WHU-SAS/aic-robot/README.md

# AIC Robot｜视觉追踪与自主抓取机器人

基于 **K230 与 MSPM0** 的移动抓取机器人，面向 **20 mm 蓝色方块**，完成视觉追踪、底盘接近、停车定位和机械臂抓取，并在夹取失败或目标丢失后恢复任务。

当前主线由 K230 运行视觉、语音与任务逻辑，MSPM0 执行底盘控制；整车任务在板端运行，电脑用于开发、部署与调试。

## 功能演示

三段实物演示，分别展示正常流程与两种异常恢复。**以下视频均为 2 倍速播放，标注时长为视频播放时长，非实际任务耗时。**

### ① 自主追踪抓取 · 约 9 秒 · 2 倍速

**正常任务：** 追踪方块 → 接近停车 → 定位抓取 → 抬升。

https://github.com/user-attachments/assets/8727d0c5-af14-46ac-8d45-5f98477f9e53

### ② 夹取失败重试 · 约 14 秒 · 2 倍速

**看点：** 首次夹取未成功后，机器人恢复观察、重新定位并再次尝试抓取。

https://github.com/user-attachments/assets/ede22e75-522a-4e8c-8239-ee370f32e1b9

### ③ 目标重搜与追踪 · 约 13 秒 · 2 倍速

**看点：** 方块被人为移开后，机器人重新搜索，找到目标并恢复追踪。

https://github.com/user-attachments/assets/4cd675e8-9e65-4bd4-8ff4-0e870b1a4405

视频展示单次实物运行场景，重复运行的稳定性、成功率与定位精度仍需单独验证和统计。

## 系统组成

| 组成 | 职责 |
| --- | --- |
| **K230** | 语音触发、视觉定位与目标追踪、整车任务调度及机械臂指令 |
| **MSPM0** | 车轮速度、直行与转向控制，以及编码器反馈 |
| **六轴机械臂** | 停车后执行定位抓取与抬升 |

K230 通过 UART 与 MSPM0 通信，并通过 URT-2 连接机械臂舵机。硬件型号、供电和接线见 [硬件说明](docs/hardware/connections.md)。

## 当前进展

| 范围 | 状态 |
| --- | --- |
| **已演示** | 自主追踪抓取、夹取失败重试、目标丢失后的重搜与追踪，见上方视频 |
| **仍在验证** | 重复运行稳定性、任务成功率、定位与抓取精度，以及不同场景下的表现 |
| **尚未实现** | 指定位置放置、独立视觉持物验证 |

当前夹住判断依据夹爪舵机反馈，不等同于独立视觉确认；相机标定的拟合误差也不直接代表实物抓取精度。当前版本、测试条件和验证边界见 [全流程追踪说明](docs/guides/full-process-tracking.md)。

## 文档导航

| 想了解什么 | 从这里开始 |
| --- | --- |
| **项目展示素材** | [精选图片、简要介绍与可复制片段](docs/showcase/README.md) |
| **人机协作复盘** | [我与 AI 如何协作：方案审查、实机反馈与项目纠偏](docs/ai-collaboration/README.md) |
| **整车运行与部署** | [完整任务指南](docs/guides/robot-task.md) · [当前追踪流程](docs/guides/full-process-tracking.md) |
| **视觉与抓取实现** | [视觉模块](docs/guides/vision.md) · [机械臂基线与参数](docs/guides/arm/BASELINE.md) |
| **硬件与接线** | [硬件型号、供电和连接](docs/hardware/connections.md) |
| **开发、编译与联调** | [板端测试与固件工具](docs/guides/k230-and-mspm0.md) · [Linux PC 辅助环境](docs/guides/linux-arm.md) |
| **早期演示与对照** | [第 0 版 PC 辅助抓取](demos/v0_blue_pick/README.md) |

行驶时机械臂保持准备位与扭矩，停车后执行抓取；操作要求见 [准备位说明](docs/guides/arm/准备位脚本.md)。

代码按运行位置组织：`device/` 为板端程序，`host/` 与 `tools/` 为 PC 端程序及开发工具，`configs/` 为运行配置，`models/` 为机械臂模型。早期 PC 辅助方案保留作对照，与当前板端主线分开说明。

## 源码可见与使用许可

本项目整体未采用开源许可证。团队原创且未另行授权的内容保留权利，额外使用须获得相关权利人许可，法律或已有授权另有规定的除外，详见 [版权与权限说明](LICENSE)。

第三方内容继续适用各自许可证，见 [第三方依赖](third_party/README.md)。公开查看和站内 Fork 按 GitHub 服务条款执行，不额外授予团队原创内容的自由运行、复用、修改或分发许可。
