WHU-SAS/aic-robot/car-arm/README.md

# 旧命令兼容入口

开发和运行使用 [仓库根目录](../README.md)。本目录只转发旧命令，不保存另一套代码或参数。

例如原 `./scripts/host hardware/move_ready.py --execute` 对应根目录 `./scripts/arm-ready --execute`；原 `hardware/k230_blue_pick_onboard.py` 对应 `./scripts/pick-blue`。新采集与日志在根目录 `data/`。
