WHU-SAS/aic-robot/device/mspm0/motor_uart/README.md

# K230 控制底盘：启停与状态回传

2026-11-03 已安装有限程FOLLOW固件，映像SHA为`c6eda69405f6b624d29537578bd91c0faed64667802b8ac6d634f1b6e09b8e31`。原始22888字节TI BSL CRC为`634b10e4`，按1024字节页填充至23552字节的TI CRC为`9940b381`；标准zlib CRC与TI口径不同，不混用。独立双映像CRC、写入范围外重复CRC及K230实际UART零轮速核验通过；未做非零有限程实车试跑。主控已启动且零输出，配套K230 `84482ada8908c040`已回归、安装并确认重启后持续监听，当前状态见[全流程指南](../../../docs/guides/full-process-tracking.md)。底盘与机械臂运行参数保持原基线。

## ARC与毫米级短MOVE（基本起转已验，精度待验）

新增请求体`M,SSSSSSSS,ARC,left_mm,right_mm`，两轮分别为−32767～32767整数毫米，正前进、负后退、0不驱动该轮。`ARC,0,0`仅在空闲时接受并以`reason=8`完成，双轮不输出；忙碌时仍拒绝新动作。普通ARC由每轮相对编码器行程执行，双轮分别截止，全部完成以`reason=8`结束。v2字段不变，`remaining_ms`仍是5秒运行预算，不是剩余轮程；不能只凭版本号2确认ARC能力。

短MOVE（绝对距离≤30mm）及ARC共用执行器：最大轮程≤30mm时主轮最高15mm/s，更长ARC使用`min(80,max(15,2×主轮剩余毫米数))`和原150mm/s²参考加减速，仍须在原5秒预算内完成。各轮按目标距离比例给速，归一化进度同步；先用原32计数/10ms缓升起转，行程到0.1mm后交给原PI，交接预置积分只允许0～500，不把低输出预置成负积分；正常PI本身仍可在原−500～500内调节，原32/10ms输出缓变保持。各轮按自身速度×0.08s、最小0.1mm预测滑行，独立撤去输出并锁定，不会因另一轮尚未结束而重新启动。MOVE仍以`reason=6`结束。长MOVE、TURN、FOLLOW的控制分支及共享PI公式保持；原20%输出上限、B21、1秒通信租期及5秒动作时限沿用，重复/过期命令不重启、不延长动作。0轮仍可因车身牵动被动滚动，不宣称机械锁止。

K230每次纠偏向固定停车目的点规划一段弧线，最多30°且各轮不超过100mm，再拍新图验窗。原单次对照包仍只允许一次纠偏；新`--tracking`入口取消纠偏次数上限，当前安装状态见小车指南。模型覆盖正反短MOVE、同比例/异比例/混合方向/单轮ARC、计数回绕及停后不重启；合成负载中的小误差不是实车毫米精度保证。升级须先下载并核验本固件，再激活配套K230包；零轮程ARC只验证通信和无输出，基础起转已短试，整车停车窗口仍需现场测试。

短动作合成模型最大短/长驱动轮误差由原约0.731/0.693mm增至约1.420/1.292mm，离线数值界明确改为1.5mm；保留全部完成、方向、停后不重启和既有限制检查。长MOVE原5%模型界及TURN/FOLLOW参数不变。这是修复起步的明确取舍，不能把模型界当作实物误差保证。

2026-10-30曾运行`v2+MOVE+TURN+FOLLOW`连续轮速版，USB/BSL下载、独立映像CRC及范围外Flash重复核验完成，17项底盘测试通过。K230零轮速FOLLOW→SPEED→STOP及停车后SPEED拒绝重启已通过原生检查。固定方块连续接近已接入一次移动细测、编码器补偿及停后窗口检查；用户认可K230版本`16060786e9fe3e29`的现场效果并暂定为基线，超过95%首次入窗尚未统计验收。当前固件支持有符号MOVE；原正向MOVE/TURN参数及保护保留，实际负向闭环微调仍待现场检验。当前入口与实验状态见[小车指南](../../../docs/guides/car-approach.md)。

前阶段适配器下左右5°、15°各5次共20次基础验证通过，用户确认方向正确、平顺、停后未再挪动，全部原因7及停后零输出；其后电池下单步及三轮自动分段视觉接近也已完成基本运行。旧TURN整链路比例0.75保留，新连续模式不用它。完整原始记录及失败证据保存在本机`data/car/turn/`及`data/car/visual_align/`。

## FOLLOW / SPEED：连续更新轮速

请求体`M,SSSSSSSS,FOLLOW,left_mm_s,right_mm_s`显式启动，`SPEED,left_mm_s,right_mm_s`仅更新正在运行的连续任务；两轮整数目标均为−80～80mm/s，正值向前。沿用v2应答格式；不能仅凭版本号2推断具备此能力。

启动仅一次清空轮速PI和参考速度。之后SPEED保留PI、PWM、速度参考及累计时限，每10ms根据编码器分别控制两轮；参考加减速150mm/s²，PWM每10ms最多变化32、上限1600/8000。有意转弯时两轮目标不同，不叠加旧MOVE的累计轮程同步。零轮速关闭固定前馈并将该轮输出降到零，STOP立即撤去双轮输出。

用户批准仅FOLLOW总时限为20秒，旧START/DRIVE/MOVE/TURN仍5秒；SPEED续原1秒通信租期但不重置20秒计时。B21、重复/过期命令语义及停车后不得自动重启不变；停止后SPEED返回result=3，必须另发新的FOLLOW才可启动。`remaining_ms`在新模式可达20000，reason=3现表示该模式的总时限到。旧`target_left/right`仍是PWM字段，不能当作mm/s；请求轮速保存在K230会话计划中。

本版有限前进增加可选第四项：`FOLLOW,L,R,D`从空闲启动，`SPEED,L,R,D`在原FOLLOW内更新；L、R为0～80mm/s，D为接收该命令时、尚未扣除滑行的正向名义剩余轮程，0～65535整数mm。主控锁存当时两轮编码器，按每10ms的平均轮程更新剩距，并沿用70/50mm/s、增益2及0.12秒滑行模型调速、以`reason=6`截止。更新不清PI、PWM、速度参考或20秒累计时限；重复/过期序号不重设端点。普通三项SPEED显式清除原有限程，反向搜索和慢退继续使用原有符号接口。

只有本次有限FOLLOW自行按距离结束后，新的带D轮速更新才允许返回成功应答的`run=0,reason=6`，不重新启动；其它停车原因和普通SPEED的拒绝语义不变。`FOLLOW,0,0,0`／`SPEED,0,0,0`可在空闲作零输出能力核验，不制造一次已执行的有限程任务。K230收到距离完成仍须拍新静图验窗，不能用旧行进图交臂。这是核心距离控制，不增加时限、重试上限或任务失败条件；需配套新固件，旧v2号不能证明支持D。名义轮程、曲线与滑行模型不保证真实物理停车误差，当前70/50/2及0.12参数变更须同步两端实现。

独立核验记录：`data/logs/mspm0_continuous_verify_20261030_180036/`及`mspm0_continuous_outside_start_20261030_180036/`。首次下载核验响应不一致仍保留，未重刷，后续独立映像两次CRC及范围外两段各两次CRC匹配后才启动。旧固件备份在`data/car/straight/sync_fix_20261030/sources/motor_uart.hex`。

底盘基础v2联调记录：2026-10-29通过USB/BSL下载，独立会话两次映像CRC匹配，写入范围外Main Flash两段各重复两次CRC均与下载前一致；随后通过K230确认协议v2、状态20/20和零输出。早先架空单轮试转中，左轮10%可转，右轮10%仅轻抖、改20%/1秒后形成持续转动。早先左轮负PWM计数同号的记录不作反转结论，后续落地双轮后退已由用户确认。用户可能手动挪动车，需结合驱动时段及现场反馈解释计数。

用户规定短测试直接落地，不再要求架空；每次前进不超过100mm，长距离测试先等用户整理桌面。准备位已由用户确认停稳；400/600ms前进及600ms后退方向、停车均确认，600ms前进明显不到100mm、无明显偏转。含滑行标称换算约28mm；RAM短测试带标称20mm编码器提前STOP，比例未经实测，不把标称值当物理距离保证。

早期独立轮排查记录：左轮−1600、右轮+1600、600ms时主要后退，原始计数A−/B+也与后退一致，未继续执行对向双轮反向转动。实际`motor_output`函数的模拟检查不能证明实物引脚电平或负载下起转。右轮单独正转由用户确认明显左转，左轮单独正转确认明显右转，因此后续TURN采用单轮弧线转向，5°/15°实测范围见下文。每步后输出归零、编码器稳定、语音恢复。早期记录见本机`data/car/ground_steps/LATEST.txt`；旧PWM分段参数不作为当前连续模式入口。

2026-10-20的v1版本已完成架空轮启停测试，用户确认两轮正常转动并停止、无异常。下文原有运动验收记录均为v1，不能当作v2新增独立短动作的实测结果；新增功能见本页末尾。

本次下载后的首次校验有一次CRC不一致，未因此重写或直接启动；独立核验通过后才发送启动命令。启动UART0提示未捕获，运行版本由UART2状态确认。原失败记录与后续核验记录均保留于本机，统一入口为`data/car/firmware/LATEST.txt`；CRC核验不代表逐字节回读。

## 已确认的首轮运行方式

- 上电停车，新的 START 才启动；方向沿用 `motor_encoder`，A=左轮、B=右轮（10月20日用户手转左轮、只读采样确认）；用户确认当前运行方向为车头方向，前进计数A正、B负。
- 10 kHz PWM，约0.5秒升到1600/8000（20%占空比），每次最多5秒。
- K230 每轮心跳后等待200毫秒；连续1秒无新有效心跳，天猛星停止输出。STATUS 不续期；恢复心跳不会自动启动。
- B21 只停车，不启动；30毫秒消抖，按住时拒绝 START。2026-10-20实机短按停车通过，停车后继续心跳观察2秒未重启，编码器最终稳定。
- 停车令 STBY=0、PWM=0，车轮可惯性滑行；不代表机械制动或车速立即为零。

机械臂不参与本测试；PID、准备位和机械臂运行参数不变。

## 运行

下列架空长序列及约1秒前进命令保留作历史实验参考，不作为当前桌面测试默认入口。按用户最新规则，短测试直接落地并限制前进每次不超过100mm；长序列须先通知并等用户整理场地。当前400/600ms带编码器保护的脚本随本机落地记录归档，不能将历史5秒运行测试直接用于桌面。

接线与原例程一致：[底盘引脚](../motor_encoder/README.md#接线)。K230 IO5 TX→PA09 RX，IO6 RX←PA08 TX，GND共地，115200/8N1。IDE停止并断开。

仓库根目录执行，可重复运行，无须重启两板：

```bash
./scripts/host tools/diagnostics/test_k230_motor_uart.py                # 20轮状态查询，不启动
./scripts/host tools/diagnostics/test_k230_motor_uart.py --stop         # 停止输出并复查
./scripts/host tools/diagnostics/test_k230_motor_uart.py --execute --wheels-lifted
./scripts/host tools/diagnostics/test_k230_motor_uart.py --execute --wheels-lifted --button
```

最后一条必须先可靠架空两轮、手离开车轮。自动序列：坏校验帧不得启动 → START及重复命令 → 缓升并读取两路编码器 → STOP → 重新启动验证5秒时限 → 重新启动后不发心跳，验证1秒断链停车 → 最终STOP。遇错尝试STOP；脚本或USB连接消失后，由天猛星定时中断执行心跳超时。

`--button`单独测试B21：先等待5秒，再启动一次；车轮转动时短按B21，要求收到`reason=2`及零输出，继续发送心跳观察2秒不得重启。没有按到、只触发5秒时限或其他异常均判失败，不自动重试。

记录在本机 `data/logs/k230_motor_uart_*/`，不提交。首次实测：5秒停车首次被轮询观察到为5.18秒，断链为1.00秒；这是采样观察时刻，非直接测量PWM边沿。两路原始计数均变化。尚未实测每圈计数或距离比例，也没有恒转速闭环；后续先按下述资料标称参数换算。

## 标称每圈计数与短前进

参数集中于 [drive_nominal.json](../../../configs/car/drive_nominal.json)。本机照片标签是MG513XP28_12V；28:1按P28标称型号采用，并由[同型号系列的原作者硬件项目](https://oshwhub.com/ylc00/simple-pid)交叉核对。该项目是霍尔版，不能用其13线数替代本机编码器版本。

[轮趣电机开发手册表3-1（转载副本）](https://www.scribd.com/document/1000178757/Wheeltec-直流电机开发手册-2025-10-20)列出GMR500ppr带塑料后盖，霍尔13ppr为裸露。结合本机后盖照片及已有计数规模，本项目暂按GMR500ppr计算；这是版本推定，尚无订单型号或整圈测量确认，不能表述为实测500线。若版本判断改变，必须重新计算比例。

| 参数 | 初始值与依据 |
| --- | --- |
| 轮胎直径 | 65 mm，采购清单标称值 |
| 减速比 | 28:1，MG513XP28型号标称 |
| 编码器 | 暂按GMR500ppr，电机转子每圈单相周期数 |
| 解码倍频 | 2，程序对AB两相各采上升沿 |
| 轮子每圈计数 | 500 × 28 × 2 = **28000** |
| 轮子周长 | π × 65 = **204.2035 mm** |
| 每计数距离 | **0.00729298 mm**，对应每100 mm约13711.81计数 |

霍尔13线版在相同减速比/2倍频下是728计数/圈，不能与28000混用；4倍频时GMR才是56000。本轮手转没有数圈，不用于推算减速比或PPR。当前软件中断计数存在丢边沿可能，标称比例也不等于实测里程精度。

首次地面测试只做**约1秒前进后STOP**，输出仍为原20% PWM、0.5秒缓升；5秒运行时限和1秒断链停车仍在。不按估算距离闭环停车，不自动重试，不自动调PID；结束后再读取2秒计数以包含滑行。PC根据标称参数输出两轮位移，明确标注未实测标定。2026-10-20已在机械臂保持准备位时完成首次落地实测，用户反馈无异常：驱动约1040 ms，含滑行左轮19159计数、右轮17678计数，标称换算平均134.3 mm；约11 mm轮程差不等于已测得的车身航向偏差。停车后PWM为0，编码器稳定。持续带载及精确定距/转向尚未验证。

在地面路径清空、线缆留有余量、机械臂已回准备位并保持扭矩、现场有人观察后执行：

```bash
./scripts/host tools/diagnostics/test_k230_motor_uart.py --execute --forward-once --on-ground
```

架空测试同一动作则将 `--on-ground` 换成 `--wheels-lifted`。两个标志不可同时使用。约1秒由K230脚本计时并发STOP，串口往返有延迟；不是固件新增长度1秒的硬时限，也不是定距命令。固件无须重烧，机械臂准备位另用既有 `./scripts/arm-ready --execute`，本脚本不控制机械臂。

## 协议

请求 `@M,SSSSSSSS,COMMAND,CCCC\n`，命令为 `STATUS/START/STOP/HB`。
应答 `@R,SSSSSSSS,COMMAND,result,ms,run,pwm,encoder_a,encoder_b,reason,last_seq,CCCC\n`。

序号为8位大写十六进制，CRC为4位大写十六进制。CRC-16/CCITT-FALSE（初值FFFF，多项式1021，无反射及最终异或）覆盖 `@` 之后、校验字段前最后一个逗号之前的字节。`123456789` 对应29B1。

- `result`：0成功，1重复未重做，2旧序号，3正在运行或按键按住而拒绝START。
- `reason`：0上电/运行，1STOP，2B21，3五秒时限，4心跳丢失。
- `ms` 为上电毫秒，`encoder_a/b` 为有符号原始累计计数（32位回绕）；复位归零。
- 除STATUS外，接受的新命令推进 `last_seq`，按32位序号前后关系判断。新客户端先STATUS读取该值再发送新序号；单个控制端使用，不能并行启动多个客户端。
- 重发START不重新启动、不延长时限；运行中新的START返回忙。重复HB不续期，旧STOP仍停车。
- 帧过长、命令错误、校验错误不执行；任何位置的 `@` 重新同步，兼容此前冷启动前导噪声。

定时中断每10毫秒处理PWM与两项超时；串口解析、CRC和应答在前台，STOP在应答前实际撤去输出。无主动推送，以命令/心跳应答返回状态。

## 构建与下载

```bash
./scripts/mspm0-build motor_uart
./scripts/mspm0-tools python -m unittest discover -s device/mspm0/tests -v
./scripts/mspm0-tools python tools/diagnostics/mspm0_bsl.py \
  --hex device/mspm0/motor_uart/build/gcc/motor_uart.hex --execute
```

下载按键和CRC复核见[板端联调](../../../docs/guides/k230-and-mspm0.md#当前下载方式主控-usb--bsl)。本工程目前提供Linux GCC/BSL入口，无单独Keil工程；复用 `motor_encoder/ti_msp_dl_config.c/.h`，原独立按键例程保持可用。UART1使用电机配置下的40MHz BUSCLK，波特率分频21/45，不能套用32MHz独立UART例程的17/23。

## v2：左右轮独立短动作（前后与单轮转向已确认）

新增请求体 `M,SSSSSSSS,DRIVE,left_pwm,right_pwm,duration_ms`，仍按前述规则加 `@`、CRC及换行。

另有已烧录并完成CRC核验、已完成10次150mm落地语音运行的`v2+MOVE`版本：请求体`M,SSSSSSSS,MOVE,distance_mm`（正整数毫米），应答仍为v2字段，命令名为`MOVE`，距离截止停车原因是6。此能力不能仅凭应答版本号2推断存在。`straight_control.h`在10ms定时器中使用编码器反馈，按两轮平均轮程估计前进距离，以轮程差修正方向、轮速PI调整输出；参考速度随剩余距离降低，到预计滑行距离时一次撤去输出，不补走。编码器中断高于定时器优先级，浮点计算期间仍可累计边沿。已有20%上限、32/10ms输出缓变、B21、1秒心跳超时、5秒上限继续沿用，没有新增故障保护或自动重试。

2026-10-30已下载的新版本将同一`MOVE,distance_mm`扩展为有符号整数毫米：`1～65535`保持前进，`−1～−65535`表示闭环后退；0仍不接受。后退将编码器位移与速度投影到请求方向，复用相同轮速PI、同步系数10、加减速和提前截止，再输出负PWM；不是开环定时反转。内部距离仍存uint16绝对值，方向另存，v2应答字段和正常距离截止`reason=6`不变，原MOVE的5秒、1秒续租与B21不变。新版本已完成下载、独立双映像CRC及写入范围外Flash CRC核验后启动，CRC为`a09cb35a`，映像SHA256为`2fa60df877e4d0d9a6dea5763d045941924fb2fa29c169358a2dd2020652e4b9`。实际零轮速FOLLOW/SPEED组合检查通过；负向闭环MOVE的落地效果仍待现场检验，不能仅凭旧v2应答推断能力。记录见本机`data/car/one_shot_parking/mspm0_signed_move_*_20261030/`。

首版参数：巡航80mm/s、收尾25mm/s、参考加减速150mm/s²、速度PI为P=5/I=4、轮程差修正系数3、前馈`1000+3×参考速度`；停止预测为当前滤波平均速度×0.12s（最小0.5mm）。0.12s参考旧400/600ms地面短步中输出归零后的滑行量，是起始估计，尚非低速实测拟合。现已有100mm×5、150mm×10、300mm×5共20次落地运行，用户确认正常、平稳；各次标称编码器平均轮程在目标±5%内，基本运行和重复性通过。物理距离误差未经外部测量确认，参数保持不变。

- 两轮PWM分别为有符号整数，范围−1600～1600；正值沿用已确认的车头方向，负值反转，0撤去该轮输出。PWM周期仍为8000，每10ms向目标变化最多32计数。PWM不等于实际轮速，短脉冲也不保证电机已经起转。
- 时长必须明确指定，为10～5000ms、10ms整数倍，从固件接受命令开始计时，包含缓升时间。运行中新的非零DRIVE返回忙；重复命令不重新执行、不延长时限。同序号而参数不同视为旧命令。
- 到指定时长停车的 `reason=5`；到5秒硬上限仍为 `reason=3`。1秒心跳丢失停车、B21停车、旧STOP仍停车及恢复心跳不重启的行为保留。
- 新的 `DRIVE,0,0,时长` 立即撤去两轮输出，`reason=1`。每轮停止仍为撤驱动/滑行；不新增主动制动或运动中反向切换策略。

v2应答在原11个字段后追加：`2,left_pwm,right_pwm,target_left,target_right,remaining_ms`。原`pwm`字段取两轮实际输出绝对值的最大值；`left/right_pwm`是当前输出，`target_left/right`是请求目标。STATUS/START/STOP/HB请求仍可用，客户端须使用仓库新版解析器以接收追加字段；新版客户端也能解析v1应答。`MotorLink.drive`先检查已同步状态的版本，v1固件会在发送DRIVE之前被拒绝。

验证时先烧录v2，再由现场确定输出和时长。以下仅为命令格式示例，参数不是已验收的速度或转角：

```bash
# 左右轮各800/8000输出400ms，到时由MSPM0撤去输出
./scripts/host tools/diagnostics/test_k230_motor_uart.py \
  --drive 800 800 400 --execute --wheels-lifted

# 左轮反向、右轮正向的转动脉冲
./scripts/host tools/diagnostics/test_k230_motor_uart.py \
  --drive -800 800 300 --execute --wheels-lifted
```

单次脉冲动作必须显式提供三项参数与`--execute`，并声明`--wheels-lifted`或`--on-ground`；不能与其他动作模式混用。默认仍只查状态。上述`DRIVE`仅按PWM/时长运行；轮速PI及定距由`MOVE`提供，新增定角由下述`TURN`提供。

离线C状态测试覆盖正反独立缓升、单轮停转、定时停车、重复/旧参数、断链、5秒上限和按键；K230真实客户端与C模拟器互通覆盖前后、左右原地转动及单轮输出。构建和映像检查见前述命令。受沙箱ptrace限制，本轮原生C测试用`ASAN_OPTIONS=detect_leaks=0`运行，地址及未定义行为检查仍开启。

当前直行同步修正版已下载：电池下前进出现右轮累计行程领先、车身左偏，只将`STRAIGHT_SYNC_GAIN`由3提高到10。编译及16项测试通过，转向模型输出相同；独立映像CRC及范围外Flash重复核验通过，主控零输出和原K230监听恢复已确认。首轮复验6次100mm的停稳轮程差绝对值约0.08～1.86mm，用户反馈略有改善但仍左偏，直线效果尚未通过。暂保留系数10，区分真实偏航/侧移与画面偏移后再调整；不能只凭最终轮程接近就宣称车身走直。用户已决定将盲走直线略微不足留待后续改善，暂不继续调参，转入视觉闭环接近。版本与数据见本机`data/car/straight/sync_fix_20261030/preparation.json`。

## TURN：指定角度弧线转向（新版左右5°及15°基础验证完成）

视觉入口的`turn_gain=0.75`是用户认可的整条链路经验补偿，与本版底盘控制绑定。以后修改转向控制、转向方式或轮距/编码器换算，需同步复验并按结果重估该比例；不能把它当独立的视觉标定常数。约定见[小车指南](../../../docs/guides/car-approach.md#视觉转向比例与底盘控制的联动约定)。

新增请求体`M,SSSSSSSS,TURN,angle_deg`，正整数1～30左转、负整数−1～−30右转，不接受0。应答仍是相同v2字段，命令名为`TURN`，按角度截止的停止原因是7；不能仅凭版本号2推断板上支持此命令。当前运行固件已通过独立CRC核验并升级，映像启动标记为`v2+MOVE+TURN`（UART0标记未捕获，不据此宣称已读到启动横幅）。

`turn_control.h`以标称轮距119.2mm计算`角度=(右轮行程−左轮行程)/轮距`，A正/B负为前进。左转仅驱动右轮，右转仅驱动左轮；被动轮即使滚动也参与计算，因此是带平移的弧线转向。15°对应31.2065mm两轮行程差。单轮方向已实测确认；旧版左右15°各5次基础运行通过。起步修正版已烧录并核验，原0.12秒滑行预测版左右5°各5次运行正常但转角偏小；0.03秒版左右5°及15°各5次通过，实车验证范围限于这两个角度大小。

本机起步修正版新增`TurnControl`起步状态：仅驱动目标轮按原缓升至1600（20%）上限，标称前向轮程差达到1mm后锁定交回轮速PI，同一动作不再次进入起步阶段。该修改属于核心起转控制。电池下复测仍失败，适配器下重复运行通过，不能将恢复单独归因于代码修改；此前15°数据属于旧版控制。

每10ms滤波两轮速度，按剩余轮程差生成40mm/s巡航、20mm/s收尾参考，参考加减速150mm/s²；以被动轮速度修正驱动轮参考，驱动轮参考仍限制为0～40mm/s。复用直行轮速PI、前馈及输出缓变；剩余量不大于滤波轮速差×0.03s（最小0.5mm，转向专用；左右5°及15°各5次已测）时一次撤去两轮输出，不补转。已有B21、心跳及5秒时限保持，未增加新故障保护或主动制动。直行算法及参数原样保留。

K230独立语音部署与测试安排见[小车指南](../../../docs/guides/car-approach.md)。转向记录包含目标角度、编码器估计角度、两轮轮程及原始状态；不会将直行±5%自动用于转角验收。离线测试覆盖左右1/3/5/15/30°、被动轮滚动、计数回绕、停止后不再输出，以及与真实K230协议客户端互通。模型通过只说明候选控制逻辑符合预期，实际转角尚未外部测量。
