WHU-SAS/aic-robot/docs/showcase/profile-snippet.md

### 思达｜视觉追踪与自主抓取机器人

基于K230、MSPM0与六轴机械臂，围绕20 mm蓝色方块，实现语音触发、视觉追踪、底盘接近、停车定位及抓取，并已演示目标重搜和夹取失败重试。

**技术方向：** 嵌入式视觉、几何定位、编码器闭环控制、机械臂运动学与车臂协同。

<p>
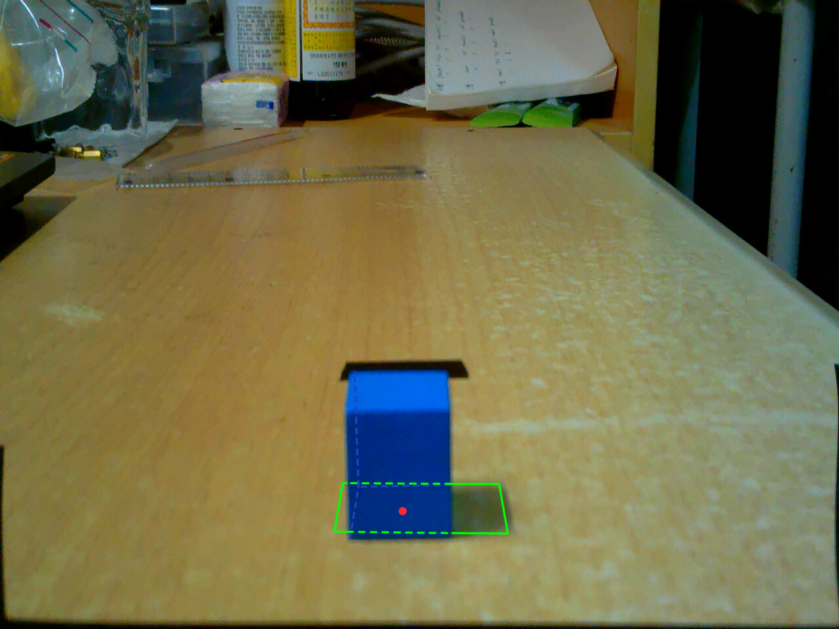
[picture p1: docs/showcase/images/03-parking-window.png]
停车区域与方块底面中心示意，使用历史配置
  
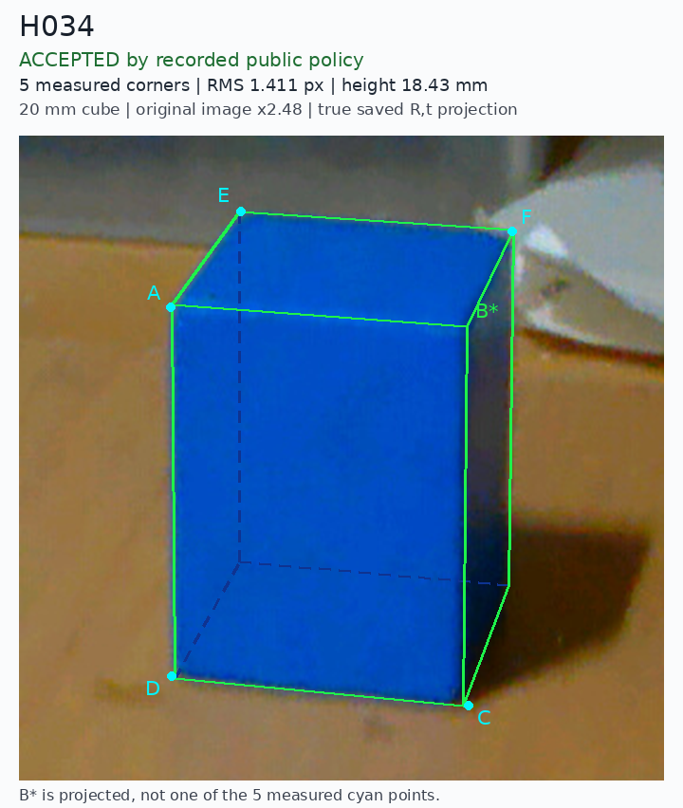
[picture p2: docs/showcase/images/09-cube-model-projection.png]
五个测量角点与20mm立方体模型重投影
  
</p>

[自主追踪抓取（2倍速）](https://github.com/user-attachments/assets/8727d0c5-af14-46ac-8d45-5f98477f9e53) · [夹取失败重试（2倍速）](https://github.com/user-attachments/assets/ede22e75-522a-4e8c-8239-ee370f32e1b9) · [目标重搜与追踪（2倍速）](https://github.com/user-attachments/assets/4cd675e8-9e65-4bd4-8ff4-0e870b1a4405)

[粗定位演示（9.2秒，原速）](https://github.com/WHU-SAS/aic-robot/blob/main/docs/showcase/videos/blue-cube-coarse-localization.mp4) · [项目仓库](https://github.com/WHU-SAS/aic-robot) · [更多图片与说明](https://github.com/WHU-SAS/aic-robot/tree/main/docs/showcase)

三段实机任务视频均为2倍速，播放时长不代表实际任务耗时。粗定位视频为原速，基于K230原片经电脑后期叠加检测框与估距；图片包含算法标注及历史示意。重复运行稳定性与精度仍在验证。
