WHU-SAS/aic-robot/docs/ai-collaboration/arm-cases.md

# 机械臂协作案例

机械臂开发中，我承担现场观察、实验条件、参数取舍和动作规则的决策，AI负责代码、运动学分析与回归实现。下面按问题链整理四个案例；用户干预采用协作过程的转述，链接的仓库文档和提交用于核对实际落地，不代替原始对话或实物验收。

## 追问45 mm补偿，回到模型与实物是否对应

**问题。** 夹爪总差一段距离时，我们早期采用过经验偏移，最后需要约45 mm才能对准。AI继续围绕参考点和补偿调整，却没有先充分核对固定爪、活动爪、安装朝向及关节转向。数值拟合看似合理，也可能掩盖错误装配假设。

**我的干预。** 我没有把暂时夹得准当作原因已经解释，继续追问为什么恰好需要这段补偿，并质疑机械臂几何模型（URDF）与实物的对应关系。我提供正面照片、明确两根指爪的身份，保持姿态，配合逐个轻动2、3、4号关节，供AI只读编码核对方向；随后同意用修正模型、配套外参和0 mm经验补偿重新测试。

**AI随后的修改。** AI据实物方位证据修正根安装朝向及2、3、4号关节轴，重新配套外参，并用哈希核对模型、编码映射与标定。正式抓取取消旧45 mm补偿，不把偏移混入相机输出的原始坐标。

**结果与限度。** 我在现场反馈一次抓取已夹起且对位较准，随后认可将修正模型作为默认。代码测试还覆盖PC与板端正运动学一致、多个位置和腕角的逆运动学对照及配套配置拒错。但历史触顶标签仍是人工接触与CAD端点代理，不能说模型修复已经精确解释全部45 mm，或全工作区精度已经验收。后续另试过的小幅补偿也不能与这次旧45 mm的取消混为一谈。

依据：[PC抓取验证](../guides/arm/PC_PICK_VALIDATION.md)、[修正模型](../../models/genkiarm/genkiarm_corrected.urdf)、[配套外参及物理证据来源](../../configs/vision/trials/model_alignment_20261030_extrinsics.json)、[模型一致性测试](../../host/tests/test_arm_model_alignment.py)。落实提交：[修复候选 a4d4857](https://github.com/WHU-SAS/aic-robot/commit/a4d48572e2803540ff7c239e2ef53768f1e8f0d3)、[成为默认 2fdbebe](https://github.com/WHU-SAS/aic-robot/commit/2fdbebecd4c4941ad90a067827ff6300b008386f)。

## 把PID调试收敛为固定动作、单项改参和现场判断

**问题。** 前期AI安排了多轮自动筛参和检查，反复中断，也未充分区分单轴轻晃、近中立多轴联动抖动、承重偏差和静止时来回修正。有限编码采样与统一门槛不能替代我看到的实际动作效果。

**我的干预。** 我先指出单舵机轻微晃动可以接受，主要问题是2、3号同步和中立附近运动；又把承重精度放在更高优先级。随后要求由我指定参数，AI重复相同的一次同步动作，记录各轴来回修正和有符号最终偏差，我在现场判断改善与否。调试中也安排不同相似姿态复测，而不是只看一组动作；确定阶段基线后，要求后续遇到新问题再有针对性微调。

**AI随后的修改。** 项目形成近、中、远三组固定目标对照脚本，每段一次同步发送最终目标，保存六轴反馈、实际参数与采样时刻。偏差、修正时间、尾段波动等指标用于记录，不作为每轮新增的中止门槛；最终采用我选定的参数配置。早期口头反馈式试错与后来的固定脚本是逐步收敛的过程，不是从一开始就有完整实验设计。

**结果与限度。** 参数选择和动作复现有了明确基线，测试覆盖固定发包、不改写PID、缺失反馈及未收敛时不虚报停稳。它不能证明已找到全局最优PID：总线采样可能漏掉高频振动，固定三姿态也不能代表所有负载和运动。这里不以对话轮数或主观耗时对比宣称调参效率提升多少。

依据：[固定三动作对照及指标定义](../guides/arm/PID_THREE_ACTIONS.md)、[当前舵机基线](../guides/arm/BASELINE.md)、[用户选定参数及采用记录](../../configs/arm/user_selected_pid_demo_baseline.json)、[脚本测试](../../host/tests/test_pid_three.py)。落实提交：[固定动作工具 0ef23b4](https://github.com/WHU-SAS/aic-robot/commit/0ef23b42b716851f402662a2d028ee8d3fa10038)、[采用2、3号参数 993653c](https://github.com/WHU-SAS/aic-robot/commit/993653c5ce3bc07fe3b59b4d140f4c1327dc0a76)。

## 区分动作完成、夹住证据与抬升成功

**问题。** 闭爪后舵机停下、四段动作完成，都不能直接证明方块被夹起。整车联调还暴露出阶段规则冲突：夹取造成的遮挡和物块正常移动，不应继续按桌面目标外移处理，否则恢复动作反而可能张开已经夹住的爪子。

**我的干预。** 我提出利用6号被物体阻挡的特征，直接确定Δ＝实际停位−闭合目标：Δ＜30判空夹，Δ≥30视为夹住。进一步明确夹取前悬停的±30与抬升后的±10不是同一标准；6号离开±1稳定带但Δ仍≥30时，应保持夹持、重新观察0.2秒，而不是立即松爪重来。后续还明确选择闭合、抬升阶段暂停视觉，用原舵机反馈完成确认。

**AI随后的修改。** 闭合采用连续5次同一±1带的稳定样本和上述Δ；追踪版抬升以1～5号±10判断到位，6号另验阻挡与200 ms稳定，读失败记为未知。把受阻6号排除出普通到位检查，是AI为使用户条件相容作出的实现处理。闭合开始后暂停采图、粗定位与视觉外移判断，空夹或失夹恢复后再重启观察；动作完成、编码器夹住与整车任务成功分别记录。

**结果与限度。** 回归覆盖Δ29/30、固定稳定带累计漂移、读取失败、出带后保持夹持，以及旧视觉调度使确认窗口反复失效的场景。模拟测试验证了规则与发包顺序，不等于现场成功率；其他障碍也可能阻挡夹爪，编码器判据不能代替独立实物验收。项目展示中的失败重试视频是一次运行记录，也不是统计证明。

依据：[机械臂追踪与恢复接口](../guides/arm-tracking.md)、[夹住判定测试](../../host/tests/test_grip_confirmation.py)、[分步执行边界测试](../../host/tests/test_arm_pick_execution.py)、[闭合／抬升暂停视觉测试](../../host/tests/test_grip_vision_pause.py)。落实提交：[初次Δ判据 accec90](https://github.com/WHU-SAS/aic-robot/commit/accec9000eea7eb7cb44a7ab5e338e61fe42d037)、[分步执行器 159152a](https://github.com/WHU-SAS/aic-robot/commit/159152ad02884a9f0ebfdd0e9c60d0dc5f3e18af)、[暂停抓取期视觉 a02a9fe](https://github.com/WHU-SAS/aic-robot/commit/a02a9fecb2963dd68fe4a8006b27c217c3f4b26c)。

## 重新定义准备位，让口令先得到明确回应

**问题。** 回准备位混入持续监控，唤醒后还要经过音频清理、相机初始化等工作才动作，现场感觉迟钝。另有直接发目标却默认扭矩已开的缺口，导致扭矩关闭时命令发了也不动。

**我的干预。** 我要求准备位目标一次同步发送，发出后结束，不再持续盯到位；随后补充未开扭矩要先开启。我亲自定义两套2、3、4号角度：准备位1为−85°／85°／85°，准备位2为−80°／80°／80°。“回准备位”用位1，“思达思达”立即发送位2作为回应；我明确选择目标发出后直接继续小车流程，不等待实际到位。

**AI随后的修改。** 两姿态分开配置；位2发包放到识别回调，先于唤醒日志、音频清理和后续任务。仅对未开扭矩的轴先写当前位置目标、开启并核验，再同步最终目标；最终目标不再读回监控。最终方案仍有必要的扭矩初始化，不能概括成“取消所有检查”。

**结果与限度。** 测试覆盖两口令路由、先发位2再清理音频、只开启未开轴及发送后退出。日志明确区分“已发送”和“已到位”，代码顺序也不能证明真实唤醒到机械动作已达到某个毫秒数。这是我对本项目响应语义与运行取舍的决定，不是所有机器人都应照搬的默认策略。

依据：[双准备位说明](../guides/arm/准备位脚本.md)、[准备位实现](../../device/k230/arm/ready_pose.py)、[准备位测试](../../host/tests/test_ready_pose.py)、[独立语音入口测试](../../host/tests/test_standalone_pick.py)。落实提交：[发送后退出 06b3a51](https://github.com/WHU-SAS/aic-robot/commit/06b3a5198fcdf89aa8b71b870945474b1cf22b9b)、[按需开扭矩 eaeb581](https://github.com/WHU-SAS/aic-robot/commit/eaeb5818263bf836c5e24a74fed913f196be2ece)、[双准备位与立即回应 af45272](https://github.com/WHU-SAS/aic-robot/commit/af45272875ec6ca788375c252ef842e11d77bbf2)。

## 这些案例能说明什么

我提供物理事实、设计有区分度的对照、审查验收条件之间的矛盾，并决定取舍；AI承担实现、计算和回归。早期采用临时补偿和参数试错也由我参与决策，随着证据增加，我继续调整方案。

软件回归、参数回读、单次实机成功和长期稳定性分别评价。视觉测点审查、困难集与过拟合约束另见[视觉协作案例](vision-cases.md)。
