WHU-SAS/aic-robot/docs/ai-collaboration/car-cases.md

# 小车与整车协作案例

这些案例记录了我如何从实机现象出发，修正 AI 的控制方案与问题归因。正文按问题链归并，同一问题复现多次仍算一组案例；各次修改的效果以对应版本和验证条件为限。

## 用行程补偿重新设计连续停车

**问题。** 最初的分段方式会走一段、停下来看一眼。后来接入近距离精测，计算等待又导致过早减速、停车偏远，影响整体观感。

**我的干预。** 我要求转向与直行融合，并直接提出：拍照时记录两轮编码器行程，定位结果返回时再记录一次，计算期间继续行驶；用精测剩余距离减去已经走过的距离。目的地放在停车窗口内部，停车后再拍一张新图验窗。我还要求 AI 解释每一档速度、减速起点和切断动力的条件，再逐步调整。

**AI 随后的修改。** 车轮控制改为连续差速更新；行进中按需精测，用两次编码器反馈补偿计算延迟，执行完后再用静态精图验证。后续目的地点按我的要求向机械臂方向偏移窗口纵深的四分之一。

**结果。** 这一思路进入停车基线，我在现场认可过其中的流畅版本。超过 95%首次停车入窗仍需独立统计，不能用几轮观感良好替代。

依据：[停车方案及历史基线](../guides/car-approach.md)、[实现提交 f954ace](https://github.com/WHU-SAS/aic-robot/commit/f954ace818df64a1c4697436834f3879396feb2e)。

## 不把整条控制链的误差直接归给视觉

**问题。** 早期视觉转向容易越过中线，AI 提议把视觉转向比例从 1 降到 0.75。这个系数能改善结果，却不能单凭它证明视觉偏角算错了。

**我的干预。** 我追问：是否也可能是底盘转向控制误差？在同意先补偿整条链路后，我要求明确记录：以后改变底盘控制，这个系数也要重新评估。

**AI 随后的修改。** 文档把 0.75 定义为“视觉偏角到车身运动”整条链路的经验响应系数，保留原始视觉偏角，不把补偿混进相机参数或轮距标定。左右轮程接近也不再被当成实际车身必然走直的证明。

**结果。** 项目保留了可用的阶段性补偿，也保留了它的适用边界。盲走仍有轻微左偏时，我决定记录不足、转入视觉闭环，避免在局部调参上无限停留。

依据：[转向比例联动约定及盲走不足](../guides/car-approach.md)。

## 追踪升级不能破坏已经稳定的停车终点

**问题。** 加入动态追踪后，小车出现旧稳定版没有的过头、乱转和再次前进。粗框波动、关联歧义与上层调度迟到，都可能影响已经建立的行驶依据。

**我的干预。** 我要求先恢复静态停车：精测算完，立即按算出的距离执行，再恢复粗测；粗测波动不能随便撤销精测终点，只有确认目标真正移动才能重新规划。对于重复出现的过头，我要求查清升级为何引入退化，不能只调整速度参数。

**AI 随后的修改。** 精测结果先做编码器补偿并下发行驶命令，普通粗框变化不再改写终点。同时把有限剩余路程交给天猛星独立执行，使 K230 忙于图像计算时，底盘也能自行按距离截止。

**结果。** 修复分别覆盖了“终点被错误撤销”和“停车控制迟到”两条路径，并加入相应回归。协议和控制器检查能够证明这些路径受到约束，实际刹停误差仍须实测。

依据：[全流程追踪的精测交接与有限路程规则](../guides/full-process-tracking.md)、[终点保留 8a9e7b4](https://github.com/WHU-SAS/aic-robot/commit/8a9e7b4d8a26ac080cba4d2c03e0fc3b9d8c2b6d)、[主控自主截止 dae3b7c](https://github.com/WHU-SAS/aic-robot/commit/dae3b7c7014307eca481bb6b762b119f8cb66fea)。

## 固定方块也反复纠偏时先审查程序自身

**问题。** 方块一直没动，小车仍反复调整。执行中的转向会改变图像，程序可能把这种变化当作目标移动，打断原纠偏，再次计算。

**我的干预。** 我明确提供“全程没碰、方块不动”的实验条件，并指出自身转动误判移块的可能性。随后我进一步简化规则：先把按精定位算出的纠偏完整执行，再拍新图验窗；没到位就用新坐标再纠正，目标明确变远才回粗接近。不必先强行判断到底是控制不准还是有人移块。

**AI 随后的修改。** 近场纠偏改成“新精测 → 完整执行 → 新精测验窗”的闭环，不再凭粗框位移中断已发出的纠偏。我另外取消了“识别不清就左右换角度”的策略，要求优先改视觉算法。

**结果。** 不必要的分类和相互打断被移除。取消纠偏次数上限并不意味着接受反复折腾；固定目标下的纠偏次数仍是要降低的质量指标。

依据：[纠偏与识别失败处理](../guides/robot-task.md)、[修复提交 c21d84f](https://github.com/WHU-SAS/aic-robot/commit/c21d84f1721c1a347cb275ac6265f56713370e0c)。

## 用方向和退出条件审查搜索状态

**问题。** 我先后发现方块向右移、小车却向左搜，搜索断断续续，以及画面已有目标却迟迟不退出搜索。单纯说“进入搜索状态”没有定义出有用的行为。

**我的干预。** 我给出明确规则：慢而连续地转；有当前可信目标线索时朝它寻找，没有时才参考最后消失的方向；重新锁定后就退出搜索、恢复追踪。我还要求 AI 解释完整状态转换，逐条检查反例。

**AI 随后的修改。** 搜索采用连续低速转动，区分当前方位、历史记忆和无方向线索的情况；重获目标后按证据恢复导航或局部观察，弱蓝色噪声不能直接恢复旧行程。

**结果。** 搜索方向、连续性和退出条件都有了明确规则。某次转约 180°后停止的现场记录不足以完整定因，因此不能把它归入已经彻底解释的故障。

依据：[搜索与目标重获规则](../guides/full-process-tracking.md)、[连续搜索修复 c835c78](https://github.com/WHU-SAS/aic-robot/commit/c835c7815ab129f2f0ed0db8e09895881edad071)。

## 对着白墙前进要同时检查旧行程权限

**问题。** 目标移走后，小车仍向墙前进。这个表现既可能来自误识别，也可能来自程序继续执行旧的剩余路程，不能只按“把墙识别成方块”来解释。

**我的干预。** 我说明异常发生在已经追过方块、后来移走目标的过程中，并选择了明确的丢失规则：短暂一两帧丢失可以继续；连续三帧完全不可见就撤销旧行程，停车后搜索。

**AI 随后的修改。** 丢失计数与导航权限联动，第三帧完全不可见时先停车再搜索；提高蓝色候选的有效证据要求，陌生弱蓝片不能清零原目标的丢失计数或继承旧距离。

**结果。** 修复同时处理了视觉噪声与旧运动依据，而非只改一个颜色阈值。已安装规则的离线检查不等于所有背景下都不会误识别。

依据：[目标丢失处理与启用记录](../guides/full-process-tracking.md)、[修复提交 61ccf66](https://github.com/WHU-SAS/aic-robot/commit/61ccf66)。

## 超时不能把整项任务留在永久等待中

**问题。** 小车停下后机械臂不启动，拉远方块也不追。短弧线动作可能起步不足，而上层把段超时留成了无法继续推进的等待。

**我的干预。** 我要求解释原有 5 秒段超时为什么会造成永久等待，要求区分“这段动作没完成”和“整个任务从此不再处理新目标”。

**AI 随后的修改。** 修正短动作从起步输出切换到闭环控制时的负积分问题；段超时后停止、清除旧运动依据，再用新图重新定位和规划，保留原来的底层限时。

**结果。** 两方向基础短动作现场确认能转并停稳，永久等待路径得到修复。仍有名义欠行程，不能据此宣称精确纠偏已验收。

依据：[短动作与超时恢复](../guides/car-approach.md)、[修复提交 ffc407a](https://github.com/WHU-SAS/aic-robot/commit/ffc407a)。
