WHU-SAS/aic-robot/hardware/car/Hiwonder八路巡线模块_接口与型号.jpg

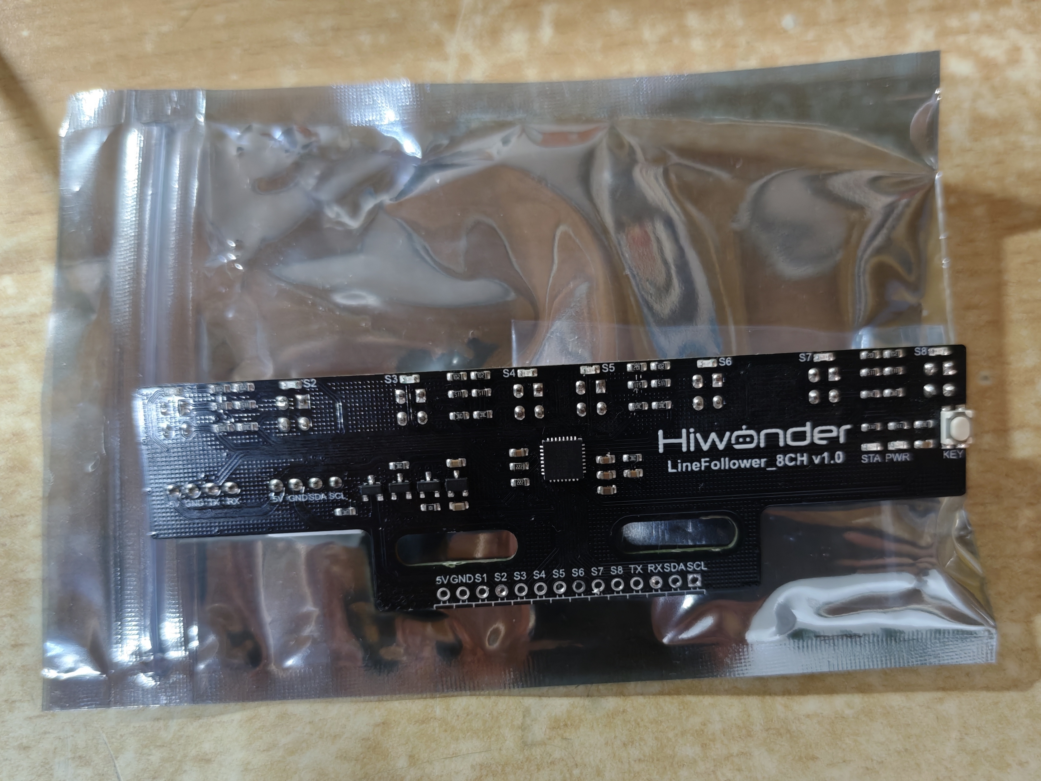
hardware/car/Hiwonder八路巡线模块_接口与型号.jpg
