WHU-SAS/aic-robot/hardware/car/ICM-42688惯性传感器_元件面.jpg

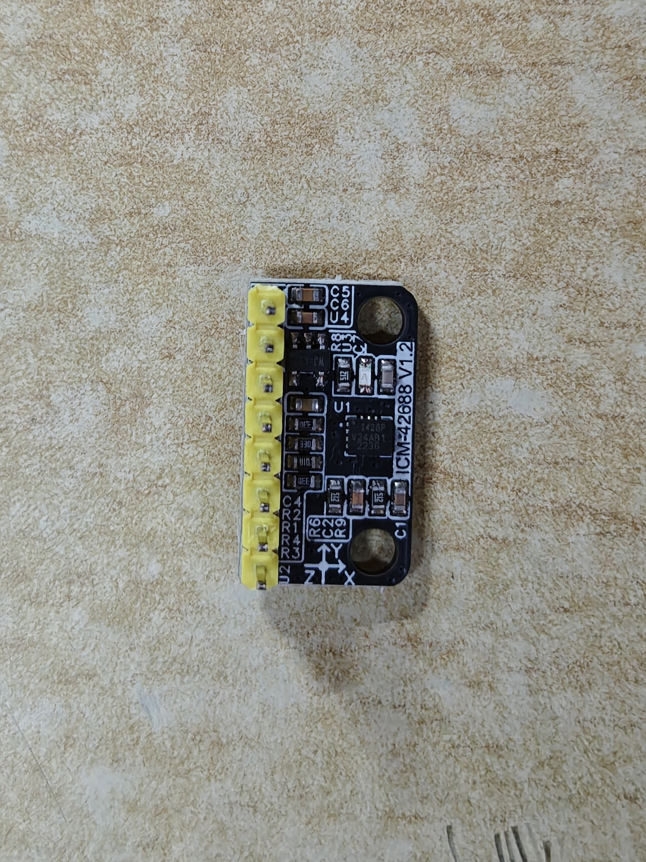
hardware/car/ICM-42688惯性传感器_元件面.jpg
