WHU-SAS/aic-robot/hardware/car/ICM-42688惯性传感器_背面引脚标识.jpg

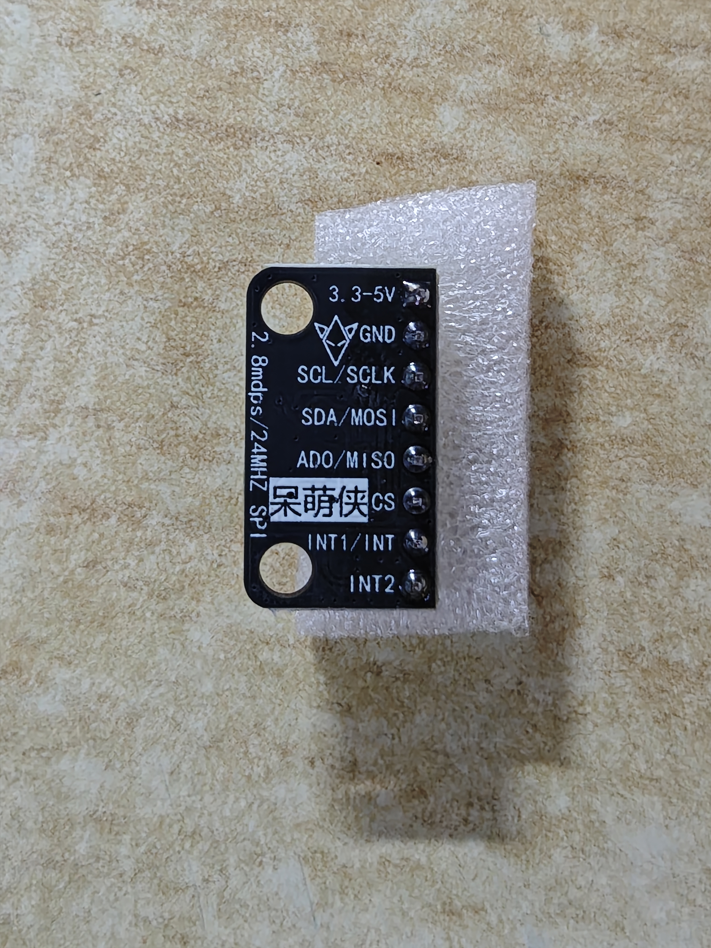
hardware/car/ICM-42688惯性传感器_背面引脚标识.jpg
