WHU-SAS/aic-robot/hardware/car/R3X三轮差速底盘_俯视图.jpg

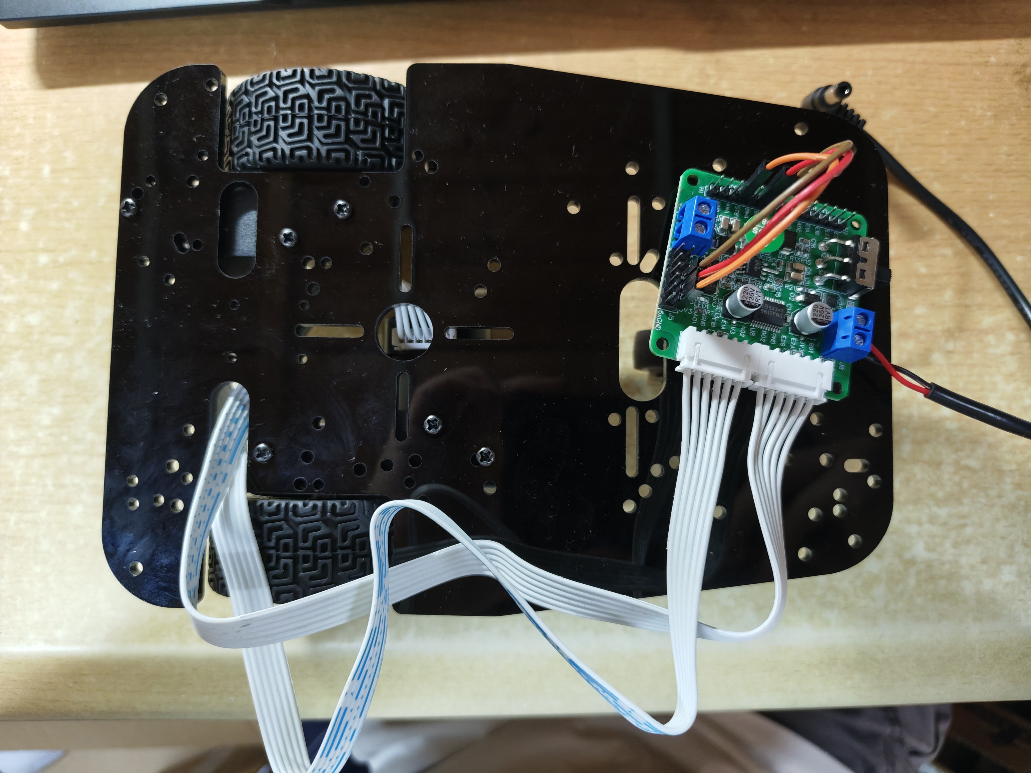
hardware/car/R3X三轮差速底盘_俯视图.jpg
