WHU-SAS/aic-robot/hardware/car/TB6612FNG电机驱动稳压板_接口近照.jpg

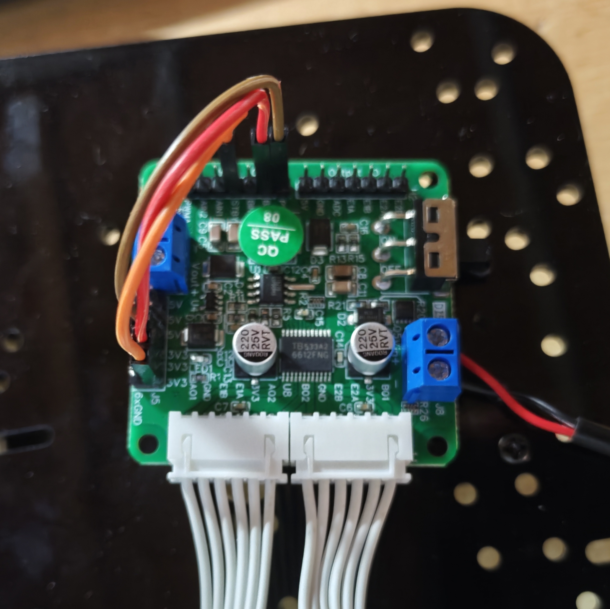
hardware/car/TB6612FNG电机驱动稳压板_接口近照.jpg
