WHU-SAS/aic-robot/hardware/car/TB6612电机驱动稳压板_使用手册.jpg

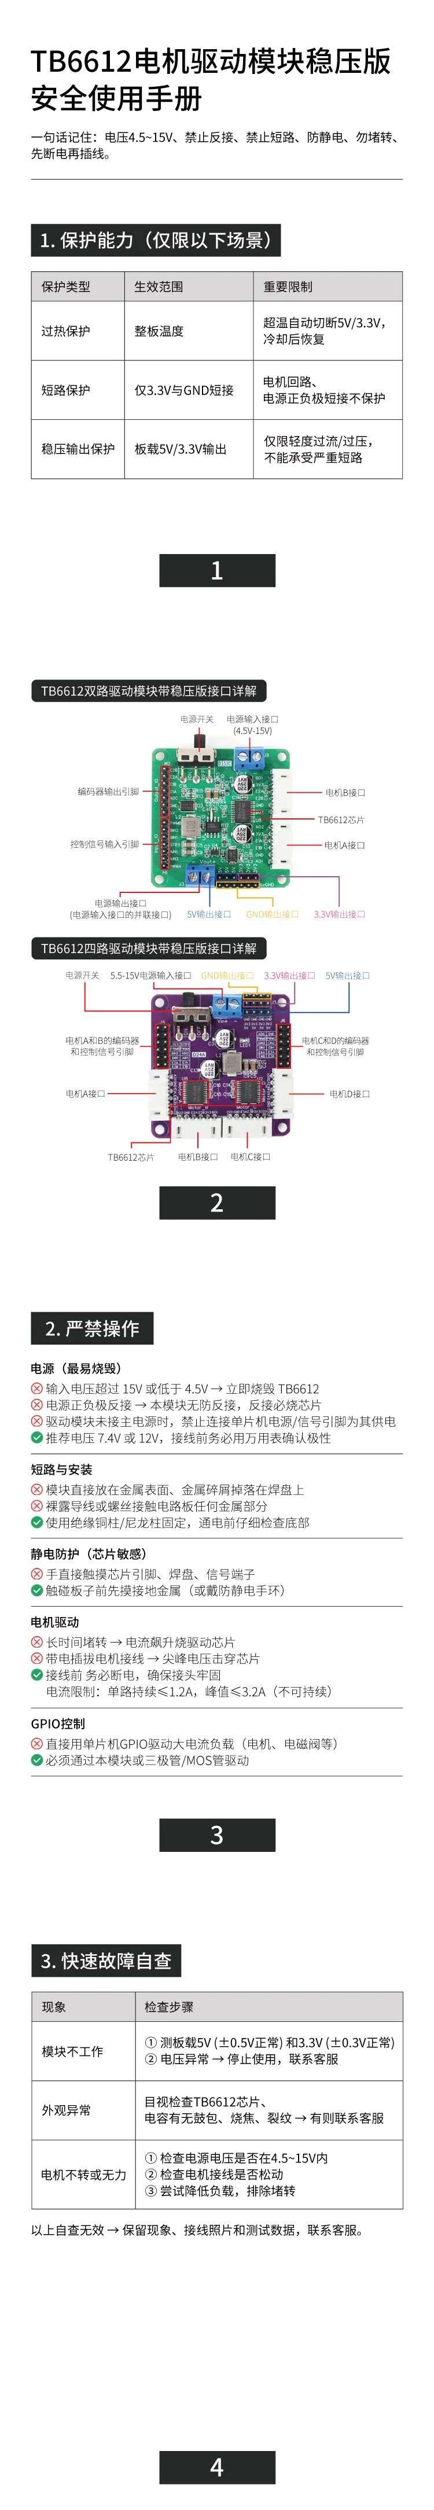
hardware/car/TB6612电机驱动稳压板_使用手册.jpg
