WHU-SAS/aic-robot/hardware/car/WHEELTEC_E326S锂电池_参数标签.jpg

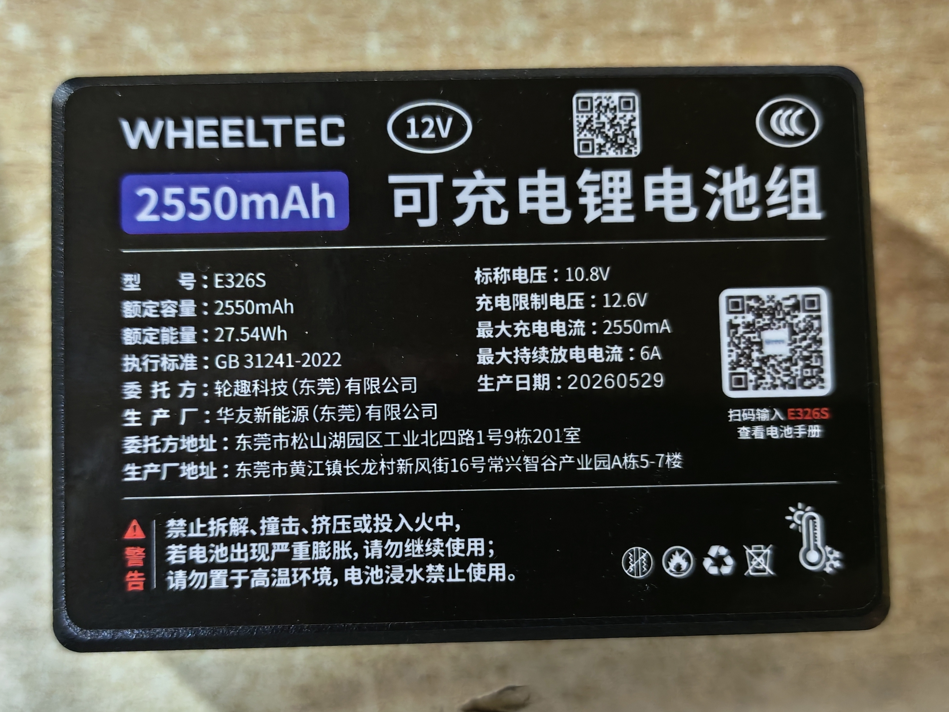
hardware/car/WHEELTEC_E326S锂电池_参数标签.jpg
