WHU-SAS/aic-robot/hardware/car/WHEELTEC_MG513XP28_12V电机_型号标签.jpg

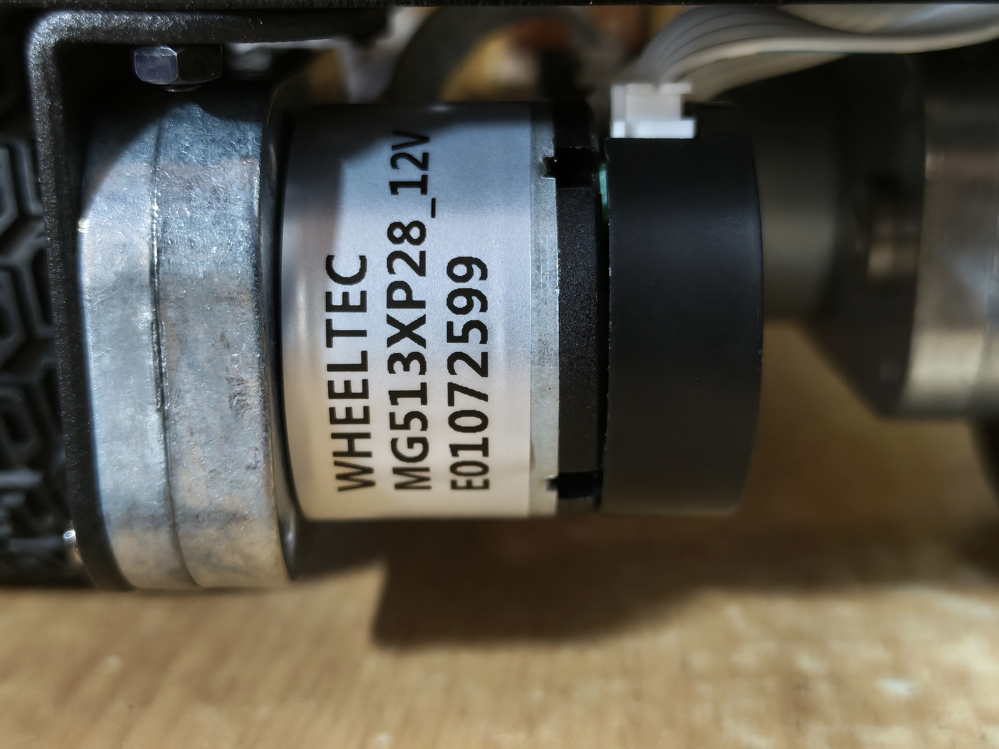
hardware/car/WHEELTEC_MG513XP28_12V电机_型号标签.jpg
