WHU-SAS/aic-robot/hardware/car/电赛硬件采购计划_第1页.png

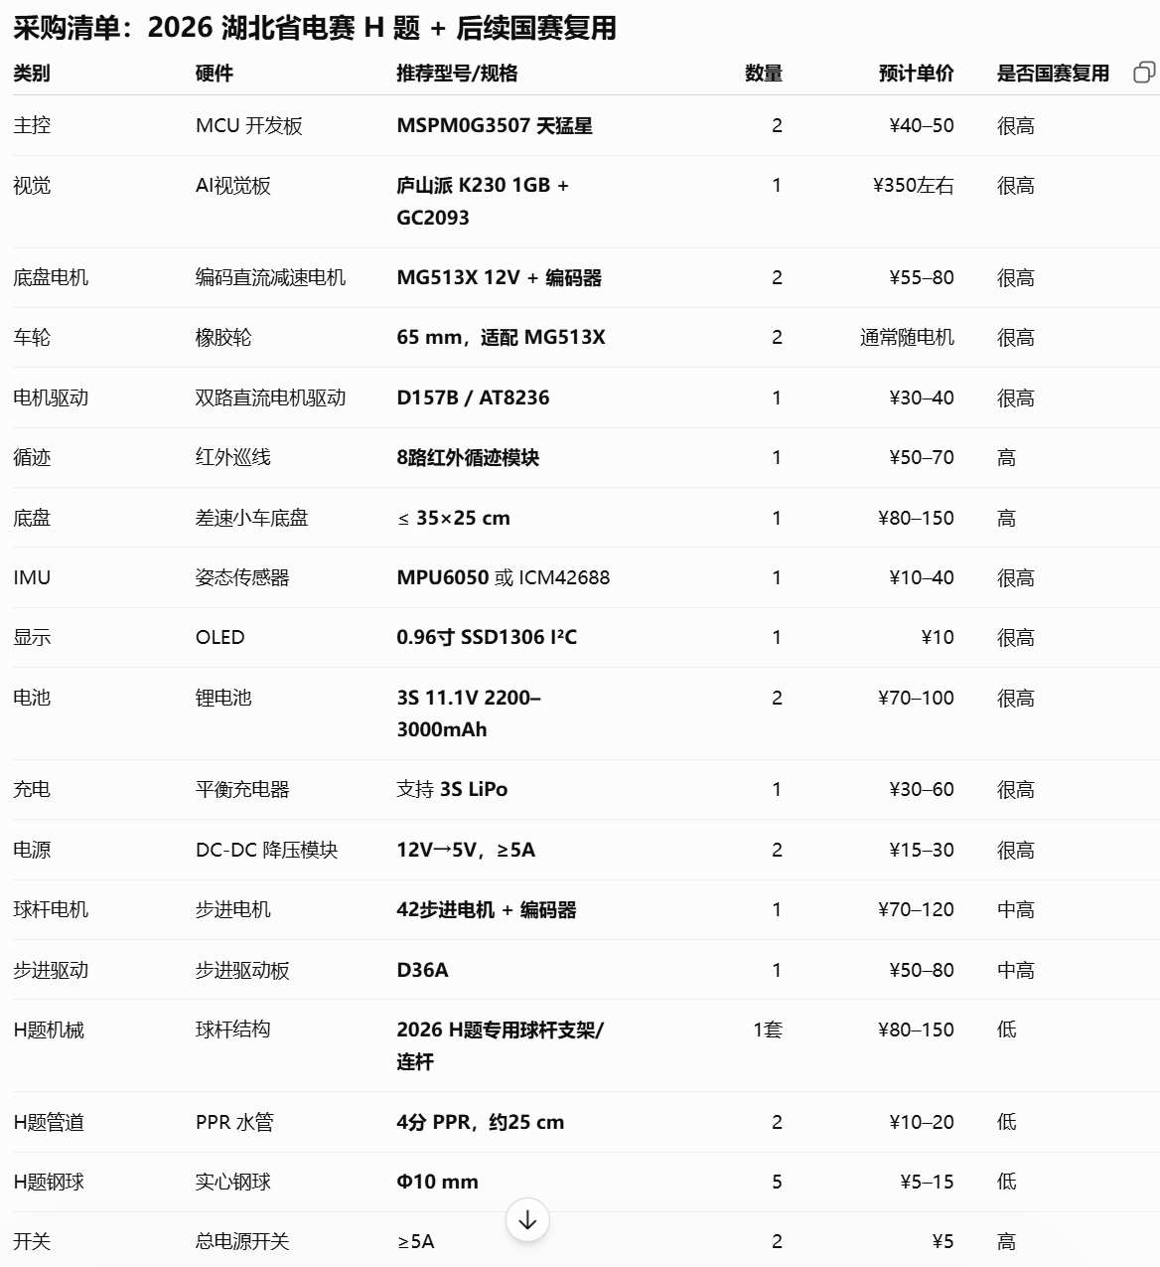
hardware/car/电赛硬件采购计划_第1页.png
