WHU-SAS/aic-robot/hardware/car/电赛硬件采购计划_第2页.png

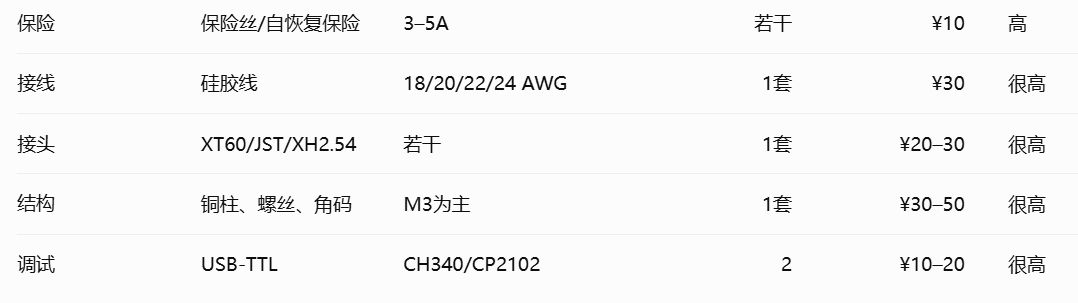
hardware/car/电赛硬件采购计划_第2页.png
