WHU-SAS/aic-robot/hardware/car/立创天猛星_MSPM0G3507开发板.jpg

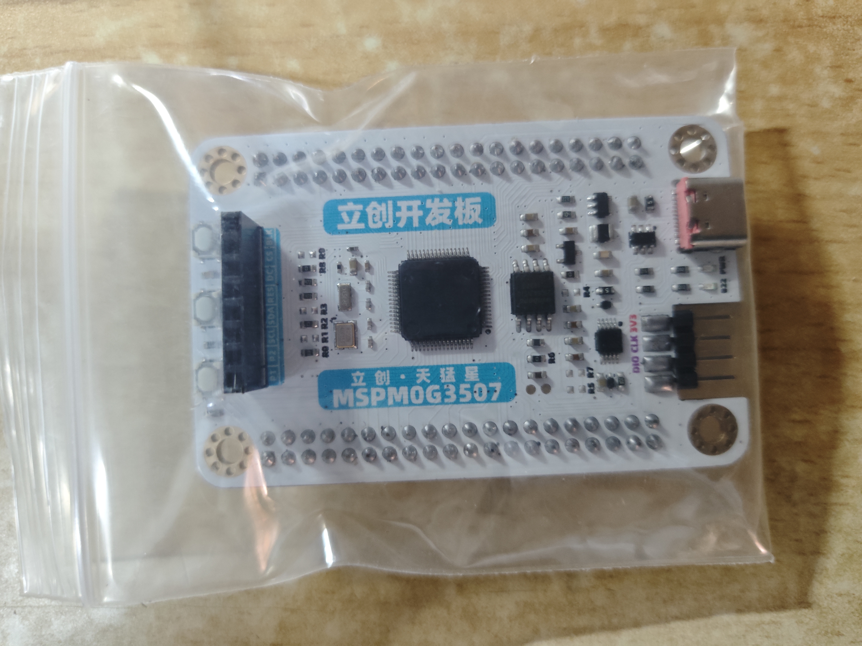
hardware/car/立创天猛星_MSPM0G3507开发板.jpg
