WHU-SAS/aic-robot/hardware/car/连接线与接线端子_配件.jpg

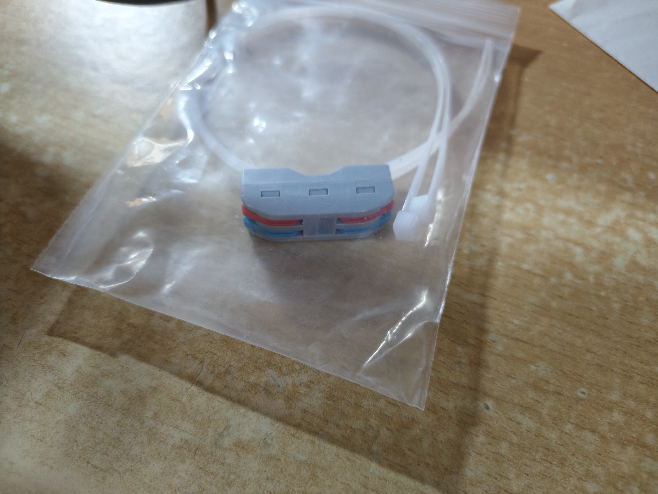
hardware/car/连接线与接线端子_配件.jpg
