WHU-SAS/aic-robot/models/genkiarm/meshes/AAA.stl

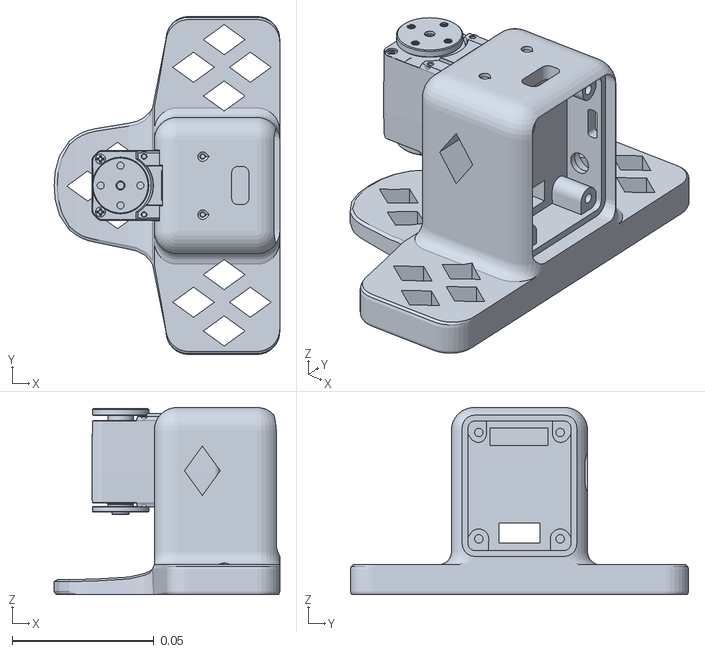
[picture p21: CAD file, 2026-10-13]
models/genkiarm/meshes/AAA.stl
0.0796 x 0.119 x 0.066
