WHU-SAS/aic-robot/models/genkiarm/meshes/CCC.stl

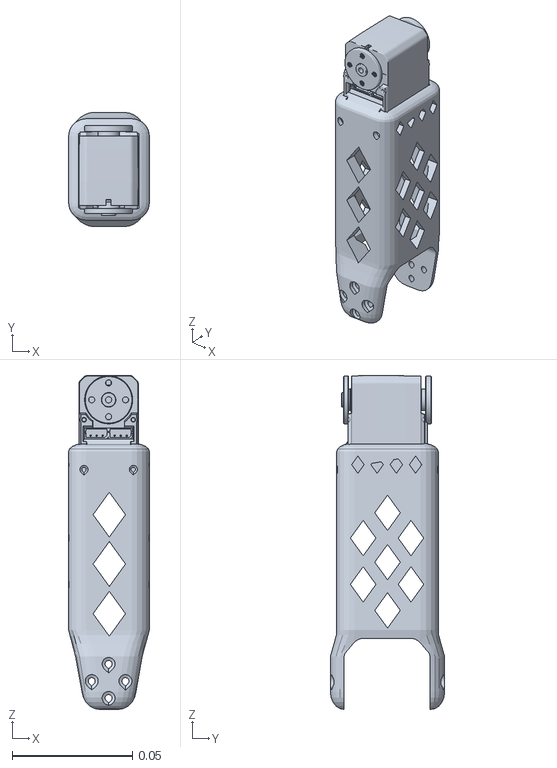
[picture p22: CAD file, 2026-10-13]
models/genkiarm/meshes/CCC.stl
0.0337 x 0.0475 x 0.139
