WHU-SAS/aic-robot/models/genkiarm/meshes/EEE.stl

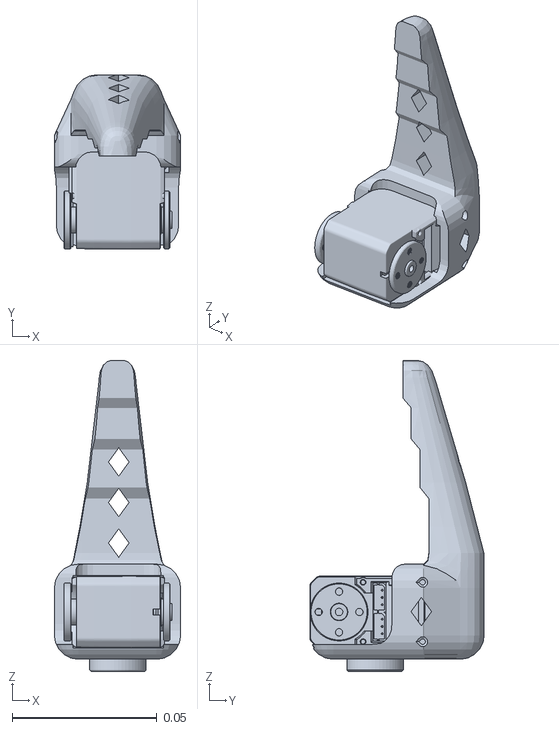
[picture p23: CAD file, 2026-10-13]
models/genkiarm/meshes/EEE.stl
0.0437 x 0.0602 x 0.107
