WHU-SAS/aic-robot/models/genkiarm/meshes/DDD.stl

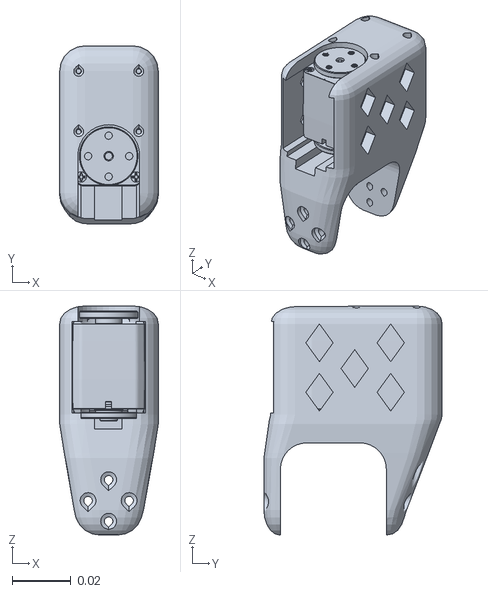
[picture p24: CAD file, 2026-10-13]
models/genkiarm/meshes/DDD.stl
0.0337 x 0.0608 x 0.0781
