WHU-SAS/aic-robot/models/genkiarm/meshes/FFF.stl

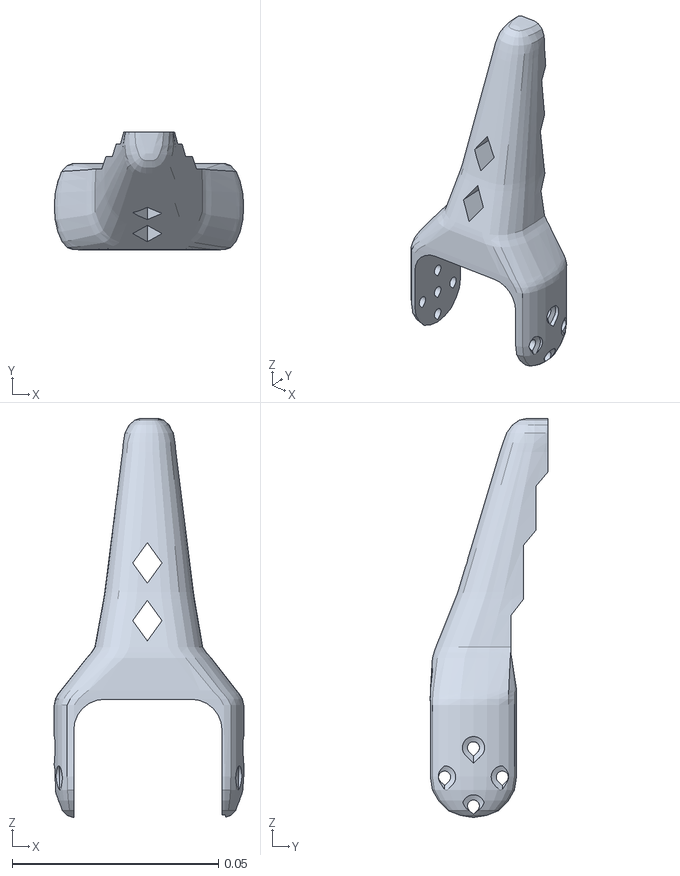
[picture p25: CAD file, 2026-10-13]
models/genkiarm/meshes/FFF.stl
0.046 x 0.0285 x 0.0968
