WHU-SAS/aic-robot/models/genkiarm/meshes/BBB.stl

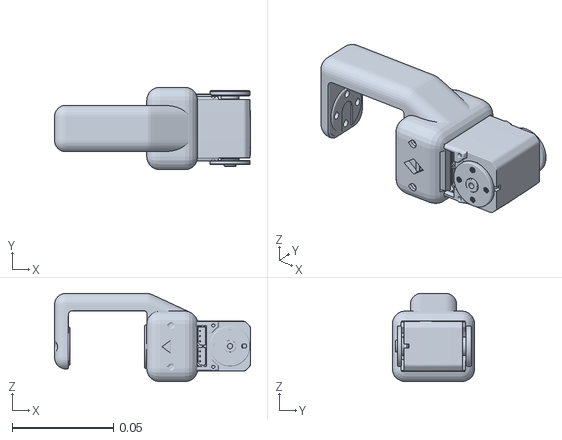
[picture p26: CAD file, 2026-10-13]
models/genkiarm/meshes/BBB.stl
0.097 x 0.0408 x 0.0437
