WHU-SAS/aic-robot/docs/guides/car-approach.md

# 小车识别、接近与停车

当前有符号双轮弧线`ARC,L,R`同时修正纵向和横向，目标仍为下文规定的近端1/4深度及摄像头中线，不以擦边入窗为目标。2026-11-03修正短轮起步的负积分交接，以及K230把ARC段超时锁成永久等待的问题；超时后按原停稳条件获取新静态图再规划，原图不能继续交臂。天猛星新页填充CRC为`91cedcbf`，两方向5mm短动作约820/510ms正常距离结束，用户确认能转并停稳；名义终程仍有约1～2mm欠行程，不能当作精确纠偏验收。K230当前启用版本及验证边界见[全流程追踪](full-process-tracking.md)，取消纠偏次数上限，闭合接触解释及相机跨轮复用保留。整轮流畅性、实际停车入窗仍待复验。当前安装版本以本机`data/robot/active_release.json`为准；下文`16060786e9fe3e29`是原小车归档基线。

2026-10-31新增[小车＋机械臂完整任务](robot-task.md)，通过组合包选择。以下独立小车基线与`--near-parking`入口继续保留：仅停车，不自动抓取；组合入口才在最终静态精定位验窗通过后，将同帧结果交给机械臂。

2026-10-30：固定目标连续接近已完成基础实测；近距离停车采用“一次行进中细测＋编码器补偿＋窗口中心停车＋静态验收，最多微调一次”。当前K230入口为`16060786e9fe3e29`，底盘保持已核验的负向MOVE固件。已修复分界线逃出原搜索带，以及窗口边界的单调响应抢占真实分界投票两处视觉错误；原图回放和板端核验通过；用户随后反馈最新版“非常好，暂定下了”，已将`16060786e9fe3e29`归档为小车暂定基线；2026-10-31用户批准新的2.0～2.5秒停车时间候选参数，见下文当前阶段。超过95%首次入窗仍是未验收目标；不自动交接机械臂。

目标是同一平台上从约0.5～1米发现20mm蓝色方块，连续接近，停在用户选定区域后交给机械臂。先做可演示的完整流程，暂不引入里程建图或复杂路径规划；底盘独立定距/定角控制采用编码器轮速PI。

用户现场测试规则（2026-10-29）：短距离测试默认直接落地，不再要求架空；前进每次不超过100mm，其他短动作也保守限制。长距离测试先通知用户，等待其整理桌面。用户可能手动挪动车，需区分驱动期间与停车/挪动期间的计数；计数异常仍先停车核对，不自动认定电机故障或忽略保护。行驶时机械臂保持准备位2（2/3/4号−80°/+80°/+80°）及扭矩。完整语音入口在“思达思达”识别后先立即发送位2，再直接继续小车流程，不等到位；“回准备位”发送位1，定义见[双准备位](arm/准备位脚本.md)。场地状态改变后再确认。

用户确认车体较重，并有两根线牵拉，短动作的实际位移和转角不要求高度重复，左右响应也不能假设对称。PWM与时长只作动作强度和上限候选，不对应固定毫米数或角度；以移动后重新采集的视觉位置修正，靠近允许区时使用更小的调整量。编码器用于辅助观察运动及停车，不能代替目标的视觉位置。先以进入允许区域并停稳为验收目标；后期再优化连续接近的流畅性。车重及牵线可能影响起转，但尚不能据此确定双轮反向转向失败的原因。

视觉接近前新增独立直行任务：用户指定初验前进150mm，允许距离误差±5%（±7.5mm，停稳后142.5～157.5mm），一次连续起步、行驶、减速、停车，停稳后不补走或倒退；行驶中允许编码器反馈修正左右输出。运行时拔掉全部电脑连接线，须先确认两块主控独立供电。独立小车直行测试模式使用“思达思达”触发一次指定距离行驶，该模式不得同时触发机械臂抓取；既有机械臂模式不全局改绑。用户随后指定先采用现有标称参数，不安排人工距离标定；若实际运行多次出现疑似距离比例引起的严重偏差，再结合运行情况标定。沿用`drive_nominal.json`中的65mm轮径、28减速比、暂按GMR500ppr及2倍频换算（28000计数/轮圈）；编码器版本仍是现有推定，不因采用该方案改写为实测确认。首项工作改为实现编码器反馈的150mm直行控制，包含左右轮同步修正、提前减速、一次停车和日志记录。此任务已安装为独立语音测试模式，5%是验收要求而非已实现精度；横向偏移及朝向容差未单独量化。

## 已知不足与当前取舍

盲走直线仍有轻微左偏。加强编码器同步后轮程差已明显缩小，但不能据此认定实际轨迹完全笔直，根因尚未确定。2026-10-30用户明确要求记录、后续有时间再改善，本阶段不再追加盲走测试、俯拍要求或同步参数调整。旧定距模式保留同步系数10，后续连续接近依靠行驶中的新视觉观测修正偏差；此决定不代表盲走直线精度已经验收。原始日志和分析保存在本机`data/car/straight/sync_fix_20261030/`。

## 当前阶段：近距离细定位与停车窗口

当前暂定基线使用`aic.car.near_parking.v2`，`--near-parking`模式仍由一声“思达思达”启动一次任务。远处及等待行进中细测期间保持连续粗视觉引导，巡航70mm/s、单轮上限80mm/s、航向增益1.5/s；细测交接后近区上限70mm/s，末段50mm/s。粗代理Base X进入触发距离`d`时，只拍这一张行进中的细测图；拍照时刻为`t1`，紧接着查询STATUS记录两轮编码器`l1`。计算期间继续粗跟踪、发送轮速，不因启动细测而降速，也不在正常接管时停车。细测成功时刻`t2`立即查询STATUS记录`l2`，用两轮统一前进正方向后的平均行程差补偿拍照后已走的距离。原拍摄时间保持不变，两块板的绝对时钟不直接相减。

`d`按2026-10-31用户批准的提速方案设为粗代理Base X的470mm。目标是把行进细测拍照至车身完全停止压到2.0～2.5秒；名义计算采用拍照时剩余约145～150mm、计算期间70mm/s及细测到首条距离控制命令约1.0～1.6秒。470mm是近期同图粗细结果估出的触发候选，不能直接减目的地X当作剩余轮程，也不保证不同朝向/可见蓝面下都对应145～150mm；实际耗时与一次停车入窗仍待试跑验收。

若启动时已经进入该细测区，先保持静止拍照并做完整精定位，不先发巡航轮速。方块已在窗内时直接使用这张验收图交接；仍需前进时按精定位剩距计算第一条轮速，行驶后再拍新图验窗；过近或侧偏则复用原一次微调机会。初始静态定位失败不启动。原图记录为`initial_verify`，不刷新旧粗测时间。

取得唯一的行进中细测结果后，沿用原标称编码器和轮距推算剩余行程；可用的新粗测只更新转向，不重新测定精确距离。行驶阶段优先使用完整定位；若完整桌面一致性未通过，但同一张图已经测得真实侧面四边并通过原2px、方向和侧面配对检查，可显式使用`range_candidate`提供行驶距离。它仍假定目标为同一个20mm方块，不证明方块贴桌，也不代表停车或抓取定位成功。`X_interval_mm`仅是可用姿态解的距离包络，不包含标定、尺寸和边界误差。没有完整定位或可用测距候选则结束，不换图重试。粗测方向暂不可用或过期时，改用这张细测锚点与编码器偏航推算方向。该近似仍没有标定Base到轮轴的杠杆臂，也不能消除打滑、轮程比例或视觉误差，不支持本阶段人为移动方块后的动态重获。

停车目的地从10mm内缩允许窗口的中心向机械臂偏移纵向边长的1/4，即`X=near+(far-near)/4`。用户2026-11-03将前后接收区改为`[0,0.6]`、左右改为`[-0.6,0.6]`，保留10mm内缩；新构建配套`model_alignment_20261030`的X窗为242.71159～273.16272mm，目标X250.32437mm，横向相机中线两侧各约22.47mm。已安装`c26879c5391f9f87`仍使用原0.5窗与248.22224mm目标，新规则尚未安装。细测交接后的前进目标速度为`min(70, max(50, 2.0×剩余毫米数))`，再结合方向生成左右轮差速，单轮上限80mm/s。剩余35mm以下开始减速，剩余25mm时连续降至50mm/s，之后保持50mm/s；取得细测结果本身不要求降低巡航速度。按实际轮速和原0.12秒滑行估计提前发送STOP。近距离停车及唯一微调后的编码器稳定确认窗口改为50ms，编码变化仍重置计时；50ms轮询及串口往返使实际确认稍晚于50ms。随后拍一张新图细测，直接按完整允许窗口验收，不依赖旧粗框。独立直行及纯粗接近的原200ms确认不变。

用户要求超过95%的情况首次停车入窗，这仍是未验收的现场目标，统计以微调前的第一次静态验收为准。在独立／旧单次对照流程中，第一次验收在窗外时只允许一次`ARC,左轮毫米数,右轮毫米数`微调，不能串成多次调整；随后拍一张新图再次验收，仍不在窗内则结束并判失败。静态细测失败同样不能当作到位。独立小车入口成功后结束；完整任务入口才将最终静态图交给机械臂。当前全流程追踪版采用ARC并取消纠偏次数上限，以上单次限制仅用于旧对照。

新候选直接向约定目的点规划，而非纵向MOVE与侧向TURN二选一。将当前精定位和目的点投影到桌面前进/横向轴，逆算一次恒定曲率动作的有符号左右轮程；在相邻整数毫米组合中，优先选择预测点最接近目的点的一组。完整窗口余量只作同等误差时的选择及记录，不替代目的点。规划沿用单次最多30°、每轮不超过100mm，双轮可以同向、反向或其中一轮为0；相对轮程由天猛星10ms闭环执行。轮轴杠杆臂仍未实物标定，预测精度不能当作实物精度，最终必须由新静态图验窗。

毫米级微调不再套用长MOVE的25mm/s末速和平均轮程截止。短MOVE及最大轮程≤30mm的ARC采用主轮最高15mm/s；更长ARC按主轮剩距采用`min(80,max(15,2×剩余毫米数))`，避免整段低速超过原5秒时限。各轮按目标轮程比例给速，再按归一化进度修正同步；起步沿用原PWM缓升，检测到各轮起转后平顺转入原轮速PI。每轮分别按该轮剩距和速度×0.08s（最少0.1mm）估计滑行并截止，已截止的轮不重新供电；不增加停后补走。上述是起始控制参数与合成模型验证，尚非实物滑行拟合。长MOVE、TURN及连续FOLLOW的控制参数不因此改动。

小车和机械臂正式近距离入口现共用`device/k230/vision/physical_side.py`，保留1280×960 RGB565→JPEG95→BGR、真实侧面四边、每边64站采样、2px重投影、桌面双解筛选及既有大侧面/双侧面选择规则。边缘测量会区分可分辨的蓝/蓝内部棱线与更强的外轮廓，避免把很窄的相邻侧面并进正面；弱顶面/侧面色差复用已测边缘证据，不增加拍照或重复PnP。默认输出及停车后的完整定位仍保留原桌面高度检查；只有行驶中的`car_moving_range`用途请求附加测距能力，失败状态不会被改成`localized`。机械臂的原顶面恢复及无桌面约束的第0版路径保留，PID、动作时序、标定和抓取补偿不变。只有停车后的新静态完整定位才可供后续交接复用，行驶测距候选不能直接交给机械臂。

当前200ms为细测调度软预算，不是10Hz更新保证。K230原生三次完整取图至结果计时为1054、1030、1474ms，其中一次从全图自行提取候选；均是静止、零轮速检查，不代表实车完整耗时；后续实车一轮的细测前后编码器快照间隔约1.54秒，不能保证所有场景≤1.5秒。组合负载中模拟SPEED请求的最长间隔为565ms，低于原1秒失联时限；天猛星仍每10ms独立运行轮速PI。原20秒FOLLOW总时限、1秒失联停车、B21及接管前500ms粗测新鲜度不变。原图与计时位于本机`data/car/near_parking/shared_fast_native_20261030_210559/`；这些结果不证明所有场景细测都小于1.5秒，更不代表95%一次停车入窗已实现。

每轮最多三张细测原JPEG95暂留RAM：远起点为行进中定位、首次静态验收和有微调时的第二次静态验收；近起点用初始静态图替代行进图。彻底停车并关闭相机与UART后，`EvidenceRun`才将原图、frame元数据、原始定位结果及确切配置/版本写到`/sdcard/aic/vision/evidence/`；运动期间不写SD卡。历史程序没有自动保存每张细测原图，不能声称旧运行照片齐全。既有本地素材保留，新的静态验收也保留原采集时间及坐标定义。

主控保留已核验的负向MOVE固件，映像CRC为`a09cb35a`。归档暂定基线入口`16060786e9fe3e29`曾逐文件哈希核验并恢复语音，其远段70mm/s、近区上限60mm/s、末段40mm/s；此处以下为原基线验证记录，当前候选参数见上文。蓝色背景下，先前一轮因把顶面并入正面而低估距离，后一轮因分界投票被扫描边界的单调响应占用而完全没有测距候选；后者以`precise_unavailable`结束，并未进入编码器距离控制或静态停车验收。共享模块现只接受现有分界网格中三点均有效的完整局部峰，拟合分界仍须属于原搜索带；沿用原阈值、24列、每列2票、64站、3候选和所有完整定位检查，不增加拍照。

本轮失败原图在K230上已恢复真实正面，range X约409.37mm，几何计算约482～484ms；旧版在该图约271～301ms便失败，增加时间来自现在确实执行了物理面求解，不能称为零时间成本。这些是保存像素的原生几何计时，不含JPEG编码、解码和粗测/UART交织，不证明完整细测必定≤1.5秒。此前错误距离图在最新版约428.46mm，当前原位照片约324.45mm；与本轮编码器行程传播后的X差约4mm，仅是相对一致性，均非外部测距真值。52例回放的原33个完整定位和6个range全部保留，新增1个完整定位，旧成功最大中心变化1.639mm；56帧native/portable无状态或range有无差异。项目405项检查通过（30项跳过），额外视觉31项中28项通过、3项跳过，控制/运行/包61项通过。默认36困难图仍有原先已知的1个侧面期望不符案例，无新增期望失败。原图、原时刻、配置及报告留在本机`data/car/one_shot_parking/failed70_retry/`，前轮资料保留在`failed70/`，当前安装记录为`data/car/one_shot_parking/active_release.json`，用户认可的暂定基线及完整文件哈希见`data/car/one_shot_parking/current_baseline.json`。

用户已反馈局部峰修复版一轮现场效果良好；该轮细测交接只余约48.53mm，原近区全程目标30mm/s，从首个距离控制应答到STOP约0.94秒。当时为改善后半程，仅将near的finish30→40、slowdown0.5→1.0，粗测70、近区上限60及视觉源码保持。配置与全部文件已回读哈希核验、板端速度曲线检查及61项相关测试通过，部署未运行小车。末速提高使单个控制周期位移和停车误差余量有所变化，用户已反馈提速版“非常好”并暂定为基线；不套用理想模型的节时作为实测承诺，一次入窗比例仍未形成统计。该轮程序的静态完整定位仍失败，不能因用户观感良好就统计为正式验窗成功。原图、配置和对照记录在本机`data/car/one_shot_parking/near_speedup/`。

已有静态视觉坐标在窗内但静止/时效条件未通过的轮次，仍不得记为正式停车成功，原判据未改。另发现搜边窗口端点可能被当作响应峰的缺口，本次未一并调整；64站支持、低边线RMS及小姿态解区间都不能单独证明毫米精度。该问题与原图逐站证据保留在本轮`conclusion.json`，后续若出现相关选边偏差再独立处理。

```bash
./scripts/host tools/deploy/k230_car_align.py --near-parking # 仅生成近处停车包
./scripts/host data/car/near_parking/export_latest.py       # 试跑后导出新模式日志
```

安装完成后的首次整车审查先从约0.5m、偏角较小的固定方块开始。该任务可能连续行驶数十厘米，须先按长距离测试约定通知用户、等待其整理桌面；贴桌摆块，机械臂保持准备位，使用电池并拔掉全部电脑及适配器外接线。旧每步100mm单步试验的范围不作本模式总行程上限。

## 已完成的前一阶段：连续粗接近

一声“思达思达”开启相机，确认蓝块后只发一次`FOLLOW,L,R`启动，之后边走边拍，以约100ms周期发`SPEED,L,R`更新左右轮速，不再交替执行TURN和MOVE。天猛星独立每10ms运行轮速PI，更新目标不重置PI、PWM或总运行时间；没有新图像时继续执行上一目标，K230计算不会暂停天猛星控制。

巡航目标60mm/s、近处收尾20mm/s、单轮上限80mm/s。画面中线偏角经航向增益1.5/s生成左右速度差，偏角较大时降低前进速度，两轮均只向前。该航向增益与旧单次TURN比例0.75是不同参数；以后修改底盘轮速响应，需复验连续模式的跟随效果。同步系数10只用于旧盲走MOVE，不强行令曲线行驶的两轮累计行程相等。

延迟预测用两次天猛星应答的编码器/时间差估计轮速，再用K230自身的图像年龄估计取图到规划期间的平移和转动。两板绝对时钟不相减。软件取图时间不是曝光时间，摄像头到轮轴的杠杆臂、打滑尚未标定；预测仅作短时近似，靠后续新帧不断纠正。原正式视觉标定和摄像头画面中线不变。

40帧静止计时中，取图、粗检测、规划和一次UART查询平均60.4ms、最大66ms；两次查询平均83.45ms、最大85ms，因此先采用10Hz目标周期。超过100ms的计算周期不再额外等待，实际频率以实车日志为准。运动期间不录像、不写SD卡，只在RAM存小型状态；停车、关闭相机和UART后写一条完整会话至`/sdcard/aic/car_follow/runs.jsonl`，旧分段日志和素材保留。

继续使用原粗接近结束距离：`proxy_Base_X−315.6896 < 10mm`时结束。此时画面偏差≤48px记为`near`，否则记为`near_unaligned`；不为了居中继续前进，二者均不代表最终允许窗口验收或自动夹取。目标丢失结束本轮；停车后沿用200ms编码器稳定观察。用户已明确批准仅新连续模式总时限20秒，旧模式5秒、1秒失联停车和B21不变。仍未加入细定位或机械臂动作。

本版268项PC检查、17项底盘测试通过，两板已安装并完成独立CRC、文件哈希及零轮速原生检查。固定方块连续粗接近已完成基本实测，用户反馈效果很好；最新日志显示每轮仅一次FOLLOW后连续SPEED更新，实际更新间隔平均约101ms，正常到近处结束并保持零输出，无丢目标、失联或总时限中断。基础流畅性阶段可收尾，参数保留；末端居中尚有单次偏差，不能据此认定最终精准停车通过。下一阶段接近距离细定位与停车窗口判断，动态重获仍按用户要求留后续。部署、原始日志及分析保存在本机`data/car/continuous_approach/`，最新汇总为`fixed_target_trials_20261030.json`。运行时继续清出通道、机械臂保持准备位，使用电池并拔掉全部电脑及适配器外接线，方块保持贴桌。

```bash
./scripts/host tools/deploy/k230_car_align.py --continuous-approach # 仅生成连续包
./scripts/host tools/deploy/k230_car_align.py --auto-approach       # 原分段版回退包
./scripts/host data/car/continuous_approach/export_latest.py       # 实车后导出连续日志
```

## 已完成的前一阶段：一次唤醒自动分段接近

新版本已完成248项检查、文件哈希回读和原生只读检查，并完成三轮自动接近：均正常结束于`near`，全部动作停后零输出，用户反馈良好。三轮均只使用粗视觉，尚无细定位、最终停车窗口验收或机械臂动作；保留当前参数进入下一阶段。原始日志及汇总保存在本机`data/car/automatic_approach/first_trials_20261030.json`。运行前仍须留出较长通道。说一次“思达思达”后，重复“新观察→偏中线则TURN、居中则MOVE→停稳后重新观察”，每段前进最多100mm，自动结束于原近距离切换线`near`。`near`仅表示该交给精定位，不表示进入最终停车窗口。相机和串口保持同一会话，整轮结束后恢复语音；此阶段仍有分段停车观察，后续再优化连续性。

继续使用视觉比例0.75、同步系数10及原正式标定。目标丢失/观测过期结束本轮；MOVE只在原因6、TURN只在原因7正常完成后进入下一段，保留现有按键和超时的停止作用。未增加次数上限、低层保护、机械臂动作或夹取。每段结果仍追加到原SD日志，动作停稳后写入，旧素材保留。

```bash
./scripts/host tools/deploy/k230_car_align.py --auto-approach # 仅生成自动分段接近包
./scripts/host tools/deploy/k230_car_align.py --approach      # 仅生成原单步包，供回退
```

自动模式一次唤醒累计可能前进数十厘米，实测前按用户要求先留出约0.5～1m接近通道、机械臂保持准备位；拔掉电脑和适配器外接线，方块在每轮运行中不动。本阶段结束后再接静止精定位、停车窗口判断及近处小动作，不混入尚未采用的机械臂候选外参。

## 用户指定的后续流畅性目标（2026-10-24）

- 最终演示希望精准停车一步到位，避免通过反复停下、定位和小步挪动表现整个过程。
- 希望“远处接近”与“近处精准停车”连续衔接，观众看不出两个阶段之间明显的停车等待或顿挫。
- 该目标须同时满足已有的停车允许区域、尽可能靠近及摄像头画面中线要求；不是以取消定位检查换取表面流畅。
- 用户起初要求先记录、不急着改；2026-10-30已明确将全程流畅化提前到精定位之前，正在实现上面的连续粗接近。近处细定位与最终一步停车仍为后续工作。

后续动态追踪要求（2026-10-30）：覆盖整机任务全过程，包括远处接近、近处定位、精准停车，以及机械臂已经开始夹取的阶段。方块若被人为移动或移开，小车和机械臂都应及时识别变化、协调应对，并根据新目标状态重新追踪或调整，不能把停车或开始夹取当作目标永久静止的前提。具体响应时延、机械臂动作阶段如何中断/更新、是否需要小车重新接近及二者如何协调，留待后续共同设计，当前不预设执行策略。用户本轮仅提前体验动态效果，明确要求先记录、后续再做；当前不修改跟踪恢复、任务结束条件、运行时限或机械臂动作。该历史阶段尚未实现；当前已启用的追踪规则见[全流程追踪](full-process-tracking.md)，实际效果待整车验收。

## 早期分段接近的离线候选流程（历史）

以下是保留的分段规划器行为；当前连续停车v2以上面的“当前阶段”为准。

1. 远处使用1280×960全画面蓝色色块跟踪，不受原近距离ROI限制。结合面积、形状、桌面投影和20mm高度比例排除明显错误候选；连续3帧确认后才能请求移动。目标消失、跳变或超过500ms即停止使用旧结果。
2. 先向摄像头画面中线对齐，再分段前进。约到已有最远参考位置时，停车并请求现有精确定位。远处色块底边的桌面交点仅作接近代理，不能送入机械臂抓取。
3. 近处用精确视觉返回的原始Base坐标判断，先纠正横向位置，再前进或后退。进入允许区域返回`arrived`，由后续整车入口决定交接，不自动触发机械臂。
4. 一张新观测最多对应一次短动作。执行器检查固件版本和状态，失联或异常停车后不自动重启。动作结束后，编码器连续200ms不变才允许下一轮定位。UART查询期间观测过期时拒绝运动；板端接入应提供`time.ticks_ms`作为执行器时钟。

`synchronize()`用于启动时已知静止的小车；它确认零输出，不能单独证明车体静止。现场首次进入流程前应确认编码器稳定。每次动作结束的稳定检查只是初始工程规则，仍需观察实车滑行。

## 允许区域

配置在[workspace_definition.json](../../configs/car/workspace_definition.json)，数学判定在[parking_window.py](../../device/k230/car/parking_window.py)。

- 纵向最近为0、最远为1，原允许区间0～0.5；横向原允许区间−0.5～0.5。换算毫米后四边分别内缩10mm。
- 中线使用摄像头画面`u=640`，保留已测左右宽度，随距离移动横向区间。使用方块中心高度10mm的相机投影；展示照片上的框投影到桌面。
- 最终Base X范围约241.813～263.751mm，横向宽约34.281mm。横向中心为`Y=0.1103983514*X−0.4365386555`；只在上述近处范围作为局部拟合使用。
- 输入是视觉的原始方块中心，不能叠加机械臂夹取补偿。数值可复现不代表物理精度已验证。摄像头位置、分辨率、翻转或外参改变后须重新确认窗口。

当前目的地从完整内缩窗口的中心X约252.782mm向机械臂偏移纵向边长的1/4，落在近侧1/4深度X约247.297mm；主停车和最多一次微调使用同一目的地，原允许范围不变。

## 文件与接口

| 文件 | 用途 |
| --- | --- |
| `device/k230/car/blue_tracker.py` | 原生`find_blobs`输入，输出`tracking`或未确认状态、画面中线误差、桌面接触代理及时间戳 |
| `device/k230/car/ground_projection.py` | 共用标定的像素射线与桌面交点，保持远处定位与精确视觉坐标一致 |
| `device/k230/car/visual_align.py` | 将共享粗观测换算为画面中线偏角，每次只调用一次已验证的定角控制 |
| `device/k230/car/align_voice.py` | 语音、共享相机、定角控制及转后再观察的任务入口 |
| `device/k230/car/near_runtime.py` | 一次移动细测、编码器距离传播、持续粗测转向、静态验窗及最多一次修正 |
| `device/k230/vision/physical_side.py` | 小车与机械臂共享的原始物理侧面定位，不访问相机或电机 |
| `device/k230/vision/physical_side_session.py` | 同帧JPEG95持有、分片解码定位、原图字节归档交接 |
| `configs/car/near_parking.json` | 当前连续停车v2候选参数，与早期分段配置分开 |
| `tools/deploy/k230_car_align.py` | 视觉对准独立部署包；保留原入口备份、逐文件哈希核验 |
| `device/k230/car/approach.py` | `coarse()`和`fine()`输出动作意图，不访问硬件 |
| `device/k230/car/pulse_executor.py` | 注入`MotorLink`，每约100ms调用`poll()`，管理单段动作、异常停止与编码器稳定等待 |
| `configs/car/approach.json` | 跟踪、近处切换及7种运动参数；运动参数全部为`null`，缺少参数会明确拒绝运行 |
| `host/car/runtime.py` | PC回放加载配置，检查视觉内外参配对和分辨率 |

近处输入格式为`status=localized`、原采集时间、`cube_center_Base_mm=[X,Y,Z]`，失败不能填入旧坐标。早期分段模式停稳后精测；连续停车v2在运动中分片执行唯一细测，由轮速更新维持通信，再用新静止帧验收。

共享视觉接口适配位于`device/k230/car/observations.py`，`ApproachPlanner`可直接消费`aic.vision_observation.v1`结果。调用侧用`CameraSession.capture()`取得借用的RGB565图像及frame元数据，远处可交给共享`track_coarse(image, frame, tracker.detect_frame)`；近处沿用共享精定位返回结果，不能把原生RGB565直接冒充已有JPEG95解码后的精定位输入。`observations.py`适配器不初始化相机或决定远近切换；相机生命周期由`align_voice.py`任务入口持有。

适配核对模式、1280×960、帧标识、采集时间别名与`k230_ticks_ms`时钟域；精定位须声明Base/mm/几何中心且未施加XY补偿。未知采集时间保持None，因此不能驱动动作；失败payload中的旧坐标不作回退。控制端now_ms必须来自同一次K230启动的ticks时钟；跨重启应清空跟踪及控制状态。旧格式离线回放继续兼容，现有频率、有效期、阈值与停车策略未因适配改变。

新增MSPM0协议v2支持左右轮独立有符号PWM及10～5000ms定时动作，保留原START、B21停车、5秒上限及1秒心跳超时。固件已运行v2，前后短步已确认。双轮反向配合的转向原因未明，第一版候选改用单轮正转形成弧线；两侧单独正转的左右转效果均已确认，后续已完成左右5°/15°基础试跑，仍没有外部物理转角标定。命令应答及定时停车通过不代表实际转向精度通过。详见[电机协议与实验](../../device/mspm0/motor_uart/README.md)。

## 单步联调依据（2026-10-30，现已接续自动分段入口）

视觉对准第一版已安装并确认监听：说“思达思达”后先释放音频资源，打开共用`CameraSession`，用现有全画面蓝色跟踪连续3帧确认目标。比较目标中心与同一图像行的`u=640`参考射线，经原内参去畸变、原外参及桌面法向换算转向偏角；不把内参主点`cx=652.619`或机械臂Base Y=0当作中线。画面误差不超过48px时不转；否则将偏角取整并限制单次最多15°，正左负右，使用现有单轮弧线`TURN`。

第一轮已导出13条触发记录：12次实际转向全部原因7、停车后无再次输出，1次无目标未移动；12次中线绝对偏差均减小，均值264.25px降至87.75px，但仅4次进入±48px，全部越过中线。用户确认每次转动时方块静止。现已安装视觉转向比例0.75候选并确认监听就绪，在原始偏角取整前相乘；保持标称轮距、编码器比例、底盘固件和相机标定不变。该系数来自这批数据的任务级响应，226项检查及原生只读跟踪检查通过，后续复测结果如下；该系数不能当物理角度标定。记录与探索分析位于本机`data/car/visual_align/first_trials_20261030.json`及`gain_exploration_20261030.json`。

0.75复测新增13条触发记录，其中12次转向全部原因7、停车后无再次输出，1次无目标未移动。12次中线绝对偏差均减小，平均转前332.17px、转后36.17px，8次进入±48px；另4次偏差49、54、58、99px。上一轮比例1的转后均值87.75px、4/12居中；两轮起始位置不同，作为现场描述性比较，不当严格同条件A/B。用户反馈“跑了好几轮，感觉可以”，当前保留0.75，基础方向与单次停车联调可收尾，不宣称每次都精准居中。两轮共26条视觉记录（24次转向），原13条逐字节保留；记录及汇总见本机`data/car/visual_align/gain075_trials_20261030.json`及`gain_comparison_20261030.json`。下一步接入视觉引导的短距离前进；短步接近的进展见下文。

### 视觉转向比例与底盘控制的联动约定

2026-10-30用户确认：现阶段直接补偿“视觉偏角 → 转向命令 → 车身运动 → 画面变化”整条链路，继续使用`turn_gain=0.75`方案。它是整条链路的经验控制系数，不能据此认定误差来自视觉，也不能排除编码器换算、底盘转向控制及单轮弧线平移的影响。原始视觉偏角仍单独记录，不把这个系数写进相机标定或标称轮距。

当前0.75对应已下载的`turn_coast_003_20261030`底盘固件、现有单轮正转弧线和相机安装/标定。底盘控制基线及源码哈希见本机`data/car/turn/coast_tuning_20261030/preparation.json`；0.75的依据及部署记录见`data/car/visual_align/gain075_preparation_20261030.json`。方案已获用户认可，当前条件下已复测12次；后续控制变更及新条件仍按下述约定复验。

**后续微调底盘转向控制时，必须一起重新验证视觉转向比例，必要时重新估计，不能默认旧0.75继续适用。** 这包括轮速PI、起步输出、速度/加减速、提前断电/滑行预测、PWM限制、单轮/双轮转向方式，以及轮距或编码器换算的变化。相机安装/标定、底盘结构或供电条件明显改变时也应复验。

每次调整保留旧控制版本和对应系数，用少量左右静止方块试验比较转前/转后的画面中线偏差，再决定新系数；记录“底盘控制版本 + 视觉转向比例 + 试验条件及结果”。不要同时盲改底盘与比例、重复补偿同一个误差。先以实际居中效果满足学生项目需求为准，不要求先做独立物理转角标定。

### 视觉对准与短步接近的执行与试验

短步接近第一版新增可选`--approach`部署模式，代码及233项检查已通过，已安装、核验回读配置并确认语音就绪；原生只读采集时双轮零输出，首轮6次触发含4次转向及2次100mm前进，均按相应角度/距离条件结束且停后输出零；用户报告适配器线干扰，不能据此验收物理前进效果或调参。原26条视觉记录逐字节保留，现共32条，干扰分析位于本机`data/car/visual_approach/adapter_cable_interference_20261030.json`。电池已充好，用户正在更换，待确认后保持参数做无外接线复验。每次唤醒只执行一个动作：粗观测未确认或过期则不动；画面偏差超过±48px时按0.75整链路比例转向；已经居中时，使用同一帧的`ground_contact_proxy_Base_mm[0]`选择一次前进。步长为`min(100, floor(proxy_X - 315.68956))`毫米；剩余不到10mm时返回`near`并停止粗接近，等待以后接入精定位。315.68956mm沿用原有近距离定位切换参考，不是最终停车窗口；10mm最小步长用于结束本阶段，不新增故障保护。

换回充满电的电池后新增7条记录，旧32条逐字节保留，现共39条。用户报告直行主要左偏、转向常未到位，方块不动。两次前进的左右轮编码器估算分别91.228/98.360mm（目标100mm）、58.526/62.851mm（目标66mm），均右轮领先，符合左偏方向；对应画面误差从2px增至266px、从−13px增至155px。4次转向中3次进入±48px，另1次为58px，不能把整段接近中的偏差都归于转向比例。先修直行，不同时调0.75比例。

本机已准备直行专用`STRAIGHT_SYNC_GAIN`从3改为10的候选，增强累计轮程差反馈；速度PI、PWM及缓升、直行速度/断电预测、转向函数及标称几何不变，无新故障保护。已编译并通过16项底盘测试，转向模型输出逐字节相同；较大起转不对称的合成模型中末轮程差减小，但模型不是实车标定。**同步系数10已于2026-10-30下载并经独立映像CRC与范围外Flash重复核验，主控零输出及原K230监听恢复已确认。首轮复验6次100mm的停稳轮程差绝对值约0.08～1.86mm，用户反馈略有改善但仍左偏，直线效果尚未通过，暂不继续提高同步系数。** 原始记录与分析见本机`data/car/visual_approach/battery_trials_20261030.json`；候选、旧版备份、测试与映像哈希见`data/car/straight/sync_fix_20261030/preparation.json`。试跑前须先将人工方向核对后的机械臂恢复准备位并保持扭矩，再进行无外接线的电池短程对照。

继续复用原100ms心跳、200ms编码器稳定观察和MOVE定距控制，底盘固件、直行参数及视觉转向比例不变。转向后即使已居中，也不会同一次唤醒继续前进；前进后即使又偏了，也不会同次补转。相机整轮保持开启，移动时不采图，停稳后重置跟踪器再观察，随后关闭相机并恢复语音。新动作仍追加到`/sdcard/aic/car_align/runs.jsonl`，根据`motion.action=move/turn`和`plan.distance_mm/angle_deg`区分；旧26条视觉记录及原72条定距/定角记录保留。前进指令上限100mm是标称编码器目标，不作物理距离精度新声明。

初次只读检查相机采集正常、计算时观测年龄84ms、双轮零输出。带目标初测及比例0.75复测均已完成，保留当前版本继续后续接近联调。同一适配器、机械臂保持准备位，方块约0.5～1m、稍偏左或右，转向期间保持方块不动；拔掉电脑USB后逐次唤醒，复测后接回K230导出前后观测和运动日志。部署及只读记录见本机`data/car/visual_align/first_version_20261030.json`。

```bash
./scripts/host tools/deploy/k230_car_align.py                     # 只生成本机包
./scripts/host tools/deploy/k230_car_align.py --install --activate # 写入并设置下次启动入口
./scripts/host tools/deploy/k230_car_align.py --approach --install --activate # 启用居中后的单次前进
```

直行第一版已完成100mm×5、150mm×10、300mm×5，共20次落地语音运行，用户确认各轮正常、平稳。同一套控制参数下，三组标称编码器平均行程分别97.0、146.8、296.5mm，各次均在目标±5%内；全部按距离结束，停车后无再次输出。300mm到零输出首次采样为3.82～4.08秒，未触发5秒时限。基础运行及重复性验证可收尾，实际物理距离精度仍未外部测量；直行测试阶段以300mm结束；当前语音以最新部署记录中的视觉模式为准，没有自动追加运动。汇总见本机`data/car/straight/distance_test_summary_20261030.json`。

当前在12V、额定最大10A适配器供电下，已完成新版左右5°、15°各5次，共20次独立语音运行。用户确认全部方向正确、平顺、停后未再挪动；日志全部按角度原因7结束、停车后输出保持零。转向滑行预测0.03秒、最小0.5mm，直行控制保持原样；固件及源码哈希与已下载并核验版本一致。按学生项目的基础效果要求，本阶段大小可控转向验证可收尾，先保留参数。

| 目标大小 | 左转编码器估算均值（范围） | 右转编码器估算大小均值（范围） |
| --- | --- | --- |
| 5° | 5.171°（4.575°～5.819°） | 4.966°（4.729°～5.406°） |
| 15° | 15.121°（14.562°～15.596°） | 15.046°（14.643°～15.512°） |

5°与15°在两个方向的估算范围均明确分开，均值接近目标，仍有单次波动；物理转角未外部测量，不宣称实际角度达到某百分比精度，也不将直行±5%要求套到转向。1°～30°是软件支持范围，当前实车仅验证5°及15°。保留当前参数，后续换回充满电的电池做少量同条件复验，再接视觉偏角到转向控制。固定角度独立测试已收尾，当前已启用上面的单步视觉接近模式；连续自动接近仍未接入。

全部72条SD记录及失败证据保留，最新导出逐字节包含原67条。当前版本20次的汇总、原始日志引用、固件备份和部署记录位于本机`data/car/turn/coast_tuning_20261030/size_validation_summary.json`及其所在目录。

原起步修正版在久未充电的电池下5°重复运行失败，换适配器后电脑连接和拔掉USB两种条件均恢复正常，支持供电因素；充满电的电池仍待同条件复验，不能断言仅电量低。两板独立供电、内部UART保留，运行时拔掉电脑线。机械臂保持准备位，此模式不发送机械臂命令、不加载摄像头。运动期间不监听或排队语音，停车稳定后追加记录并重新监听，旧记录不覆盖。

定角左右转第一版已完成代码、离线测试及编译，并于2026-10-30通过USB/BSL烧录及独立CRC核验，范围外Flash重复CRC与下载前一致；独立定角测试已收尾，当前K230改为上述视觉对准入口，部署未发送运动。旧版左右15°及左右5°各5次基本运行已通过现场确认；新版左右5°及15°各5次基础验证均完成。使用已确认方向的单轮正转弧线：右轮驱动左转、左轮驱动右转；按`(右轮行程−左轮行程)/119.2×180/π`估算角度，包含未驱动轮实际滚动。正角度左转、负角度右转，初版支持1°～30°。参考轮程差速度巡航40mm/s、收尾20mm/s，沿用150mm/s²参考加减速及现有轮速PI；到预计滑行余量时一次撤输出，不补转。原直行控制参数不变。名义角度不等于实测车身转角，直行±5%要求不自动成为转角精度要求。

旧版左右15°各5次均经用户确认方向正确、平顺、停后未再挪动；全部原因7及停车后零输出。编码器估算左转均值13.561°、右转大小均值13.010°，均比15°偏小，物理转角未测。旧版左转5°及起步修正版在原电池下均出现实物不动，不能凭编码器变化认定运动成功；失败原始记录和分析保留于本机`data/car/turn/left5_issue_20261030.json`及`data/car/turn/startup_fix_20261030/failed_runs_20261030.json`。起步修正只将目标轮按原32/10ms缓升至既有1600上限，标称前向轮程差达1mm后单次交回原PI，保留其余控制参数及已有保护；编译和16项底盘测试通过。供电对照恢复运行不意味着代码修改单独解决了问题。每次唤醒只执行一次，不自动连续跑5次；各次间可重新摆车。记录目标角度、两轮编码器和轮程、PWM、首次零输出与停稳后的估算角度、停止原因，并结合现场观察判断。

部署须先完成支持`TURN`的底盘固件烧录及核验，再安装K230对应模式；更换左右方向或角度只需切换K230部署包。以下命令默认只在本机生成包，加`--install --activate`才写入并设置下次启动入口，部署本身不发送运动：

```bash
./scripts/host tools/deploy/k230_car_straight.py --turn-deg 15   # 左转15°
./scripts/host tools/deploy/k230_car_straight.py --turn-deg=-15  # 右转15°
./scripts/host tools/deploy/k230_car_straight.py                # 按straight.json直行，当前300mm
```

K230重启后应看到`CAR_STRAIGHT configured`中对应的`action`和目标，以及`voice_ready`，确认后才拔线试跑。原机械臂入口与资源保留；本机部署包和启动备份在`data/deployments/k230_car_straight_*`。

实时跟踪已由用户现场确认。演示视频已完成电脑后期，推荐本机`data/car/report_assets/live_blue_cube_20261024_164520/blue_cube_demo_tabletop.mp4`；原片、连续版、完整修正版、截图和处理说明均保留。叠加框与数据是电脑离线分析；毫米距离仅在人工确认的桌面接触区间显示，不能作为机械臂精定位坐标。

新调试器USB自报`J-Link V9.3 Plus`，USB权限和自身约3.32V参考电压已确认。用户确认接线与主控上电，但9.86a、TI文档使用的7.94k、通用内核、原生命令行及按住RST期间的调试端口读取均未连通。主控原程序经K230查询20/20成功、v1及零输出，测试后语音恢复；不能认定主控或新调试器已损坏。实物标签称VTref与3.3V输出默认内部短接，不能直接照搬旧fireDAP的VREF接法。候选三线接法与供电限制见[硬件接线](../hardware/connections.md#mspm0-swd)。

历史已有旧调试器SWD无应答记录，现已通过[主控USB/BSL下载](k230-and-mspm0.md#当前下载方式主控-usb--bsl)完成v2升级，SWD原因单独排查。首次CRC校验不一致的记录保留；未重新擦写，独立会话连续两次映像CRC匹配、写入范围外CRC与下载前一致后才启动应用，UART2确认v2和零输出。CRC核验不能表述为逐字节回读。落地准备位与第一步向前停稳已由用户确认；每步前进上限100mm，试验使用更短的400/600ms时限和标称20mm编码器提前STOP，记录中包含滑行。用户可能手动挪动，停车期间的计数变化不直接判为故障。早期`approach.json`的7种PWM运动参数仍为`null`，不能用于启动旧分段规划器；当前基线使用独立的continuous/near配置，不依赖这些字段。固件、落地记录和详细交接分别见本机`data/car/firmware/LATEST.txt`、`data/car/ground_steps/LATEST.txt`、`data/car/handoff/LATEST.txt`。

## 离线复现

```bash
./scripts/check
ASAN_OPTIONS=detect_leaks=0 ./scripts/mspm0-tools python -m unittest discover -s device/mspm0/tests -v
./scripts/vision tools/analysis/replay_car_approach.py --synthetic --output data/car/replay
./scripts/host tools/analysis/simulate_car_approach.py --output data/car/simulation.json
./scripts/host tools/diagnostics/replay_k230_car_tracker.py --help
```

初版177项PC测试、13项MSPM0测试通过，包含停车稳定与观测过期检查；底盘固件GCC编译通过。后续30张远处实拍验证及标注修复完成后，PC测试更新为196项通过。图像回放14组符合预期：3张已有实拍、9个合成远处方块、空场景和纯蓝干扰。15组理想运动仿真均进入窗口，覆盖230～1000mm和左右偏移，最终X为242.000～246.934mm。原图和结果保存在本机`data/car/approach_replay_20261024/`及`data/car/approach_simulation_20261024.json`；远处实拍阶段结论见[采集与色块识别](car-far-capture.md)。

PC色彩适配器是LAB近似，不保证与K230 RGB565完全一致；重复同一照片3次只测试确认逻辑，不构成真实视频验证。合成图片不能证明真实1米识别能力。运动仿真假设每段位移和转角、无打滑与测量误差，不能证明停车精度，也不用于填写真实PWM参数。

## 留待现场的最少工作

1. 当前基线已安装并获用户现场认可；后续正式验收与新阶段联调均从该基线继续，不重复下载安装。
2. 按长距离测试约定先与用户沟通、整理桌面，再从约0.5m、小偏角、固定贴桌方块验证一次细测到停车的完整过程；检查计算期间不因细测降速、`t1/l1`与`t2/l2`补偿及实际细测耗时，核对当前`d=470mm`触发候选和2.0～2.5秒目标。
3. 按首次静态验窗统计是否达到超过95%一次入窗；窗外只给一次微调机会（新候选为ARC，旧安装版为MOVE/TURN），再验仍失败即结束，不能把补救成功计入首次成功。保存原图和配置/版本证据，不以粗代理点、`near`或编码器估算代替停车窗口验收。
4. 停车效果通过后，再由用户安排机械臂交接。共享静态几何结果保持原Base和标定定义，抓取补偿由机械臂处理；盲走直线不足和全过程动态重获仍留后续，不顺带调整。

展示图已生成于本机`data/car/workspace/overlay_20261024_001214_026101/demo_annotations/parking_window_demo.png`：纯绿色允许区域，被方块挡住部分虚线，深蓝色隐藏边，红点标记底面中心。
