WHU-SAS/aic-robot/docs/guides/arm/K230_ONBOARD_PICK.md

# 第0版方块抓取演示

```bash
./scripts/demo-v0-pick --execute --hands-free
```

该流程依赖PC，代码与专属参数见`demos/v0_blue_pick/`；正式版进度见[视觉模块](../vision.md)。

每轮重新定位，从当前编码规划，无需先回中立。环境、权限和诊断命令见 [Linux 指南](../linux-arm.md)。

## 定位与目标

1. K230 使用 1280×960 RGB565，不镜像、不翻转；预热 30 帧，最多采 9 帧，提取蓝色方块的轮廓、物理面角点和棱线。
2. PC 匹配三个不同帧的稳定特征，按 20 mm 立方体解算位姿，检查重投影与几何一致性。正常只传特征；定位失败时尝试取回同帧局部图。
3. 用 `configs/vision/runtime/` 内外参换算到 Base 坐标，打印 `CUBE_CENTER_Base_mm`；XY 沿底座指向方块的方向额外外移 **10 mm**，每轮只补偿一次，打印 `GRASP_TARGET_Base_XY_mm`。
4. 对齐参考为**预计夹住 20 mm 方块时两指末端的中点**。高度基于估计桌面，非直接使用视觉 Z。腕部优先 25°，在既定 20～45° 内寻找四阶段完整逆解。

定位和规划完成后才发动作指令；先只读核对参数，需要开扭矩时先初始化当前位置保持。`--hands-free` 跳过终端放手确认。

## 动作

| 阶段 | 一次同步发送的六轴目标 | 下一阶段何时开始 |
| --- | --- | --- |
| 上方悬停 | 夹爪张开 30°（2389），模型最低指尖距桌面 80 mm | 采样观察 6 秒后 |
| 下探 | 开口不变，模型最低指尖高 **15 mm** | 采样观察 6 秒后 |
| 闭合 | 其他轴不变，6 号到预计接触位置再闭合 20 计数 | 夹爪位置范围 ≤2 计数持续 0.5 秒，独立复读仍满足后 |
| 抬升 | 保持夹持，回规划的 80 mm 高度姿态 | 采样观察 8 秒后结束 |

各阶段只发送一次最终目标，随后只采样；6/8 秒是观察窗口。闭合等待没有固定 3 秒超时，静止条件也不等于已经夹起。末端路径由各舵机运动共同形成。

程序核对已保存参数，不自动写 PID；速度/加速度见 [舵机基线](BASELINE.md)。

## 结束与排查

- 完成后**保持抬升与扭矩**；是否夹起由现场确认。当前没有放置或自动回中立。
- 动作中报错停止发送后续目标，不自动归位或断扭矩；保留参数、通信和关节范围检查。
- 每轮记录在 `data/logs/k230_pick_时间戳/`：`execution.json`、定位结果、原始/补偿坐标、逐轴反馈和最终 FK；失败图为 `frame_roi.jpg`（取回成功时）。FK 和高度是模型值。

当前标定适用于现有相机焦点、成像模式、相机与底座相对位置及桌面。改变这些条件后需复核标定。
