WHU-SAS/aic-robot/docs/guides/full-process-tracking.md

# 全流程追踪升级

当前启用的K230完整版本为`ac4f23a4072e440d`，52个程序／配置文件及清单回读、导入和真正复位后的语音监听已核验；近期6张存图的板端原生回放均定位成功且同帧关联通过，含此前失败的正视第1、4张，见[共享视觉](vision.md)。静态停车继续由精测点确定本段距离，粗距离波动、歧义和一两帧丢失不改既定终点；前进中连续三帧完全看不到目标，或确认真实整块移动时撤销旧行程。原速度、减速、滑行、触发距离、50ms停稳和闭合／抬升暂停视觉规则保持。用户现已要求彻底取消“因精定位识别不出而左右换角度”；该控制修改已完成离线回归并安装启用。优先改进精定位准确率，不能靠反复挪动车辆掩盖识别失败。近处精定位纠偏采用“新精测→完整执行→新精测验窗”的闭环，不先分类是人为移块还是控制误差；未入窗就按新测坐标重新计算，目标明确回到远处则回粗定位接近。粗图仍可观察可见性，但不靠近场粗框位移撤销正在执行的纠偏。实际夹取98%及当前完整1.5秒仍未完成验收。

纠偏后的新静态图必须对应当前画面，才能验窗或交臂；若计算期间画面已明确不对应，则丢弃该图、保持停车重拍，不改目标版本，也不因此转向或退让。当前版本完成1490项主机回归（跳过150项）；共享精定位沿用已通过162项视觉回归（跳过1项）的实现。本次未修改主控短ARC的速度、滑行和编码器标定；当前证据只能确认原纠偏被粗图自运动误判中断，不能据此宣称实际单次纠偏精度已经达标。

本版将粗检测的`min_pixels`和`min_area_px2`从25提高到500，颜色阈值、ROI、精定位及停车参数保持。历史30张远距原生真块最少3042蓝像素；33张远／近JPEG的PC回放均保留原目标。本次空场3帧的5个原生有效假候选均少于500像素，但仍有较大的无效蓝候选，不能只靠阈值清噪。新参数已完成板端导入、纯逻辑三帧计数及存图回放验证；纯白墙原图回放无可导航目标。新一轮真实行驶仍待用户试跑。

本版的“目标仍可见”复用既有尺寸和区域连续性，并按编码器传播参考像素；任意蓝色背景不能清零丢失计数，也不能覆盖原目标参考。用户最新选择替换“丢失后走完已知余程”：正常前进接近时，一两帧丢失仍保持原端点，连续三帧完全看不到目标则撤销旧余程，先STOP，再按原流程连续搜索；粗测几何或关联暂不确定但仍有合格方块线索时不套用该规则。已发近处ARC仍完整执行后取新精图；6号闭合期间暂停视觉的规则保持。已完成但等待身份的旧精测不能永久阻塞这一步。搜索开始即释放旧精测的距离权限，保留历史证据；重新确认的完整导航候选可在新的位置和尺度恢复追踪，不要求永远符合原近处框。看得见真块但暂不能测距时仍停下重看，不因精定位失败左右换位。底部恢复同样要求相符的目标区域或当前完整可测的大候选；外来弱斑块不结束原连续后退。新候选仅可先停车拍新静图，不能借此继承旧距离、导航或抓取权限。本版已安装并在真正复位后确认语音监听恢复；静态回放不代表实车丢失停车时延或抓取精度验收。

本轮失败原图证实首次静态精测已在近边外约16mm、右边外约30mm；后续18×19像素候选曾授予823mm路程，余程也曾由78mm变为776mm。本次恢复精测距离的接管和收尾权限，保留首／末`moving_handoff`指标中的原图帧、拍照／完成时刻、t1／t2真实编码、距离计划和发令时刻，避免64条环形尾记录再次覆盖最初交接。尚未建立精测距离时的粗候选尺度误认仍是已知问题；不能将本次保锚回归称为全部粗检测误识已解决。

真实记录确认两处错误：近处粗图已到目的地附近，程序仍先做259ms的JPEG再停车；停后关联歧义转入搜索，后续把胶带内圈蓝色印刷当作测距导航目标重新前进。候选在形成近处行进精测请求前按已有距离、轮程及原滑行模型控制速度，压图前再检查一次，余程耗尽先STOP、不创建该行进精测；停车后仍必须拍新静图验窗。粗测新增20mm立方体投影宽高比例相容性，合格的已关联方块优先于无测距蓝噪声，被拒绝的旧印刷不能盖住唯一新真块或改写可靠身份；多个合理方块仍保持歧义，候选继续一帧确认。未修改共享精测、停车窗口、速度曲线、机械臂或最终失败条件。

K230同一张失败JPEG对照中，旧版产生一个导航测距候选，新版不产生；各10次粗检测分别为31ms和31～32ms。30张远距原生检测框、历史近处左中右3框及本轮真块框均保持相容，本轮3个假框被拒绝。这是原图回放和框几何验证，不是新拍图、整车精度或95%首次停车成功率。原图、原始事件、分析与回放在本机`data/car/full_process_tracking_20261103/overshoot_repair_repeat_01/`。新版诊断保留首／末行进图与末静态图，最多3张，不在运动中写SD；历史图片不授予控制权限。

压图和原生视觉调用仍不能中途抢占，因此有限路程截止已交给MCU原10ms循环：有可靠粗／细距离的正向FOLLOW/SPEED附带未扣滑行的剩余轮程D，按当前编码器原点、70/50/2曲线和0.12秒滑行自主减速、撤去输出，不依赖K230及时返回。更新保留PI、PWM与原20秒累计时限；搜索／慢退沿原有符号接口。新的行进精测在压图前必须收到本次端点的真实ACK；主控已正常到点后，迟到的更新不重启，旧行进图不重新授予行驶／停车／交臂权限，转入新静图验证。无距离方向更新恰逢到点而收到BUSY时，保留拒绝原包并另读真实STATUS，不伪造成功或吞掉NoACK。参数仅从K230配套到主控执行，未新增时限、最终失败规则或放宽视觉检查。

当前MCU已实际下载并通过独立映像双CRC、范围外Flash重复CRC及10条零轮速原生核验：映像SHA`c6eda69405f6b624d29537578bd91c0faed64667802b8ac6d634f1b6e09b8e31`，23552字节页范围TI CRC`9940b381`。真实协议与生产C控制器联动的离线场景验证了780ms K230计算空窗中MCU先按距离停止、迟到更新正常返回、旧图不重启、随后拍新静图；编码器与相机仍是明确的模拟输入，不代表真实刹停误差。名义轮径、粗距误差、弧线自运动与实际滑行仍须实车验证，不能宣称95%首次入窗已实现。主控与K230新可选D协议必须配套，v2帧格式本身不证明具备此能力。

新版底部视野恢复改为15mm/s连续倒车、边退边粗观察，不再先退10mm试探，也不每10mm停车重做精测。有可靠的底边离场记录时，当前完全看不到方块或只看到裁边局部，仍可继续这次慢退；弱蓝片、歧义或旧帧不能当作完整恢复。重新识别到合格完整方块后先STOP，按原条件确认停稳，再拍新静图精定位，不先前进或转向搜索。沿用用户原100mm短动作边界，以原起点编码器累计并考虑原滑行模型，暂停、20秒分段和目标版本刷新不能重置该预算；到边界保持停车观察，不继续盲退，也不转圈绕过这次恢复，后续完整方块出现仍可重新精定位。真实位置纠偏仍按一次计算的整段ARC执行。

完整视野须持续到新静态结果交接：精测计算期间若方块再次移走，恢复粗观察后撤销该图，保留原预算继续慢退，不对裁边图反复精测或转入局部旋转。新静态结果的目标绑定被拒绝时，同样保留原预算，不能当作恢复已经完成。旧的底部消失方向仅供搜索回忆；重新看见目标后的普通遮挡，不能仅凭这条旧方向再次授权盲退。

用户随后报告下探前后突然归位。该轮记录在本机`preclose_return_01/`：悬停已到位，下探发包后由`chassis_moved_during_grasp`撤权，未执行首次闭合，随后重新定位并完成第二次尝试。用户确认未碰车或方块，批准执行抓取阶段累计轮程容差改为1.0mm；静态验图、规划及未发首次悬停仍为0.1mm，原停车参考不滚动重置，电机重新运行仍撤权。新诊断保留触发参考、当前编码、名义毫米差及阶段；后续0.292mm样本不能冒充本轮缺失的触发读数。

用户2026-11-03确认新接收窗为前后`[0,0.6]`、左右`[-0.6,0.6]`并保留10mm内缩。新构建有效X为242.7116～273.1627mm，横向相机中线两侧各约22.4716mm；近边不变，四分之一处目标改为X250.3244mm。历史标定及原0.5窗口的坐标换算记录保留，这是接收规则扩展，不是重新测得物理边界。

上版`0d5e760691b3ba45`整车试验未通过：接近固定方块后，停车精测失败并转入持续搜索，用户已叫停。异常记录在本机`data/car/full_process_tracking_20261103/abnormal_motion_01/supervised_pick_020235/`；部分中间原图已释放，不能补称完整画面回放。

静态任务继续以快速、流畅优先，动态异常允许稍慢确认。当前修复版修正近处恢复、搜索方位与候选权限，停车窗按上述用户方案扩展，保留视觉几何、机械臂和夹住标准，不增加任务最终失败条件。下文历史部件对照和旧版安装记录仅说明各自测试范围。机械臂契约见[分步抓取接口](arm-tracking.md)，整车约定见[完整任务](robot-task.md)。

旧版`c26879c5391f9f87`安装前完整检查1052项通过（79项跳过），另在视觉环境完成63项检查（2项跳过）；5张留存原JPEG经真实静态会话入口均定位成功，困难集无运行错误或明确预期退化。这些结果覆盖代码及历史图片回放，不是缺失停车图的复现，也不代表板端耗时或实车成功率。

脱离调试核验：程序已写入SD不等于当前仍监听。原恢复工具在USBDBG内执行启动文件、看到`voice_ready`后关端口；本板固件会因调试断开而软复位，停止该脚本。恢复流程改为真正`machine.reset()`、关闭旧调试连接、纯CDC零发送等待SD自动启动的`voice_ready`，并核对持续音频及关闭/重开纯监视后仍运行。A4/文件读取也属于调试请求，不再把它们当无干扰运行监视。机制见[官方固件](https://github.com/kendryte/canmv_k230/blob/canmv_k230/port/omv/ide_dbg.c)，历史原始启动及复连日志在`data/car/full_process_tracking_20261103/voice_no_response_01/`，本次恢复记录见上述安装目录。

补光灯采用IO26常驻输出：待机灭，唤醒任务亮，抬升后现有编码器夹取成功确认时灭；空夹／恢复／重试不提前灭，退出返回待机则灭。GPIO在启动时初始化，语音回调仅写电平，不增加等待、读取或改变车臂阶段条件。接线见[补光灯](../hardware/connections.md#k230补光灯)。

## 目标与取舍

从语音启动到用户指定的夹住成功判据满足，任务负责观察、接近、定位、抓取和恢复；6号实际开始闭合至抬升成功暂停视觉，空夹／失夹恢复后再观察。第一版车停臂抓；取消纠偏次数上限，不新增最终失败条件。固定目标仍追求一次停车、一次夹取，首次停车入窗超过95%仍是未验收的现场目标；人为移块引起的重新追踪与固定目标纠偏分开统计。

粗定位每帧估计方向与桌面粗距离，也记录可见性和移动趋势；精定位按需同时校正位置、方向和夹持面。停车目的地继续按当前10mm内缩窗口的近端四分之一计算，原前进速度曲线保持。新的调度负载可能改变实际精测耗时，触发距离须后续结合板端计时复核，不能仅凭旧参数保证2.0～2.5秒。

## 一台相机与分步调度

整车持有唯一相机，抓取阶段不关闭相机或另开一套。追踪候选先启动相机流与MediaManager，再开音频，默认32块预热期间小步完成原30帧／30ms相机预热及五组视觉／控制预加载，全部就绪并reset识别器后才监听。监听与多轮任务复用此相机及固定投影；Tracker、目标状态、任务、UART及底盘同步每轮新建，首轮精测不再承担预导入。首次上电仍有准备时间，不发送车臂动作；未计板端新启动时间，不将假音频队列或PC计时当作提速实测。独立和旧单次入口保持原生命周期。用户最新选择精测优先并按预算穿插观察：精测持有原图，只有累计计算时间足以支付额外观察时才取新粗帧，不能恢复固定10Hz穿插。普通行驶及6号闭合前的机械臂执行仍以100ms粗观察为目标，静止规划为250ms；6号实际开始闭合后至抬升成功暂停取图、粗测和视觉目标更新，空夹或失夹进入恢复后重新观察；规划仍在粗观察之间推进。等待行进精测时，仍根据已有精测锚点或可靠粗距离、编码器及原滑行模型推进距离控制；轮速调整占用原250ms续租槽，不能只续HB而不检查剩距。精测按20ms软片连续推进，不因已经错过的相机截止时刻饿死，也不让每个数学小步骤额外睡眠。拍照指RAM内取帧，不逐帧JPEG录像或写SD。精测独立保存原JPEG95/BGR，新帧不覆盖正在计算的照片。

精测穿插预算只累计本轮`session.start/advance`的实际计算时间F，额外取图、粗检测和变化判断的整段成本计为C。下一次观察仅在`C＋预留成本≤0.1×F`时准入；预留初值60ms，按已测成本峰值上调。预算不足继续精测，不等待凑足固定频率；若预留观察时间会挤占原心跳／STATUS刷新，则暂缓该帧、回原轮次先完成必要通信。穿插入口不额外查询STATUS、写SD或执行完整车控／机械臂周期。移动帧须待原有真实反馈覆盖拍摄时刻再判断；过期帧保持未知，不把旧编码器或旧图伪装成新证据。比率设为0可作纯精测对照。记录计算量、观察量、次数和超预留，不能将预算计数或有限样本最大值当作端到端硬保证。10%约束固定目标下新增观察的成本；目标移动导致取消重算的耗时另计。实际端到端增量还受原心跳相位和运行时开销影响，可能略高于预算账目，仍待板端同图对照。

只要仍有精测或规划可推进，20ms后台片后立即进入下一片，省去固定5ms空等；机械臂执行、疑似变化、故障和无工作等待保留5ms。有效行进精测完成当轮先读取STATUS并下发补偿后的距离命令，不等待新粗帧；停车精测消费及首次悬停前仍取新粗帧核验；穿插观察受累计预算和不可抢占的原生调用限制，短精测可能一帧也不插，仍可能在计算结束后才发现移块。逆解的顶点高度计算保留全部935个夹爪顶点及原求和顺序，仅移出循环内常量、减少切片和函数调用；每条臂日志只序列化一次，stdout与SD复用同一文本，事件及验证均保留。

底盘`STATUS`返回两轮编码器、运行和输出状态。普通运动及尚未确认停车时保持原反馈节奏；行进精测暂停相机时，用250ms刷新HB的真实应答更新编码器，不能伪造新轮程；停车精测及确认停车后独立按500ms查询STATUS，不再与每张粗图绑定。行进精测接管只先读取最新底盘状态，不先拍新粗图；停车结果消费、规划完成后的首次悬停前仍各取最新粗帧和底盘状态。复用状态保留其原查询时间，不当作新读数；累计停车参考及目标版本规则沿用。

同时只推进当前需要的一项精测。RAM按用途保留最近一张行进精图和一张停车精图，跨目标版本仍留作诊断；同用途新图替换旧图，另可有正在计算的一张。取消旧工作立即撤销其控制权限，保留的历史图不因诊断留存而恢复导航、停车或交臂资格；采集时刻和原版本不改写。任务结束后归档仍保留的材料，不为中间图归档额外停车，不删除以前已落盘的报告素材或困难集。精测、规划和串口仍有不可抢占的原子操作，软预算不等于硬实时保证；记录真实采图间隔、最长观察空档和计算耗时，不能声称当前已经严格10Hz。

## 目标状态和结果有效性

- 原拍摄时刻、帧号、目标版本和编码器参考成套保存，计算完成时间不替代拍摄时间。
- 精测原帧同时保留粗测基线。粗框代理与精测几何中心不是同一参考点，不能直接相减；静止时比较局部粗框两侧共同平移，证据只在既有粗测时效的短窗口内累计。尚未建立精测距离时，正常连续接近的合格方块线索明显跳位属于`tracking_update`，继续差速跟随，撤销旧精测并按需边走重测，不进入停稳或全局搜索。大像素变化先考虑两轮行程解释的自身转弯，避免每张迟到精图都被正常车身运动抢先作废。普通运动模型偏差仍只记`motion_model_uncertain`；明确出画照常撤权。静止及抓取阶段保留原移位确认规则。单边分割扩张及正常尺寸增长不直接当移位，粗代理距离矛盾仅作诊断，不让首帧系统偏差无限累计成外移。低于噪声的极慢移、整块mask漂移及遮挡内移走后原样放回仍不可可靠区分。
- 粗测区分可见证据与有效桌面距离。触边、部分遮挡、疑似悬空仍可留下方位线索，不能强行输出有效桌面毫米数。
- 每帧只选择一次粗候选：框、像素中心、粗距离、关联证据和确认数必须同源。无关联、歧义、丢失或过期打断确认链；用户最新选择完整追踪包的新候选单帧生效，`navigation_confirmed`在首张唯一且有效的桌面测量后成立；初次接近、搜索新方向、精测查询和重新接管使用这一帧数。静止及抓取阶段异常移位仍按原两帧确认，连续丢失进入搜索仍为三帧，分别配置。旧独立对照入口保持原三帧。`association_confirmations`仅表示同一可见线索连续出现，几何失效时也可累计，用于请求检查，不授权新行程。可测候选的严格内含小片段可被外层实测框吸收为重复线索，不合并像素或补尺寸；独立蓝物体仍保留歧义。
- 方向、查询、身份和距离分别授权。当前唯一且形状合格的蓝色线索可提供搜索方向；稳定候选的`precise_candidate`可请求停车拍新精图，即使尚不能证明它是原目标或桌面距离无效。它本身不更新原目标运动参考、不撤销旧精测，也不建立导航或抓取坐标。弱线索须有与可信完整框连续的位置／尺度支持，才作为原目标的移动或出画证据；陌生小蓝片保持未知。新完整精测仍须通过原同帧后验关联，才可建立新几何。
- 状态区分一致、未知、疑似变化和确认变化。单帧掉框或粗框跳动不直接触发回位；正常跟随资料更新也会换目标版本并撤销旧精测权限，这不要求停车；静止确认移动或明确移出时，撤销旧距离和未发抓取计划；车身累计移动或机械臂恢复等原有失效来源仍保留。
- 有效行进精测仍须通过原图同帧目标关联、请求身份及时间检查；随后立即STATUS补偿并发SPEED／STOP，之后才恢复粗观察。已经绑定的完整定位或测距候选是本段距离依据；单帧`precise_consistency`偏差仅记未知，不撤销它。运动中确认外移须同时有可信关联、相容尺寸、两侧共同画面平移及扣除编码器自运动后的连续一致残差，沿用原两帧／像素门槛和500ms窗口；只有模型偏差、粗距离改变、歧义或陌生小片不算确认。大幅同尺寸移位后保持原位也可连续确认；仅尺寸突变或关联不清不改既定终点，连续三帧完全不可见则按新规则停车搜索，不宣称能凭颜色证明物理身份。正常距离STOP后的停稳阶段由新静图接管，轮速归零不能让旧行进锚点再补走。MCU已到点时迟到行进图不恢复行驶或交臂，必须新静测；停车精测和首次悬停保留新粗帧／STATUS及原累计静止检查。
- 逆解规划使用`begin_from_observation_steps`，目标变化时关闭旧规划生成器；它尚未发出舵机目标，取消不额外归位。规划最终返回惰性执行器，仍取新粗帧复核后才发首次悬停。已经发出动作的执行器则必须按准备位2覆盖恢复，关闭UART不能代替实体中断。
- 用户明确选择规划一律以准备位2的命令角度为起始参考，不管机械臂实际是否在该位置；初轮和恢复轮均不再为选解读取六轴。`planning_reference`标记`measured=False`，不冒充实际到位。执行阶段的反馈读取、到位及夹住判据保留；先验证完整抓取姿态，再发已有悬停目标。
- 用户最新规则：6号实际闭合起至抬升成功不再取图、粗测或更新视觉目标，不以画面变化撤销抓取。只用原舵机反馈和底盘STATUS／累计轮程检查；空夹或失夹进入恢复后重新启用粗定位。反馈保留真实采样轴和时刻。
- 闭合前的疑似外移继续暂停未发出的动作，确认移位后撤销旧计划；6号闭合后不再等待画面解除疑似，也不以闭合前残留的`suspected`阻断抬升或成功。是否夹到及抬升成功只按原舵机判据确认，底盘移动检查仍保留。

## 粗精配合与异常恢复

| 情况 | 下一步 |
| --- | --- |
| 无有效精测，目标可关联且桌面距离可用 | 粗方向和粗距离共同引导接近，合适时触发精测。 |
| 精测计算中车在走、目标不动 | 已知剩距继续按编码器递减，沿原曲线调速；SPEED/HB复用原续租时槽。剩距耗尽即停车，不因精测仍在算而继续前进。 |
| 行进精测期间方块移到视野内新位置 | 穿插粗帧或完成后的新帧发现变化时，剥离过时精测，继续跟随当前可用目标并按需重测，不刻意停车。 |
| 静止精测期间方块移动 | 旧图不再交臂，保持停车重新观察定位；遮挡／歧义保持未知。 |
| 前进时暂时看不到目标 | 一两帧保留旧余程；连续三帧完全不可见则撤销余程、停车搜索。推算点不能授权抓取。 |
| 明确移出画面 | 作废追向旧目标的计划，朝最后消失方向寻找；搜索中持续观察，首帧唯一有效候选即可恢复导航。 |
| 一直移动，精测反复过时 | 优先粗跟踪，位置变化缓和且确有精度需求时再精测，不堆旧照片队列。 |
| 停车精测失败 | 保持停车并拍新图重看，不因识别失败发左右摆头或试探退让；只有成功精测确认实际窗外偏差才纠偏。粗候选仍可见时，测距或关联不确定不直接升级搜索。 |
| 精测成功但目标仍在停车窗外 | 根据这张新图计算到约定目的点的纠偏并完整执行，结束后必须新精测验窗；不必先判定是谁造成了位置变化。新位置明确很远时回粗接近。 |
| 验窗或机械臂规划期间移动 | 旧验窗图不再有交臂权限；首次动作前检查最新观察。 |
| 悬停/下探/200ms分开发包期间移位 | 车保持停，臂按已确认位2覆盖恢复，清除未发包；从目标实际发出500ms后允许重新定位，不等实际回位。 |
| 已发送6号闭合目标 | 暂停采图、粗定位及视觉外移判断；沿用原6号反馈和五次稳定／Δ30判据。 |
| 恢复期间再次变化 | 合并重复失效事件，不反复发位2或重置500ms；新定位使用最新观察。 |
| 夹爪自遮挡 | 保留未知，不因自遮挡直接回位；明确出现于另一处的关联证据另行处理。 |
| 正常夹住并抬升 | 继续暂停视觉，仅按原五轴到位及6号夹持稳定规则确认成功，不因画面变化开爪归位。 |
| 空夹/失夹 | 按已确认Δ规则恢复观察和追踪，不结束整项任务。 |
| 抬离桌面/部分出框 | 继续记录蓝色和方位证据，桌面距离不可用时不伪造毫米数；取得有效几何后再接近/抓取。 |
| 多个蓝物体/关联不明 | 保留歧义，不只选最大蓝块冒充原目标；重新确认关联及物理面。 |

行进精测失败后的近处重测、目标移近后的重新精测，也必须受已有剩余行程约束。JPEG压缩或原生数学调用不能抢占；它们每次返回后，若已耗尽行程，就先交还主循环发STOP，不先推进另一段计算或拍新图。停车前的moving结果此后不恢复前进，也不交臂；按原停稳条件取得新静态精图再验窗。该修正不改变巡航／收尾速度、停车窗或既有时限，也不保证不可抢占调用内部的精确停车。

精测只在精度确有需要时执行：进入近区、确认目标变化后需要重新建立准确位置、静止时粗观察确认变化、换位后重定位、停车验窗和抓取所需几何不足。行进结果可服务距离/方向/停车规划；停车后的同一完整静态结果同时验窗并提供机械臂位置及夹持方向，不重复做同样精测。有限测距候选、粗代理及编码器推算都不能变成抓取坐标。

新追踪包显式采用`static_localization_policy=shared_side_only`：停车图可用该图唯一关联粗候选的原`bbox`提示共享侧面搜索，继续完成四边、2px及桌面约束验证，保留其原有小恢复。这个提示不代替完整边缘测量或完成后的严格同帧关联。不能定位时返回真实拒绝信息，保持停车并拍新图重看，不以识别失败授权左右换角度，也不在同一张图里长时间穷举旧恢复。只有该静测策略启用搜索提示；未配置该策略的独立、旧单次和离线入口保留完整恢复及原搜索行为。

正常流程不能被异常判断反复打断。行进精测未获得距离时继续使用已有接近依据，在下一张有效粗帧重试，不因本次精测失败主动停车；短暂粗测未知时可按编码器传播最后可靠粗观测，当前可见像素仍可修方向。仅有粗缓存时最多走完它已确定的剩余粗行程，然后停车观察，缓存不是精测或抓取坐标。

停车后的测量失败不等同于目标丢失。近处恢复单独保留同版本历史几何及原采集时刻，不能仅凭它在精测失败后猜测左右换角度；新版底部视野恢复按上述连续慢退处理，不用历史点直接授权抓取，也不每10mm重复失败精测。恢复后仍须重新停稳并取得新静态完整测量。确认移位、退出或版本变化撤销旧几何及抓取权限；同次底部恢复的物理起点、累计预算和耗尽状态单独保留。未知或暂时遮挡不伪造确认变化。

除上述底部视野恢复尚未完成的情况外，停车精测计算、抓取规划或首次悬停发出前，一帧未知只暂停交接，不永久污染该次成功精测，也不立即销毁未发计划。同版本恢复唯一关联、观察一致且车身始终未动时复用原图；确认移位、出画、车身移动、原有结果时效过期，或重现后仍无法确认几何一致时，才重新定位。首次动作前连续看不到目标达到既有搜索确认条件时，释放未发计划再进入观察／搜索，不能被暂停的计划永远占住流程。机械臂已动作后的自遮挡仍按执行阶段处理，不套用首次动作前的搜索。

全局搜索使用有符号`FOLLOW`低速连续转动，默认两轮−20/+20mm/s或+20/−20mm/s；转动中用`SPEED`更新方向、`HB`续通信，不再每10°结束一段ARC。新版优先当前可信且已关联的目标方位，其他可测蓝块不能盖过该目标；失去原关联后，新候选按用户最新选择在首帧即可改写搜索方向，但仍需通过原单帧形状／唯一性条件；新候选接管先撤销旧精测权限。相同目标的当前可信线索仍优先，历史消失方向供暂无线索时使用。取得合格候选后真正退出全局搜索：可导航则接近，距离尚不可用则进入`visual_tracking`局部观察并请求新静测。此时精测失败仅触发原10°局部换角，不等同于再次丢失；一两帧未知先停，确认丢失后才回全局搜索。身份和毫米导航仍按各自标准确认。

搜索进度属于一次持续的搜索过程，不因短暂蓝色闪现、再次未知或目标版本更新而重置。可靠底部丢失优先进入上述连续慢退，完整视野恢复前不先转圈，也不被可用粗距离提前带回前进分支；其他方向保留连续转向搜索。精测仍失败则保留进度，依据实际编码器完成换角后再检查。连续搜索沿用MCU原`FOLLOW`单次20秒总时限，`SPEED/HB`不延长它；到限停车后重新观察、停稳并按当前线索继续，不能承诺永久不间断。失联、按钮停止和拒绝响应沿用原等待语义，未增加任务放弃条件。可靠旧路线遇短遮挡仍可走完已知剩距。

诊断只在RAM保留最近64个目标、精测、车控与交臂转换，记录停车原因、原图到定位及首次悬停耗时；任务结束或正常中断时并入已有运行记录，不逐帧写SD。断电会丢失尚未归档的记录；异常后保持独立供电、先接回USB读取，再重启。粗颜色框的整体漂移与同色物体慢移仍可能不可区分，不能把粗测运动判断描述为物体身份或移动真值。

留存的精图同时保存原同帧`paired_coarse`框、证据、确认状态及实际`localization_bbox_px`入参。派生搜索ROI不能反推原输入框，也不能只凭同帧号认定粗、精选中了同一物体。上版`0d5e760691b3ba45`的已知故障链为成功行进精测正常消费、停车精测拒绝、换角后清除接近参考，随后底部裁边误触发全局搜索；已用真实观测字段和明确合成的控制序列回归，缺失原图的部分不称视觉回放。更早异常的往复动作及候选关联材料同样留在异常目录，不混作本轮实物验收。

JPEG、解码、求解器、相机或串口等运行异常先尝试`STOP`，再保存诊断并报告`fault_wait`；即使本地运行状态可能因ACK丢失而过期，也先尝试停止。异常／取消记录为`processing_interrupted`等真实状态，不伪装成正常的`no_complete_face`，也不自动继续发非零车臂命令。正常静态视觉拒绝保持停车重看；运行故障保留原处理和人工恢复语义。用户报告右移后左转约180°停下的现场日志保存在本机`search_half_turn_01/`；单帧蓝片污染搜索方向的路径已离线复现，但停转前电机状态和原异常缺失，实际停转原因尚未定因。首个故障及其STOP前状态、真实STOP应答单独留档，后续IDE中断不能覆盖它；故障后阶段明确为`fault_wait`并停止相机／车控推进，避免显示仍在搜索。

行进测距和停车完整精测在完成后统一检查`target_association`，再交底盘和目标记忆使用。检查原帧唯一关联粗候选的蓝像素质心与精测实际选用姿态的完整20mm方块投影范围，不要求质心落在所选侧面内，保留仅亮顶面被粗测选中的正常情况。姿态支持来自实际选面，测距审计中的其他候选面不能代替选面。没有唯一支持时返回`unknown`，原成功解及审计留档；下游收到清除XYZ和测距候选的失败观测，不建立锚点或交臂，继续原观察恢复流程。此检查不重拍、不重算PnP、不改原几何门槛；2px关联容差是本轮选择的像素判别参数，不能解释为原重投影RMS保证的最大误差。投影重叠的同色物体仍无法仅凭此必要条件证明身份。

当前正式追踪不再使用闭合／抬升的持物视觉关联区或FK预测：6号实际开始闭合后暂停软件取图、粗测与Memory视觉更新，硬件相机流可保持。暂停不等于停止舵机反馈或原底盘STATUS检查；抬升成功结束任务并保持夹持，未夹到或中途失夹则按原准备位2恢复并重新观察、定位、抓取。闭合前的悬停／下探继续观察，真实目标移走仍可撤销未执行抓取。关闭视觉期间不会通过画面发现人为抢夺，只依据原6号反馈识别失夹；原Δ30、五次闭合稳定、抬升±10／±1及200ms规则不变。

静态流程的前向纠偏：新静态精测显示纵向仍在窗口远边界外时，继续使用已有70→50mm/s连续速度曲线、实时粗方向和编码器剩距，不整段改用主轮15mm/s短ARC；最终仍拍新静态图验窗。同一纵向窗口内仅侧偏、需要后退或原地转向时保留有符号ARC，避免为极短前进距离额外启停。初始近起点仍先静态定位，不盲发巡航。

相机与真实KWS/音频的板端共存测试通过：原30帧准备约2.3秒，两个音频建销循环中的32段PCM完整，穿插12次取图均4ms、粗测37～44ms，无资源冲突；保留的原JPEG在板端完整侧面定位三次均成功。此处是静态部件测试，不能将提前准备的2.3秒直接写成实车起步节省值，语音响应、位2发包和首条非零车控仍须现场计时。

同一张音频共存测试原JPEG在K230新旧版各做三次完整定位及惰性规划，规划结果逐值一致；纯规划实际计算由857～932ms降到583～657ms。定位仍为1094～1216ms左右，未改视觉规则。这些计时不含持续粗观察、STATUS调度及首次悬停动作，不能写成完整停车到臂启动时间；对应原图及完整计划留本机。最终942项离线检查通过（74项跳过），不替代满电实车验收。

短ARC的两处故障已修正：主控起步交接时不再把编码器微动对应的低输出预置成负积分；K230遇ARC段`reason=3`时，结束本段、清除旧精测/运动依据，按原停稳条件重新观察和规划，不再进入无解锁调用的永久等待。旧精图不能恢复交臂权限；新目标已移远时可从新粗帧继续接近。B21、失联、拒绝响应和初始忙碌的原有等待语义保留，5秒单段时限不加长。记录保留超时次数和最近ARC结束上下文，避免被目标状态日志覆盖。

同12V适配器下，原`ARC,-5,5`在约630ms输出仅约−626/+645，停后两轮名义行程约0.21/0.18mm；新固件同时间达到约2.55/3.62mm。两种方向的5mm目标分别约820/510ms按距离原因8结束，用户确认都能转动并停稳。名义终程约−3.88/+4.38mm和+3.42/−3.19mm，仍有约1～2mm欠行程；这只验证基本起转与正常结束，未证明实物毫米精度、整轮流畅性或首次停车入窗比例。短动作合成模型界明确从1mm调整到1.5mm，最大短/长驱动轮误差约1.420/1.292mm；该数值退化不隐去，实际整车仍须新静态图验完整允许窗口。

主控映像SHA为`164d2eb4e3cc85042d6eb9834e61d59f104f891212b953fd7e68f11572703895`，页填充CRC为`91cedcbf`。独立双映像CRC及范围外Flash重复核验通过；K230新旧纯逻辑8场景对照通过，948项项目检查通过（74项跳过）。本轮原始状态、PWM/编码轨迹、模型和部署记录留本机`data/car/full_process_tracking_20261103/stuck_run_01/`。冷启动≤5秒仍待专项优化，本修复未改语音预热或相机启动顺序。

松爪记录、原配对观测和用户反馈在本机`data/car/full_process_tracking_20261102/grip_release_failure/`，接触修复在`contact_repair_01/`，本轮静态优先修改及验证在`static_priority_01/`。原图时间保持原值；纯逻辑回放的后续时间、运动或close状态是明确的回归输入，不冒充新拍图或实际车臂反馈。

## 离线开发和审查

目标记忆、粗观察证据和小车分步控制由独立代理并行实现；整车统一调度负责版本、相机、精测和臂接口交接。机械臂Agent复核方案并维护其分步执行器与共享精测可让出部分。使用模拟时钟、假串口、运动序列及原图回放验证旧结果失效、未知/移位区分、重复恢复合并、无次数终止、正常持物和固定目标流程。

新动作与判断参数集中配置，属于离线初始候选，不宣称现场已调好。既有底盘停止原因仍由上层解释，通信/执行异常不盲发动作，也不在本轮追加整项任务的最终放弃规则。已确定的实现问题自行修正；涉及未确定行为取舍时再交用户决定。板端频率、观测噪声、搜索/撤回轨迹和整车成功率留待后续联调。

构建新候选使用`./scripts/deploy-robot --tracking`，默认无此选项仍构建原单次流程作对照；构建不访问硬件。安装并激活才改变板端入口。有符号`FOLLOW/SPEED`需要本轮MCU与K230成对使用，不能只替换K230；当前已配套安装，非零连续搜索仍待实测。

闭合后的视觉关联与FK持物参考已从正式调度退出，不能再作为撤权依据。后续若评估新的持物观察方案，应另作离线对照；当前按用户选择，仅使用原舵机反馈确认夹持及失夹。

历史静止取图/精测/规划交织计时已完成，上版整车试验结果见文首。新版仍待现场复验：固定目标、精测中移块/遮挡/出视野、规划时移块、下探分包时移块、正常抬升及空夹/抢走恢复；保存首次入窗、实际发起抓取次数及恢复原因，不能把模拟通过写成现场成功率。

## 调整前的板端静态计时

候选`3009b36fd5f51395`已在K230以真实相机、STATUS、粗测、精测和可让出的逆解规划做部件交织诊断；保留正式规划日志成本。这是启动优先调整前的数据，仍采用100ms观察目标、每帧STATUS、规划前读取六轴、20ms后台软片及5ms循环休息，不运行整车任务或机械臂执行器。共190次观察，底盘输出均为0、编码器无变化；原`afeeca5807fd87b9`启动文件不变，测试后恢复其监听。

| 项目 | 本次实测 |
| --- | --- |
| 仅粗观察＋STATUS | 9.81Hz，最大采图间隔105ms。 |
| 行进精测路径，车实际静止 | 两次有效结果分别1.525/1.554秒；另两次未识别完整侧面，无测距候选。 |
| 停车完整精定位 | 四次均有效，拍照到结果1.465～1.541秒。 |
| 停车图到惰性抓取计划完成 | 4.273～4.405秒；未发送首次悬停目标。 |
| 精测／规划交织期间粗观察 | 整段约5.87～7.65Hz，最大采图间隔322ms。 |

首个长空档主要是JPEG95压缩233～257ms，不能被20ms软片抢占；解码78～87ms，六轴读取180～183ms。规划自身各次`next()`累计1.174～1.268秒，其中含六轴读取、日志和调用成本；加入持续粗观察后，规划墙钟为2.746～2.939秒。因此现在能交织观察，但未达到全程10Hz，精测也未稳定低于1.5秒。静态观测里的`processing_ms`目前仅反映最终包装，端到端时间须看原采集到ready时刻，不能把其0ms当作定位耗时。

行进路径失败主要是侧边缺少分布式一致性、边缘对比不足或姿态不满足要求，原图和拒绝信息已留本机交视觉侧复核。少量样本不作为识别成功率或理论最长耗时；本轮未测实际行驶、臂反馈轮询和动态恢复，也未验证拍照到完全停车2.0～2.5秒。完整报告、原图及哈希位于本机`data/car/full_process_tracking_20261102/static_timing_01/`；下一步先处理已发现的观察空档与行进精测拒绝，再安排整车联调。

## 启动优先调整后的验证

初次启用的`e019da5a4d742af1`已纳入准备位2参考、停车250ms观察／500ms独立STATUS及共享快侧面策略；以下是该次启用前的部件对照，所有计时均未执行车臂运动目标。旧`afeeca5807fd87b9`入口已备份。

同一份已验证的静态观测在K230做三组交替对照，两组均使用准备位2参考且保留原规划日志，只改变观察和查询调度：

| 规划期间调度 | 定位结果到完整规划 | STATUS次数 |
| --- | --- | --- |
| 100ms观察，每帧STATUS | 2.376～2.513秒 | 21～22 |
| 250ms观察，STATUS独立500ms | 1.262～1.278秒 | 3 |

该对照只测规划，实时粗观察和STATUS成本计入，目标拍照、压图和精定位成本不在内，不能称作停车到机械臂启动时间。完整记录在本机`static_timing_03/planning_compare.json`。

另一组真实蓝块画面在旧完整恢复中耗时14.568～16.464秒，最大观察空档约7秒，定位虽成功却严重拖慢启动。新快侧面策略对当前难图实拍在1.159秒返回`no_complete_face`，最大观察间隔295ms，保留三条真实边界拒绝；它尚未识别成功，不能拿拒绝耗时当成功定位耗时；当前规则改为停车重看并改进识别，取消当时的换视角恢复。同原JPEG的板端回放确认：旧成功图仍定位成功，定位主动调用耗时501～682ms、规划851～928ms；难图566～589ms明确拒绝。回放不包含拍照压图或交织粗观察，保留原帧时刻，不伪造当前采集。

原图、完整配置、报告和SHA位于本机`static_timing_03/`及`static_timing_04/`（共同前缀`data/car/full_process_tracking_20261102/`），真实难图已入本机困难集。PC困难集策略对照中，58组有标定可回放，39组两模式共同成功且坐标和完整pose逐值一致；另2组原依赖旧恢复，在当时的新追踪策略下转为换视角；该失败换视角规则现已取消。旧默认恢复行为不变。首次停车／抓取成功率及新识别恢复效果仍须整车验证。

修复版`7466a0d30e0fbff7`对这两张难图及重启后新拍图均恢复严格快侧面定位，PC原39组快测成功输出保持不变。K230同原JPEG四组各两次均完成定位及惰性规划；另三次实时静态取图，拍照到定位为1.171～1.218秒，到完整惰性规划为2.665～2.726秒，再取最新粗图和STATUS的首次发包前检查点为2.734～2.797秒。未执行首次悬停，不称实际停车到机械臂启动或抓取耗时；51次粗观察无确认移位，双轮编码不变、输出全零，最大观察间隔321ms。原图、原始帧时刻、配置、源码SHA与完整报告保存在本机同前缀`repair_validation_01/`。903项主检查（74跳过）及专用视觉84项（2跳过）通过，不代替整车试跑和独立实物精度验收。
