WHU-SAS/aic-robot/docs/guides/car-far-capture.md

# 远处蓝色方块采集

## 第二部分阶段结论：简单蓝色色块检测已完成

2026-10-24收尾范围为：静态实拍采集、色块检测修订、K230保存图原生验证、报告演示标注及素材归档。按这一范围可以进入下一部分，不将已验证的静态识别扩大描述为动态跟踪或实车闭环已完成。

| 项目 | 已有结果 |
| --- | --- |
| 实拍采集 | 30张K230原图完整下载，SHA256通过，全部保留用于当前色块评估 |
| 问题修复 | 初始PC回放5张错检、2张漏检；修订后同批PC及K230保存图回放均30/30选中方块 |
| 输出 | 整体色块框、图像中心、蓝色像素面积；演示另有估计的底面中心、摄像头垂足到它的桌面距离与虚线 |
| 板端耗时 | 单次检测29～32ms，不含采集、保存、传输，不作为实际连续帧率 |
| 回归 | 196项PC测试通过；14组既有图像/合成场景、15组理想运动仿真通过 |
| 素材保全 | `data/car/report_assets/far_blue_cube_20261024.tar.gz`，保留原图、初始失败、修订图、板端记录和SHA256清单；该归档作为冻结素材保留 |

下一部分先验证实时连续检测：小车静止，人移动方块，观察位置更新、目标丢失、重新出现和误切换；随后再接小车转向/接近。实时循环、实测更新频率、运动模糊和连续跟踪目前尚未现场验证；毫米估计精度也未实测，不将它作为本部分收尾的既成成果。用户提出的一次连续接近完成精准停车、阶段间无明显停顿，保留为后期逐步优化目标，本次不修改控制策略。

按用户2026-10-24指定流程：用户在约0.5～1m区间换位置，脚本提示“拍照N”后等待约2秒，保存一张K230照片，再提示下一张，共30张。采集期间只拍照，不检测后驱动车体或机械臂。

```bash
# 只生成板端脚本，不连接硬件
./scripts/host tools/diagnostics/capture_car_far.py
# 现场准备好、K230串口空闲后执行；保持提示输出可见
./scripts/host tools/diagnostics/capture_car_far.py --execute
```

脚本复用K230当前已安装版本的CameraSession，只打开一次相机。相机预热完成后才提示拍照1；每次提示后等待期间持续更新帧，约2秒后调用snapshot并保存RGB565来源的1280×960、JPEG95。提示到采集调用的实际时间记录在日志中，不保证传感器曝光时刻恰好相隔2.000秒。终端收到提示有USB轮询延迟，现场应先核对提示可见。

30张先保存到SD卡独立目录，全部拍完后统一下载并校验SHA256，避免每次下载打断摆放节奏。脚本结束尝试恢复原有语音监听；不替换main.py、不安装新固件。失败保留原图及已完成记录，不自动重复拍摄，也不覆盖已有文件。首批30张现已执行完毕并恢复监听，实际摆放等待记录在采集日志中。

下载按原始JPEG逐张传输，可能需要数分钟；新版每约3秒显示当前图片的KB及百分比，每张完成后显示张数、平均速度和估计剩余时间。已启动的旧脚本不会自动加载这项修改，不要为更新进度显示中断正在进行的下载。

原图只来自K230。PC用于保存、算法回放及演示标注，不使用PC摄像头。

## 演示距离

距离定义为：相机标定光心沿桌面法向投影得到的垂足，到方块底面中心的桌面内欧氏距离；不是机械臂Base原点距离，也不是相机到方块的斜距。单位mm，投影到照片上以虚线显示，起点在画外时按画面裁剪并注明。

远处仅有蓝色色块时，底面中心不能精确测得。当前候选标注将色块图像中心投影到桌面上方10mm，再沿桌面法向下移10mm，得到20mm方块的底面中心代理；明确标记Estimated。它不等于色块下边缘与桌面的交点，也不能用作机械臂精定位。以后有通过现有精定位门槛的原始几何中心时，再用该中心求底面中心，保持两种能力区别。

```bash
./scripts/vision tools/analysis/annotate_car_far.py \
  --image data/car/far_capture/实际目录/frame_01.jpg \
  --output data/car/far_annotations
```

输出SVG保留嵌入的原始JPEG，叠加方框、图像中心、蓝色像素面积和距离虚线，另存JSON。PC LAB是近似回放，不代替K230原生检测验证。单张候选不伪装成连续跟踪成功。

如已完成板端保存图回放，可给标注命令加`--native-report data/实际回放目录/result.json`，使用K230原生检测输出；图片必须与报告顺序和文件名一致。重复保存图的连续确认只验证算法状态，不构成真实动态跟踪验证。

2026-10-24首批30张已采集、下载及SHA256核验。初始PC候选有5张选中受蓝光影响的胶带、2张漏检；没有据此剔除照片。收紧远处LAB候选至`[0,100,-10,127,-128,-35]`，粗估前向筛选上界由1200放宽至1500mm，保留边缘可用目标；这不是测得的有效量程，也不修改近处精定位门槛。修订后30张均选中方块，K230原生保存图回放同样30/30，单次检测29～32ms（仅检测，不含采集/保存/传输）。这是同批样本调参结果，泛化能力、动态性能和测距误差尚未验证。语音监听已恢复，原图和标注见本机`data/car/far_review_20261024_141214/`。

## 样本处理与动态定位

### 实时测试命令（小车静止）

```bash
cd /home/xd/Desktop/aic-robot
./scripts/host tools/diagnostics/live_car_tracker.py --execute
```

默认测试120秒，自动打开本机浏览器页面；若没有自动打开，就复制终端的`http://127.0.0.1:端口/`。先退出占用K230的IDE或串口监视器。等终端提示“相机已就绪”、网页出现画面后，按左右移动→远近移动→移出画面几秒→重新放回的顺序操作，先慢后快。绿框为已确认跟踪，橙框为尚在确认，红十字为图像中心；网页显示像素面积、中线偏差、估计平面距离及检测/预览更新率。

网页“结束测试”或Ctrl+C均请求结束并恢复原语音监听；按一次后等待终端打印`RECORD ...`并返回命令行。正常120秒结束也会自动恢复监听。日志、逐帧观测、跟踪状态变化及最后一张带标记的预览保存在`data/car/live_tracking/时间目录/`。可用`--duration 60`改为60秒，`--no-browser`只打印网址。

识别使用当前共享相机的原生RGB565帧、现有色块跟踪器和共享`track_coarse`接口；相机只开一次。USB预览采用已验证的USBDBG二进制JPEG帧缓冲接口，不使用之前慢速逐张下载路径。检测框在K230检测之后绘制，与该画面对应；网页右侧是最近收到的遥测，二者的传输刷新时刻不要求严格同步。检测停更会显示年龄与提示，失去目标不保留旧坐标。

默认100ms为本诊断脚本的最小观测周期，不改整车控制配置，也不承诺10Hz实测帧率。预览传输可能影响实测循环耗时，网页分别显示观测更新率与预览接收率。实时诊断不再逐帧保存JPEG到SD，录像用下面的独立入口。脚本不导入底盘或机械臂控制，不改开机文件；运行时暂时停止原监听，结束后恢复。

首轮实际连续检测记录于`data/car/live_tracking/20261024_151931_079610/`：观测跨度80.631秒、807帧，帧周期99～101ms，单次检测中位数36ms、P95为42ms。用户反馈“基本跟得上，主要在移出或遮挡时丢失”；状态记录包含目标丢失后的重新确认，但没有人工逐帧真值，不能将tracking占比称为识别准确率。退出时原恢复监听失败，补充恢复后已收到voice_ready；现已增加等待旧脚本退出、关闭USB预览及保留完整错误的处理。该次旧脚本**未录下完整视频**，只有日志和最后预览，已据实归档，不能用它还原过去完整画面。

85张历史试拍/标定/远距离照片已与PC逐张SHA256核对，并迁出K230；原图及报告包保留在本机，独立迁移备份入口为`data/backups/k230_storage_cleanup_LATEST.txt`。板端只保留当前运行资源和新录像；`examples/31-OPEN-KWS`仍供语音唤醒使用，不能随示例目录整体删除。

### 演示视频：K230只录原片，电脑后期分析

用户已经完成实时跟踪测试并确认效果，本阶段只制作演示素材，不重复实时能力验收。采用K230硬件H.264编码，保存无音频原始H.264视频流及硬件时间戳；不在录像时检测，也不逐帧保存JPEG。正式演示命令：

```bash
./scripts/host tools/diagnostics/record_car_video.py --execute --duration 60
```

等待“录像已开始”后，先静止两秒，再慢慢左右/远近移动方块，可短暂遮挡或拿出画面再放回。60秒后自动收尾，等待语音恢复、终端返回。脚本只临时占用摄像头，不改开机文件、不发送运动命令。每次创建独立`/sdcard/car_video/时间目录/`，绝不覆盖旧片；原始视频没有框和标签。

录制前检查实际可用空间：60秒需至少约45MiB（含码率余量及8MiB预留），不足时在启动摄像头前退出。已确认SD可写分区约500MiB，不能按整张32GB卡容量判断。

本次采用这条路线的依据：旧版逐帧JPEG保存中位数261ms，检测仍约35ms，整体帧周期从100ms增至311ms。该失败素材已按用户要求删除；保留诊断日志，不进报告素材包。首个MP4封装试片虽有150帧写入记录，电脑却不能解码，已标为不可用于演示；最终保存方式改为直接保留硬件H.264码流及逐帧PTS。3秒短测记录在`data/car/raw_video/20261024_160344_593433/`，板端记录90帧、3027ms、1578943字节，1280×960、不镜像；语音恢复成功。电脑回读已完整解码90帧，输出帧率30.005fps；去掉约1秒预热后导出59帧，已回读检查。标签/虚线布局另用历史方块照片构造的静态测试片验证，该测试片不当成动态演示素材。实测只用于验证录像链路，不重复评价跟踪能力。

正式视频通过读卡器复制：确认脚本结束后将K230完全断电再取卡（有其他供电时只拔USB不算断电），把`car_video/终端打印的时间目录/`整目录复制到电脑，例如`data/car/video_sources/实际时间目录/`，保留`raw.h264`、`timestamps.jsonl`、`metadata.json`、`summary.json`。原片独立保留，不用后期视频覆盖它。

电脑合成命令：

```bash
./scripts/vision tools/analysis/annotate_car_video.py \
  --input data/car/video_sources/实际时间目录/raw.h264 \
  --output data/car/report_assets/blue_cube_demo.mp4
```

后期逐帧使用现有蓝色跟踪器和PC颜色适配层，用原始硬件PTS计算输出帧率，默认裁掉开头约1秒相机预热画面，保留片段内全部解码帧（可用`--trim-start 0`保留开头）；框和数据均来自对应画面，不拼接最近一条实时遥测。绿框跟踪、橙框确认、红十字表示色块图像中心，红圈为底面中心估计，黄色虚线表示桌面上到摄像头垂足的距离投影，垂足在画外时截到画面边缘。随框中文标签显示状态、帧号、中心、蓝色面积、估计距离和PC单帧处理耗时；丢失时清除目标标签。

视频顶部注明`PC OFFLINE ANALYSIS`；后期图像用于演示算法效果，板端实时检测性能沿用已完成的现场测试记录。PC的LAB/RGB处理与原生RGB565并不逐像素一致，视频中的处理耗时不冒充K230耗时。输入必须保持标定对应的1280×960、无镜像；估计距离仍沿用已知桌面模型，不是精确底面测量。

同时输出逐帧JSONL、源文件SHA256、阈值/标定快照和导出参数JSON，便于报告引用。既有输出不会被覆盖。旧`export_car_video.py`只用于历史JPEG序列，不用于新的H.264原片。

接口依据：[CanMV官方Video例程](https://www.kendryte.com/k230_canmv/en/main/example/media/video.html)。

- 明显模糊、曝光失效、手挡住等照片标为不可用，退出检测评估；原始证据仍保留，不静默删除或重拍。
- 画面可用却漏检、错检的照片保留在失败集，用于改进算法，不用“质量差”掩盖识别问题。
- 先检查30张静态样本，再做K230连续检测：小车静止，人移动方块，实时更新框、图像中心和估计位置，检查丢失、跳变及恢复。此阶段不自动追车。
- “动态检测/跟踪”和“可靠的实时毫米定位”是不同能力。先实现前者，待实拍验证尺度与桌面模型后评估后者；单凭30张静态照片不能证明动态性能。
