WHU-SAS/aic-robot/docs/guides/arm/BASELINE.md

# 当前舵机基线

以配置文件为准，参数调整由用户决定。当前值如下：

| 舵机 | P | I | D | 积分限幅 | 最小启动力 | 死区26/27 | 速度/加速度 |
| --- | --- | --- | --- | --- | --- | --- | --- |
| 1 | 24 | 0 | 100 | 0 | 16 | 1/1 | 150/5 |
| 2 | 48 | 24 | 160 | 48 | 12 | 1/1 | 600/20 |
| 3 | 40 | 12 | 140 | 24 | 4 | 2/3 | 600/20 |
| 4 | 20 | 3 | 60 | 16 | 16 | 1/1 | 600/20 |
| 5 | 24 | 0 | 60 | 0 | 16 | 1/1 | 150/5 |
| 6 | 8 | 0 | 60 | 0 | 16 | 1/1 | 150/5 |

完整包默认采用 `pick_wrist_rotation.json`（5号方向联动、准备位发送后退出）；按2026-10-31用户最新要求，取消−5mm补偿，当前经验补偿为0mm。用法见[完整任务](../robot-task.md)。

以 `configs/arm/user_selected_pid_demo_baseline.json` 和 `motion_defaults.json` 为准。PC入口可核对已保存参数；独立语音入口沿用舵机当前值，不读写PID。正常动作与另行回中立使用相同运动配置；抓取结束不自动回中立。

正式抓取内外参由 `configs/vision/trials/model_alignment_20261030.json` 指定，第0版使用 `blue_cube.json`；说明见[视觉模块](../vision.md)。配置中的来源路径/哈希是历史记录，不是当前代码或加载位置。
