WHU-SAS/aic-robot/docs/guides/arm/PC_PICK_VALIDATION.md

# 抓取验证：K230识别，PC调度

在仓库根目录运行；K230和舵机接通，CanMV IDE停止并断开。沿用当前K230 UART1到URT-2的机械臂接线，无需连接URT-2的电脑USB。

```bash
cd /home/xd/Desktop/aic-robot
./scripts/pick-pc --execute --hands-free
```

实机运行由K230重新拍照、识别并回传定位结果，PC完成逆解和阶段调度，不回传原图后在PC识图。可移动方块后重复同一命令。`--hands-free`表示执行时已经放手；省略它，则先锁定当前位置，再等待输入“已放手”。

## 当前默认：修正装配模型

使用`models/genkiarm/genkiarm_corrected.urdf`及配套`model_alignment_20261030`外参，25°开口，方块对齐张开时两指末端中点，经验补偿0mm。此PC默认入口保持5号原角度作对照；用户认可的本阶段旋转版本已成为完整任务默认，全工作区实物精度和整车成功率尚未量化。

`--pick-config configs/arm/pick_model_check.json`保留为相同参数的兼容入口。模型、编码映射和外参通过哈希配对，不能单独替换。

首次安装或源码更新后预装当前识别包（不更改开机入口）：

```bash
./scripts/host tools/deploy/k230_pick.py --install
```

正常重复测试无需重装。整车使用[完整任务入口](../robot-task.md)。

## 执行顺序

1. K230使用所选配置的配套板包，以RGB565→JPEG95→BGR路径识别20mm蓝色方块，并用配套内外参得到Base坐标；USB只回传本轮定位结果与证据路径。缺包、版本不匹配或识别失败时不发送动作。
2. 读取六轴位置、核对保存的参数和限位，计算完整四阶段IK；识别或规划失败时不发送移动及扭矩指令。
3. 未开启扭矩时先设置当前位置目标，再开启保持；不写PID或EEPROM。
4. 以张开25°时的两指末端中点对准方块；悬停六轴同轮均在目标±30计数后下探，先发4号、200 ms后发其余五轴；下探六轴同轮均在±10计数后闭合，6号连续5次位置处于同一±1计数带后，取最后读数计算Δ＝实际停位−本轮闭合目标：Δ＜30判未夹住，Δ≥30判成功，再照常抬升。复用板端动作函数，PC收到阶段完成结果才发送下一段。
5. 两种判定均完成现有抬升流程，结束保留姿态和扭矩；结果记录为`grasp_confirmed`和`grip_confirmation`，未独立视觉验证；不自动放置、回位或卸力。

| 项目 | 本次值 |
| --- | --- |
| 夹爪张开 | 25°，2332计数 |
| 横向对齐参考 | 张开25°时两指末端中点；经验补偿0mm |
| 悬停 / 下探 / 抬升 | 最低指尖模型高度80 / 15 / 80mm |
| 额外夹紧 | 20计数 |
| 额外向前伸展 | **0mm**，不沿用第0版的10mm补偿 |
| 1、5、6号速度 / 加速度 | 150 / 5 |
| 2、3、4号速度 / 加速度 | 600 / 20 |
| 阶段推进 | 悬停±30、下探±10计数；闭合连续5次±1计数；抬升发送后等1秒 |

桌面Base-Z高度按新标定平面在目标XY处计算，未沿用旧桌面常量。高度和夹持中心仍是模型预测，实物误差由本轮验证。当前夹住判定为上述6号停位差阈值；`complete`只表示动作流程完成，判定不增加采样、等待或重抓。

Ctrl+C会停止当前采样脚本和后续阶段，已经发送的舵机目标仍可能继续执行；保持扭矩，不发送反向恢复动作。

## 单独定位、规划与人工偏移

```bash
./scripts/pick-pc --detect-only   # K230新拍照、定位，不访问舵机
./scripts/pick-pc                 # 新拍照、读编码、规划，不开扭矩或移动
./scripts/pick-pc --image /绝对路径/frame.jpg # 仅此显式离线回放使用PC识图，不连接硬件
```

旧模型的45mm经验偏移已取消；原图和历史版本仍保留。

另可自行指定Base坐标偏移，单位mm；默认三项均为0。例如将目标沿Base-X增加3mm：

```bash
./scripts/pick-pc --execute --hands-free --offset-x-mm 3
```

另有`--offset-y-mm`和`--offset-z-mm`；Z偏移作用于三个模型指尖高度。偏移只作用于本次规划，不修改原始视觉坐标、外参或PID，不自动学习补偿。

## 配置和日志

- 动作：`configs/arm/pick_validation_pc.json`。
- 视觉和桌面平面：`configs/vision/trials/model_alignment_20261030.json`；外参位于同目录配对文件，与内参哈希核对。
- PID和速度：继续读取`configs/arm/user_selected_pid_demo_baseline.json`及`motion_defaults.json`。
- 每轮PC日志：`data/logs/pick_pc_时间/`，包含视觉解、板包/标定上下文、K230原始日志及证据路径、四阶段目标与理论FK、悬停/下探到位采样和耗时。闭合与抬升不额外读取六轴反馈，不把发送目标当作实际到位位置。
- 实机原图和当轮配置保存在K230的`/sdcard/aic/vision/evidence/`，成功与失败均保留；正常测试不传原图，需复查时再按PC日志中的证据路径导出。

当前PC对照与整车使用同一修正模型及配套标定，第0版演示配置独立保留。

## 本阶段5号旋转基线

```bash
./scripts/pick-pc --pick-config configs/arm/pick_wrist_rotation.json --execute --hands-free
```

使用同一K230识图结果中的已确认侧面方向，让夹爪开合方向对齐方块的一对侧面；1～4号同时重新解算，保持张开中点、25°开口及80/15/80mm最低指尖高度。两对等价夹持面先按相对起点所需的最小5号转角排序；先在较少旋转的那对面内依次尝试0～45°倾角、优先接近竖直，全部不可达才尝试另一对。悬停／抬升与下探可选择不同倾角，5号各阶段保持同一目标。旋转方案下探时，张开和闭合两种姿态的每根指爪最低模型高度均需在0～20mm。只见顶面或有限候选未找到完整姿态时，保持原5号角度并沿用原抓取，不改目标补偿。PID、速度和阶段条件不变。

日志`wrist_alignment`记录夹持面尝试顺序、所选侧面、5号目标与相对起点转角及回退原因。该旋转版本已获用户认可并成为[完整任务](../robot-task.md)默认；本PC入口仍需显式选择，省略配置则运行固定5号对照。模型核验最终姿态，不代表全工作区运动扫掠或整车成功率已经验收。
