WHU-SAS/aic-robot/hardware/car/J-Link_OB调试器_元件面及连接线.jpg

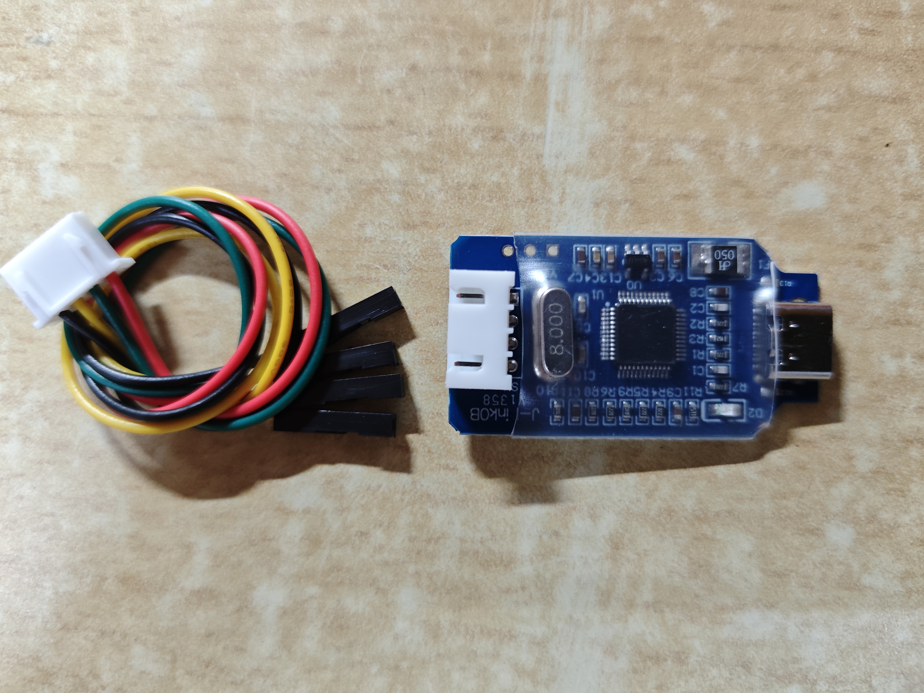
hardware/car/J-Link_OB调试器_元件面及连接线.jpg
