WHU-SAS/aic-robot/hardware/car/J-Link_OB调试器_背面引脚标识.jpg

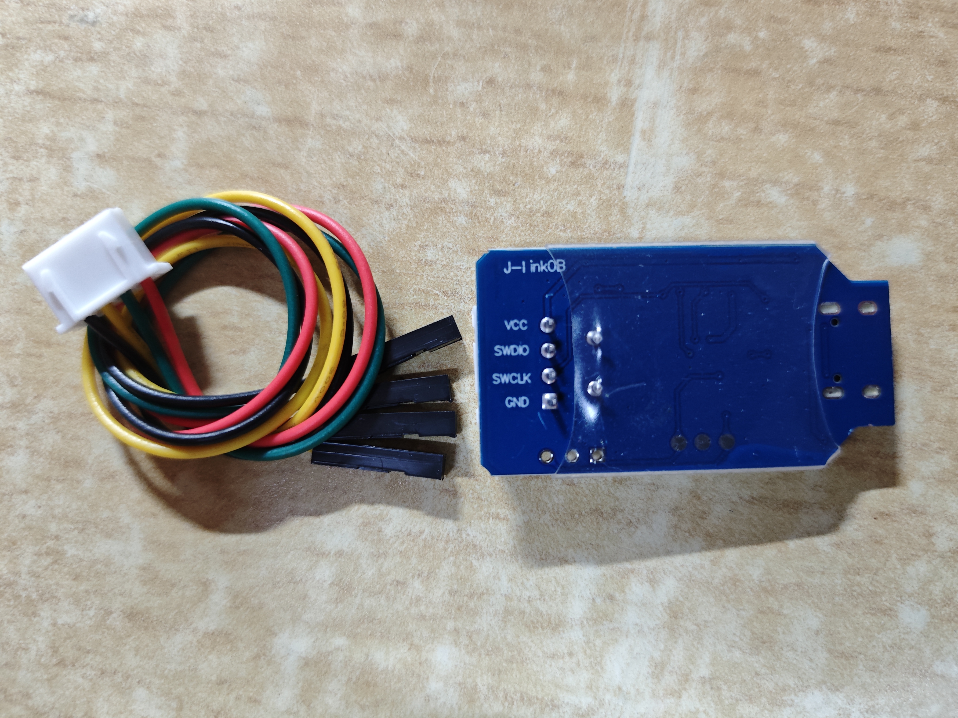
hardware/car/J-Link_OB调试器_背面引脚标识.jpg
