WHU-SAS/aic-robot/hardware/car/野火fireDAP调试器_接口标识.jpg

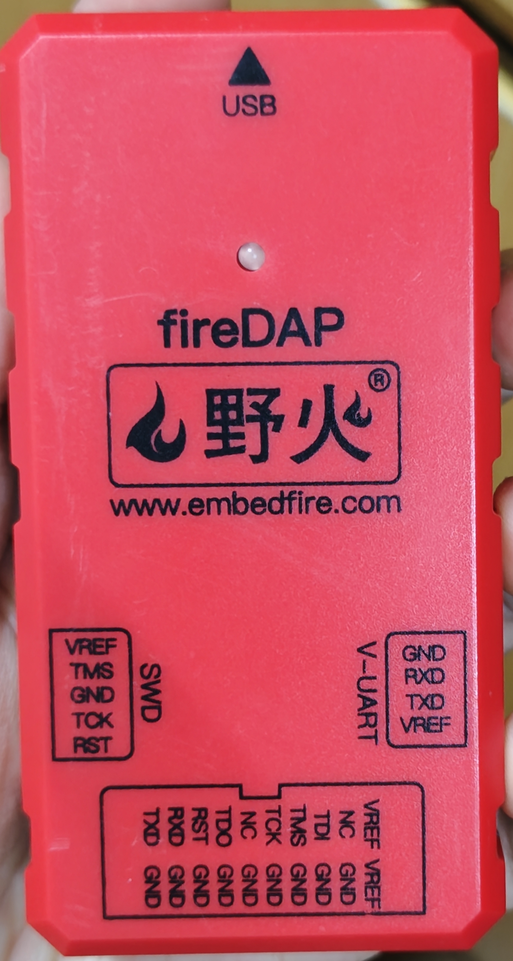
hardware/car/野火fireDAP调试器_接口标识.jpg
