WHU-SAS/aic-robot/device/k230/robot/tracking.py

"""Cooperative persistent task. Callbacks own hardware; no startup motion.

Moving fine results take over distance control before the next coarse frame.
Static verification and arm dispatch still require current observations.
A fine job owns one original image, epoch and capture time throughout.
Scheduling budgets are soft: native CV, IK and UART calls may still block.
"""
try:
    from ..car.blue_tracker import age_ms
    from ..car.target_memory import TargetMemory
    from ..car.tracking_drive import DriveController
    from ..car.near_runtime import count_delta
    from ..vision.candidate_association import associate_fine_candidate
    from .task import handoff_observation
except ImportError:
    from blue_tracker import age_ms
    from target_memory import TargetMemory
    from tracking_drive import DriveController
    from near_runtime import count_delta
    from candidate_association import associate_fine_candidate
    from robot_task import handoff_observation


class ReobserveRequired(ValueError):
    """The validated target has no usable arm plan from this viewpoint."""


class TrackingTask:
    def __init__(self, capture, track, link, projection, config, clock_ms,
                 begin_arm, moving_factory, static_factory, evidence=None,
                 emit=None, reset_tracker=None):
        self.capture, self.track, self.link = capture, track, link
        self.config, self.clock, self.begin_arm = config, clock_ms, begin_arm
        self.factories = {'moving': moving_factory, 'static': static_factory}
        self.evidence = evidence if evidence is not None else []
        self.emit = emit or (lambda event, details: None)
        self.reset_tracker = reset_tracker or (lambda: None)
        self.arm_context = None
        self.memory, self.drive = TargetMemory(projection, config), DriveController(projection, config)
        timing = config.get('tracking_task', {})
        self.loss_confirmation_frames = timing.get('loss_confirmation_frames',
            config['tracking'].get('confirmation_frames', 3))
        self.period = timing.get('period_ms', 100)
        self.stationary_period = timing.get('stationary_period_ms', 250)
        self.stationary_status_period = timing.get('stationary_status_period_ms', 500)
        self.motion_refresh = timing.get('motion_refresh_ms', 250)
        self._motion_sent_at = self._motion_speeds = None
        self._bounded_follow = False
        self._bounded_context = None
        synced_at = self.clock()
        self.state = self.link.sync()
        self.state['_k230_sent_ms'], self.state['_k230_received_ms'] = synced_at, self.clock()
        self._last_motor_reply = self.state['_k230_received_ms']
        self.coarse = self.target = self.decision = None
        self.arm = self.job = self.complete = None
        self.planning = None
        self.last_parking = None
        self._parking_version = None
        self._last_capture = self._frame_motor = None
        self._memory_odom_capture = None
        self._fine_observation_reserve_ms = 0
        self._fresh_before_arm = False
        self._force_observe = False
        self._arm_motor_reference = None
        self._recovery_seen = False
        self._missing = 0
        self.fault = None
        self.status = 'running'
        self.timeline = []
        self._last_drive_event = self._last_target_event = None
        self.metrics = dict(observations=0, max_observation_gap_ms=0, max_step_ms=0,
            fine_started=0, fine_cancelled=0, arm_plans=0, arm_attempts=0, recoveries=0,
            planning_steps=0, plans_cancelled=0, max_planning_step_ms=0,
            target_changes=0, obsolete_frames_released=0, status_queries=0,
            commands_coalesced=0, first_motion_request=None)
        self.metrics['fine_observation_jobs'] = []
        self.metrics['fine_observation_totals'] = dict(fine_compute_ms=0,
            observation_ms=0,observation_count=0,observation_overruns=0)

    def _record(self, event, details):
        # Keep transitions in RAM during motion. They join the existing final
        # run record; no per-frame SD writes or JPEG copies are introduced.
        self.timeline.append(dict(at_ms=self.clock(), event=event, details=details))
        self.timeline[:] = self.timeline[-64:]
        self.emit(event, details)

    def _command(self, command):
        sent = self.clock()
        parts = command.split(',')
        name, speeds = parts[0], tuple(parts[1:])
        bounded = name in ('FOLLOW','SPEED') and len(parts)==4
        context = ((self.memory.version,(self.drive._fine_request or {}).get('request_id'))
                   if bounded else None)
        if (self.state.get('run') and self._motion_sent_at is not None and
                0 <= age_ms(sent, self._motion_sent_at) < self.motion_refresh and
                (name == 'HB' or name == 'SPEED' and speeds == self._motion_speeds and
                 context == self._bounded_context)):
            # STATUS never renews the MCU lease. Keep the original real reply
            # and timestamps; only an unchanged command can wait for refresh.
            self.metrics['commands_coalesced'] += 1
            return self.state
        was_bounded = self._bounded_follow
        owned_follow = (self.drive._active_action=='follow' and
                        not self.drive._searching and not self.drive._search_inspecting)
        if was_bounded and owned_follow and name=='SPEED' and not bounded:
            # A zero-mean/unknown-range update can race the old endpoint. Keep
            # the real rejected ACK, then read the normal completed state.
            # No exception/old link.last value substitutes for this response.
            state = self.link.request(command)
            if (state.get('result')==3 and not state.get('run') and
                    state.get('reason')==6 and state.get('command')=='SPEED' and
                    state.get('seq')==self.link.sequence):
                rejected = dict(state,_k230_sent_ms=sent,_k230_received_ms=self.clock())
                self._record('tracking_bound_update_rejected_after_completion',dict(
                    command=command,rejected_reply=rejected))
                current = self._command('STATUS')
                if current.get('run') or current.get('reason')!=6:
                    raise RuntimeError('Completed bound changed before STATUS: '+str(current))
                return current
            if state.get('result')!=0:
                raise RuntimeError('Unexpected command result: '+str(state))
        else:
            state = self.link.expect(command)
        if name in ('FOLLOW', 'SPEED', 'HB', 'ARC'):
            self._motion_sent_at = sent
            if name != 'HB':
                self._motion_speeds = speeds if name in ('FOLLOW', 'SPEED') else None
        elif name == 'STOP':
            self._motion_sent_at = self._motion_speeds = None
        if name in ('FOLLOW','SPEED'):
            self._bounded_follow = bounded and bool(state.get('run'))
            self._bounded_context = context if self._bounded_follow else None
        elif name == 'STOP' or not state.get('run'):
            self._bounded_follow = False
            self._bounded_context = None
        if (self.metrics['first_motion_request'] is None and
                command.split(',')[0] in ('FOLLOW', 'SPEED', 'ARC') and
                any(value != '0' for value in command.split(',')[1:])):
            self.metrics['first_motion_request'] = dict(command=command, sent_at_ms=sent,
                reply_at_ms=self.clock())
        state['_k230_sent_ms'], state['_k230_received_ms'] = sent, self.clock()
        self.state = state
        self._last_motor_reply = state['_k230_received_ms']
        if command == 'STATUS':
            self.metrics['status_queries'] += 1
            # The first control decision must still see an unowned running
            # motor as initially busy. Thereafter latch every real sample,
            # including excursions between camera frames; Memory stays frame-owned.
        if (self.drive._motor is not None and (name == 'STATUS' or
                self.job is not None and self.job['purpose'] == 'moving')):
            self.drive._observe_motor(state, self._last_motor_reply)
        if ((was_bounded or bounded) and owned_follow and not state.get('run') and
                state.get('reason')==6):
            self.drive.bounded_follow_completed(state,self._last_motor_reply)
            if self.job is None and self.complete is None:
                # The endpoint may finish before its first JPEG is allocated.
                # The just-captured moving frame cannot become a static query.
                self.drive.restart_observation()
            self.last_parking = None
            self._force_observe = True
            self.decision = dict(phase='settling',status='mcu_distance_complete',command=None)
            self._record('tracking_mcu_distance_stop',dict(command=command,
                target_version=self.memory.version,motor_state=dict(state)))
        return state

    def _moving_observation(self):
        return (self.state.get('run') or
                (self.job is not None and self.job['purpose'] == 'moving') or
                (self.complete is not None and self.complete['purpose'] == 'moving'))

    def _controlled_correction(self, capture_ms):
        """Near static-fine cycle, plus its ARC's unobserved stop boundary."""
        if (self.fault is not None or self.arm is not None or self.planning is not None or
                type(capture_ms) is not int):
            return False
        if self.drive.phase == 'following' and self.drive.anchor is None:
            return False
        if (self.drive.phase == 'fine_static' or
                (self.job or {}).get('purpose') == 'static' or
                (self.drive._fine_request or {}).get('purpose') == 'static'):
            return True
        last = self.drive._last_precise
        if (last is not None and last[2] == 'static' and self.drive.phase in
                ('following','correcting','settling','fine_static')):
            return True
        if self.drive._active_action == 'arc' and self.drive.phase == 'correcting':
            return True
        ended = self.drive.last_arc_end or {}
        stamp, previous = ended.get('at_ms'), self.memory._last_stamp
        return (ended.get('phase') == 'correcting' and type(stamp) is int and
            type(previous) is int and age_ms(stamp,previous) >= 0 and
            age_ms(capture_ms,stamp) >= 0)

    def _observation_period(self):
        if self._moving_observation() or self.arm is not None:
            return self.period
        if (self.planning is not None or
                (self.job is not None and self.job['purpose'] == 'static') or
                (self.complete is not None and self.complete['purpose'] == 'static')):
            return self.stationary_period
        return self.period

    def _status_due(self, at_observation=False):
        # Moving feedback and initial stop confirmation keep their original
        # cadence. Once stopped, STATUS has its own slower deadline, independent
        # of how often the camera observes; reusing a reply never renews its age.
        if self.job is not None and self.job['purpose'] == 'static':
            return age_ms(self.clock(), self._last_motor_reply) >= self.stationary_status_period
        if self._moving_observation():
            return at_observation
        return ((at_observation and self.drive.stopped_at_ms is None) or
                age_ms(self.clock(), self._last_motor_reply) >= self.stationary_status_period)

    def idle_delay_ms(self):
        """Background calculation can use time before the next camera deadline."""
        if self._forward_loss_confirmed():
            return 0
        if self.state.get('run') and ((self.drive._fine_request or {}).get('stopped_for_verification') or
                                     self.drive._motion_hold):
            return 0
        if (self.fault is None and self.arm is None and
                (self.job is not None or self.planning is not None) and
                (self.target or {}).get('movement_state') != 'suspected'):
            return 0
        return 5

    def _fault(self, stage, error):
        reason = '%s: %s' % (stage, error)
        changed=self.fault is None
        if changed:
            self.fault = reason
            self.metrics['fault_state_before_stop'] = dict(self.state)
        else:
            self.metrics['last_secondary_fault'] = reason
        # A lost ACK may leave state.run stale even after the MCU began motion.
        # Stop before logging or generator cleanup, either of which may fail.
        try:
            self._command('STOP')
            if changed:
                self.metrics['fault_stop_reply'] = dict(self.state)
        except Exception as exc:
            if changed:
                self.metrics['fault_stop_error'] = str(exc)
        for cancel in (self._cancel_job,self._cancel_plan):
            try:
                cancel('execution_fault')
            except Exception as exc:
                self.metrics['cleanup_error']=str(exc)
        if changed:
            try:self._record('tracking_fault_wait', {'reason': self.fault, 'task_terminal': False})
            except Exception:pass

    def _save_job(self, reason=None):
        if self.job is None:
            return
        job = self.job
        try:
            item = job['session'].take_evidence('tracking_%d_%s' % (
                job['number'], job['purpose']))
        except Exception as exc:
            self.emit('vision_archive_error', {'error':str(exc)})
            return
        if item:
            item['frame'] = dict(item['frame'], target_version=job['target_version'])
            item['frame']['tracking_purpose'] = job['purpose']
            # Keep the actual input with the image; a derived search ROI cannot
            # reconstruct the original box or which colour candidate seeded it.
            coarse = job['paired_coarse']
            item['frame']['paired_coarse'] = {key: coarse[key] for key in (
                'frame_id', 'capture_timestamp_ms', 'status', 'bbox_px',
                'center_pixel', 'confirmations', 'ground_contact_proxy_Base_mm',
                'visual_evidence', 'visual_candidates') if key in coarse}
            item['frame']['localization_bbox_px'] = job['localization_bbox_px']
            if reason:
                item['frame']['discard_reason'] = reason
            self._release_evidence(job['target_version'], job['purpose'])
            self.evidence.append(item)

    def _release_evidence(self, version, replaced_purpose=None):
        """Keep first/last moving and last static originals across target loss.

        They never grant control authority. Replacing the same purpose still
        bounds RAM to three frames, without SD writes or another JPEG copy.
        """
        moving = [item for item in self.evidence
                  if item['frame'].get('tracking_purpose')=='moving']
        static = [item for item in self.evidence
                  if item['frame'].get('tracking_purpose')=='static']
        keep = moving[:1]+([] if replaced_purpose=='moving' else moving[-1:])
        if replaced_purpose!='static':
            keep += static[-1:]
        retained = [item for item in self.evidence if any(item is old for old in keep)]
        self.metrics['obsolete_frames_released'] += len(self.evidence)-len(retained)
        self.evidence[:] = retained

    def _coarse_audit(self, coarse):
        evidence = coarse.get('visual_evidence') or coarse
        point = evidence.get('ground_contact_proxy_Base_mm')
        return dict(frame_id=coarse.get('frame_id'),
            capture_timestamp_ms=coarse.get('capture_timestamp_ms'),
            bbox_px=evidence.get('bbox_px'),center_pixel=evidence.get('center_pixel'),
            coarse_proxy_X_mm=point[0] if point is not None else None)

    def _cancel_job(self, reason):
        job = self.job
        try:
            if self.job is not None:
                if reason in ('execution_fault', 'task_closed'):
                    self._save_job(reason)
                cancel = getattr(self.job['session'], 'cancel', None)
                if cancel:cancel()
                self.metrics['fine_cancelled'] += 1
        finally:
            if job is not None:
                job['_end_reason'] = reason
                if not job.get('_observation_active'):
                    self._finish_fine_accounting(job, reason)
            self.job = self.complete = None
            self.drive.cancel_fine()

    def _finish_fine_accounting(self, job, reason):
        if job.get('_accounted'):
            return
        if job['_observation_cost_ms']:
            self._charge_fine_observation(job,0,complete=True)
        job['_accounted'] = True
        summary = dict(
            number=job['number'], purpose=job['purpose'], reason=reason,
            fine_compute_ms=job['fine_compute_ms'],
            observation_ms=job['observation_ms'],
            observation_count=job['observation_count'],
            observation_max_ms=job['observation_max_ms'],
            observation_reserve_ms=job['observation_reserve_ms'],
            observation_overruns=job['observation_overruns'],
            observation_fraction=job['observation_fraction'],
            observation_actual_fraction=(job['observation_ms']/job['fine_compute_ms']
                if job['fine_compute_ms'] else None))
        self.metrics['fine_observation_jobs'].append(summary)
        self.metrics['fine_observation_jobs'][:] = self.metrics['fine_observation_jobs'][-64:]
        for key in self.metrics['fine_observation_totals']:
            self.metrics['fine_observation_totals'][key] += summary[key]

    def _charge_fine_observation(self, job, elapsed, complete=False):
        job['observation_ms'] += elapsed
        job['_observation_cost_ms'] += elapsed
        if complete:
            cost = job['_observation_cost_ms']
            job['observation_max_ms'] = max(job['observation_max_ms'], cost)
            if cost > job['observation_reserve_ms']:
                job['observation_overruns'] += 1
            job['observation_reserve_ms'] = max(job['observation_reserve_ms'], cost)
            self._fine_observation_reserve_ms = max(self._fine_observation_reserve_ms,cost)
            job['_observation_cost_ms'] = 0

    def _light_fine_observation(self, job):
        """Spend only earned fine-compute credit, after an owned-image yield.

        This is a soft budget: a native capture/track call can exceed reserve.
        No extra UART, driving decision, arm work or archive is performed here.
        """
        if (job.get('_light_pending') is not None or
                job['observation_fraction'] <= 0 or
                job['observation_ms']+job['observation_reserve_ms'] >
                job['observation_fraction']*job['fine_compute_ms']):
            return
        reserve = job['observation_reserve_ms']
        if (job['purpose']=='moving' and self.state.get('run') and
                self._motion_sent_at is not None and
                age_ms(self.clock(),self._motion_sent_at)+reserve >= self.motion_refresh or
                job['purpose']=='static' and
                age_ms(self.clock(),self._last_motor_reply)+reserve >=
                    self.stationary_status_period):
            # Optional camera work must not push an already due/near-due
            # ORIGINAL feedback cycle behind another native call.
            return True
        started = self.clock()
        job['observation_count'] += 1
        try:
            image, frame = self.capture()
            stamp = frame['capture_timestamp_ms']
            if self._last_capture is not None:
                self.metrics['max_observation_gap_ms'] = max(
                    self.metrics['max_observation_gap_ms'], age_ms(stamp,self._last_capture))
            self._last_capture = stamp
            self.metrics['observations'] += 1
            job['_light_pending'] = self.track(image,frame)
        finally:
            self._charge_fine_observation(job, age_ms(self.clock(),started))

    def _resolve_fine_observation(self):
        job = self.job
        coarse = job.get('_light_pending') if job is not None else None
        if coarse is None:
            return
        started = self.clock()
        stamp, previous = coarse['capture_timestamp_ms'], self.memory._last_stamp
        if (age_ms(self.clock(),stamp) > self.config.get('tracking',{}).get('max_age_ms',500) or
                previous is not None and (age_ms(stamp,previous) <= 0 or
                    coarse.get('frame_id') == self.memory._last_frame)):
            # The real feedback may arrive after a long native fine call.
            # Expiry/duplicate input is unknown, never a new disappearance.
            job['_light_pending'] = None
            self._charge_fine_observation(job,age_ms(self.clock(),started),complete=True)
            return
        rows = self.drive.odometry.rows
        # An old HB is not an encoder reading at this exposure. Wait for the
        # next ORIGINAL heartbeat/status to bracket it; never query for a light
        # frame. If the solve finishes first, its normal fresh check takes over.
        if (previous is None or not rows or age_ms(previous,rows[0][0]) < 0 or
                age_ms(rows[-1][0],stamp) < 0):
            self._charge_fine_observation(job,age_ms(self.clock(),started))
            return
        job['_observation_active'] = True
        try:
            self.coarse = coarse
            self.target = self.memory.update(coarse,
                self.drive.odometry.since(previous,stamp), motion_state=self.state,
                controlled_correction=self._controlled_correction(stamp))
            self._memory_odom_capture = stamp
            self.drive._memory_odom_capture = stamp
            job['_light_pending'] = None
            if self.target.get('confirmed_moved'):
                self.metrics['target_changes'] += 1
            classified_at = self.clock()
            self._count_visibility(coarse,classified_at)
            bottom_lost = (job['purpose']=='static' and
                (self.drive._bottom_reverse_budget or {}).get('view_recovered') and
                age_ms(classified_at,stamp) <= self.config.get('tracking',{}).get('max_age_ms',500) and
                not self.drive._bottom_full_view(coarse,self.target,classified_at))
            if self.memory.version != job['target_version'] or bottom_lost:
                continued = (job['purpose']=='moving' and
                    self._continue_visible_tracking('fine_observation_changed'))
                reason = 'bottom_view_lost' if bottom_lost else 'fine_observation_changed'
                self._cancel_job(reason)
                self.last_parking = None
                if not continued:
                    self.drive.restart_observation(discard_reference=True)
                self._force_observe = True
                self._record('tracking_fine_observation_changed',dict(
                    frame_id=coarse['frame_id'],purpose=job['purpose'],
                    continued_follow=continued,reason=reason))
        finally:
            self._charge_fine_observation(job, age_ms(self.clock(),started), complete=True)
            job['_observation_active'] = False
            if self.job is not job:
                self._finish_fine_accounting(job,job.get('_end_reason','cancelled'))

    def _wheel_delta(self, previous, current):
        if previous is None:
            return ()
        scale = self.config['mm_per_count']
        return [(count_delta(previous['encoder_a'], current['encoder_a'])*scale,
                 -count_delta(previous['encoder_b'], current['encoder_b'])*scale)]

    def _check_chassis_reference(self):
        if ((self.arm is None and self.planning is None) or
                self._arm_motor_reference is None):
            return
        deltas = {key:count_delta(self._arm_motor_reference[key], self.state[key])*
                  self.config['mm_per_count'] for key in ('encoder_a', 'encoder_b')}
        arm_state = self.arm.snapshot() if self.arm is not None else None
        tolerance = (self.config.get('tracking_task', {}).get('grasp_chassis_tolerance_mm', 1.)
                     if arm_state is not None and arm_state.get('pending_stage') != 'hover' else .1)
        if not self.state.get('run') and max(abs(v) for v in deltas.values()) <= tolerance:
            return
        self.metrics['last_chassis_invalidation'] = dict(
            wheel_displacement_mm=deltas, tolerance_mm=tolerance, run=self.state.get('run'),
            reference={key:self._arm_motor_reference.get(key) for key in
                       ('encoder_a','encoder_b','ms','_k230_received_ms')},
            state={key:self.state.get(key) for key in
                   ('encoder_a','encoder_b','ms','_k230_received_ms')},
            phase=arm_state.get('phase') if arm_state is not None else 'planning')
        self._record('tracking_chassis_invalidated',self.metrics['last_chassis_invalidation'])
        self.memory.invalidate('chassis_moved_during_grasp')
        self.target = self.memory.snapshot()
        self.last_parking = None
        self._cancel_plan('chassis_moved_during_grasp')
        self.drive.restart_observation()
        if self.state.get('run'):
            self._command('STOP')

    def _cancel_plan(self, reason):
        if self.planning is None:
            return
        plan, self.planning = self.planning, None
        close = getattr(plan['iterator'], 'close', None)
        if close:
            close()
        self.metrics['plans_cancelled'] += 1
        self.emit('tracking_plan_cancelled', {'reason':reason,
            'target_version':plan['target_version']})

    def _advance_plan(self):
        if self.planning is None or self.target.get('movement_state') == 'suspected':
            return
        plan = self.planning
        started = self.clock()
        try:
            event = next(plan['iterator'])
            self.metrics['planning_steps'] += 1
            if event.get('target_version') != plan['target_version']:
                raise ValueError('Planning changed its original target version')
            if event.get('stage') == 'complete':
                engine = event['execution']
                if (event.get('frame_id') != plan['frame_id'] or
                        engine.snapshot()['target_version'] != plan['target_version']):
                    engine.close()
                    raise ValueError('Planning changed its original observation')
                self.arm = engine
                close = getattr(plan['iterator'], 'close', None)
                if close:
                    close()
                self.planning = None
                self._fresh_before_arm = True
                self._record('tracking_plan_ready', dict(target_version=plan['target_version'],
                    frame_id=plan['frame_id'], elapsed_ms=age_ms(self.clock(), plan['started_at_ms'])))
        except ReobserveRequired as exc:
            self._cancel_plan('scene_has_no_arm_plan')
            self.last_parking = None
            self.emit('tracking_reobserve', {'reason':str(exc), 'stage':'arm_plan'})
            self.drive.restart_observation()
            self._force_observe = True
        except Exception as exc:
            self._fault('arm_plan', exc)
        finally:
            self.metrics['max_planning_step_ms'] = max(self.metrics['max_planning_step_ms'],
                age_ms(self.clock(), started))

    def _observe(self, force_status=False):
        image, frame = self.capture()
        now = frame['capture_timestamp_ms']
        if self._last_capture is not None:
            self.metrics['max_observation_gap_ms'] = max(
                self.metrics['max_observation_gap_ms'], age_ms(now, self._last_capture))
        self._last_capture = now
        self.metrics['observations'] += 1
        if self.fault is None and (force_status or self._status_due(at_observation=True)):
            try:
                self._command('STATUS')
            except Exception as exc:
                self._fault('motor_status', exc)
        self.coarse = self.track(image, frame)
        arm_state = self.arm.snapshot() if self.arm is not None else None
        if arm_state is not None and self.arm_context is not None:
            arm_state = self.arm_context(arm_state)
        deltas = (self.drive.odometry.since(self._memory_odom_capture,now)
            if self._memory_odom_capture is not None else
            self._wheel_delta(self._frame_motor,self.state))
        self._check_chassis_reference()
        if self.drive._searching and self.drive.anchor is None:
            # Confirmed loss has ended the old finite approach. Keep its
            # evidence, but let a genuinely new full candidate reacquire;
            # the departed target's old scale is not a new distance grant.
            self.memory.release_precise()
        self.target = self.memory.update(self.coarse, deltas, arm_state,
            motion_state=self.state, controlled_correction=self._controlled_correction(now))
        if self._memory_odom_capture is not None:
            self._memory_odom_capture = now
            self.drive._memory_odom_capture = now
        if self._parking_version != self.memory.version:
            self.last_parking = None
        if self.planning is not None and (
                self.planning['target_version'] != self.memory.version or
                not self.target.get('target_valid') or
                (self.target.get('visible') and self.target.get('associated') and
                 self.target.get('movement_state') != 'suspected' and
                 self.target.get('needs_precise'))):
            self._cancel_plan('observation_changed_during_planning')
            self.last_parking = None
            self.drive.restart_observation()
        self._release_evidence(self.memory.version)
        self._frame_motor = dict(self.state)
        if self.target['confirmed_moved']:
            self.metrics['target_changes'] += 1
        change = (self.memory.version, self.target['event'], self.target['movement_state'])
        if change != self._last_target_event:
            self._last_target_event = change
            self._record('tracking_target', dict(target_version=self.memory.version,
                event=self.target['event'], movement_state=self.target['movement_state'],
                reason=self.target.get('reason'), residual_px=self.target.get('residual_px'),
                bbox_px=self.coarse.get('bbox_px'),
                visual_evidence=self.coarse.get('visual_evidence')))
        if self.job is not None and self.job['target_version'] != self.memory.version:
            self._cancel_job('target_version_changed')
        if self.complete is not None and self.complete['target_version'] != self.memory.version:
            self.complete = None
            self.drive.cancel_fine()
        evidence = self.coarse.get('visual_evidence') or {}
        if (self.target['event'] in ('moved', 'acquired', 'reappeared') and
                self.target['associated'] and evidence.get('associated') is False):
            # Memory has confirmed a unique jump; the next native frame can
            # establish a new color association instead of following old blue.
            self.reset_tracker()
        self._count_visibility(self.coarse,self.clock())
        unsent_hover = self.arm is not None and self.arm.snapshot().get('pending_stage') == 'hover'
        if (self._missing >= self.loss_confirmation_frames and
                (self.planning is not None or unsent_hover)):
            # A brief gap preserves work. When the existing search policy is
            # due, drop only unsent work so its ownership cannot block searching.
            self._cancel_plan('target_unseen_before_hover')
            if unsent_hover:
                self.arm.close()
                self.arm = None
            self._arm_motor_reference = self.last_parking = None
            self.drive.restart_observation()
        self._fresh_before_arm = False
        return image, frame

    def _count_visibility(self, coarse, now):
        stamp=(coarse or {}).get('capture_timestamp_ms')
        if type(stamp) is not int or not 0<=age_ms(now,stamp)<=self.config['tracking']['max_age_ms']:
            return
        present=self.drive._visual_presence(coarse,now)
        # A forward approach can still see a complete new measured region
        # before identity catches up. This exception grants no route/arm
        # authority, and does not replace stopped identity-loss rules.
        if self._owned_forward():
            cue=(self.target or {}).get('navigation_cue')
            evidence=(coarse or {}).get('visual_evidence') or {}
            tracking_update=((self.target or {}).get('tracking_update') and
                isinstance(cue,dict) and cue.get('bbox_px')==evidence.get('bbox_px') and
                cue.get('center_pixel')==evidence.get('center_pixel') and
                cue.get('timestamp_ms',stamp)==stamp)
            present=present or tracking_update or self.drive._measurable_presence(coarse,now)
        elif ((self.drive._bottom_reverse_budget or {}).get('view_recovered') and
                self.drive._bottom_full_view(coarse,self.target,now)):
            present=True
        self._missing=0 if present else self._missing+1

    def _owned_forward(self):
        speeds=self._motion_speeds
        return bool(self.state.get('run') and self.drive._active_action=='follow' and
            not self.drive._searching and not self.drive._search_inspecting and
            self.drive._motion_hold is None and self.arm is None and self.planning is None and
            speeds is not None and sum(float(value) for value in speeds[:2])>0)

    def _forward_loss_confirmed(self):
        return self._missing>=self.loss_confirmation_frames and self._owned_forward()

    def _stop_lost_follow(self):
        if not self._forward_loss_confirmed():return False
        self._cancel_job('target_lost_during_follow')
        self.last_parking=None
        event=dict(self.target or {},loss_confirmed=True,search=True)
        self.decision=self.drive.update(self.coarse,self.state,self.clock(),
            target_version=self.memory.version,target_event=event)
        self.memory.release_precise()
        self.target=self.memory.snapshot()
        self._record('tracking_loss_confirmed',dict(
            observations=self._missing,frame_id=(self.coarse or {}).get('frame_id'),
            command=self.decision.get('command')))
        if self.decision.get('command'):
            self._command(self.decision['command'])
        return True

    def _start_job(self, purpose, image, frame):
        if purpose=='moving' and self.state.get('run'):
            before_jpeg = self.drive.pending_fine_motion(self.state,self.clock())
            if before_jpeg is not None and before_jpeg['command']=='STOP':
                # UART/dispatch time since Drive's decision can consume the
                # last travel. Stop before constructing or compressing a job;
                # this moving frame cannot be the stopped verification image.
                self.decision = before_jpeg
                try:
                    self._command('STOP')
                    self.drive.cancel_fine()
                    self.drive.restart_observation()
                    self.last_parking = None
                    self._force_observe = True
                    self._record('tracking_pre_jpeg_stop',dict(
                        frame_id=frame['frame_id'],plan=before_jpeg.get('plan'),
                        motor_state=dict(self.state)))
                except Exception as exc:
                    self._fault('fine_motor_feedback',exc)
                return
            context = (self.memory.version,(self.drive._fine_request or {}).get('request_id'))
            if (before_jpeg is not None and len(before_jpeg['command'].split(','))==4 and
                    (not self._bounded_follow or self._bounded_context!=context)):
                # Every moving image starts only after the MCU has ACKed its
                # own endpoint, even if a previous plain speed was coalesced.
                try:
                    self._command(before_jpeg['command'])
                except Exception as exc:
                    self._fault('fine_motor_feedback',exc)
                    return
                if not self.state.get('run'):
                    return
        epoch = self.memory._epoch_start_stamp
        if epoch is not None and age_ms(frame['capture_timestamp_ms'], epoch) <= 0:
            # A version-changing frame cannot pass the original fine timestamp
            # rule. Take a new frame first instead of computing a doomed pose.
            self._force_observe = True
            return
        fine_config = dict(self.config)
        fine_config['near_parking'] = dict(self.config['near_parking'],
            fine_budget_ms=self.config.get('tracking_task', {}).get('fine_budget_ms', 20))
        session = self.factories[purpose](fine_config, self.clock)
        self.metrics['fine_started'] += 1
        source=self.coarse.get('visual_evidence') or {}
        bbox=(list(source['bbox_px']) if source.get('associated') is True and
              source.get('ambiguous') is False and source.get('bbox_px') else None)
        self.job = {'session': session, 'purpose': purpose,
            'target_version': self.memory.version, 'paired_coarse': dict(self.coarse),
            'localization_bbox_px':bbox,
            'request_id': self.decision.get('fine_request_id'),
            'number': self.metrics['fine_started'],
            'fine_compute_ms':0,'observation_ms':0,'observation_count':0,
            'observation_max_ms':0,'observation_overruns':0,
            'observation_fraction':max(0.,self.config.get('tracking_task',{}).get(
                'fine_observation_overhead_fraction',0)),
            'observation_reserve_ms':max(self._fine_observation_reserve_ms,0,
                self.config.get('tracking_task',{}).get('fine_observation_reserve_ms',60)),
            '_observation_cost_ms':0,'_light_pending':None}
        self._record('tracking_fine_started', dict(purpose=purpose,
            frame_id=frame['frame_id'], target_version=self.memory.version,
            capture_timestamp_ms=frame['capture_timestamp_ms']))
        job, started = self.job, self.clock()
        error = None
        try:
            session.start(image, frame, bbox)
        except Exception as exc:
            error = exc
        finally:
            job['fine_compute_ms'] += age_ms(self.clock(),started)
        if error is not None:
            self._fault('fine_start',error)
        else:
            self._pending_fine_stop()

    def _pending_fine_stop(self):
        if (self.job is None or self.job['purpose']!='moving' or
                not self.state.get('run')):
            return False
        decision = self.drive.pending_fine_motion(self.state,self.clock())
        if decision is not None and decision['command']=='STOP':
            self.decision = decision
            return True
        return False

    def _advance_job(self):
        if self.job is None:
            return
        job = self.job
        started, error = self.clock(), None
        try:
            job['session'].advance()
        except Exception as exc:
            error = exc
        finally:
            job['fine_compute_ms'] += age_ms(self.clock(),started)
        if error is not None:
            self._fault('fine_compute',error)
            return
        exhausted = self._pending_fine_stop()
        if not job['session'].phase:
            # A pending light frame never substitutes for the final fresh
            # coarse+STATUS handoff. Unbracketed feedback remains unknown.
            job['_light_pending'] = None
            self._finish_fine_accounting(job,'completed')
            observation = job['session'].latest
            if observation.get('status') == 'localized' or observation.get('range_candidate'):
                association = self._match_fine(job['paired_coarse'], observation)
                # Retain the raw visual solve with its association audit. Only
                # the filtered capability below may reach driving or Memory.
                job['session'].latest = dict(observation, target_association=association)
                job['session'].latest_ready_ms = self.clock()
                observation = job['session'].latest
                if association['status'] != 'matched':
                    observation = dict(observation, status='no_complete_face',
                        reason='Fine result is not associated with the selected target')
                    observation.pop('cube_center_Base_mm', None)
                    observation.pop('range_candidate', None)
            self.complete = dict(job, observation=observation,
                result_ready_ms=job['session'].latest_ready_ms)
            self.complete.pop('session')
            if (job['purpose'] == 'moving' and
                    (observation.get('status') == 'localized' or observation.get('range_candidate'))):
                self._handoff_moving_precise()
            self._record('tracking_fine_completed', dict(purpose=job['purpose'],
                frame_id=job['session'].latest.get('frame_id'),
                cube_center_Base_mm=job['session'].latest.get('cube_center_Base_mm'),
                raw_center_Base_mm=(job['session'].latest.get('range_candidate') or {}).get('raw_center_Base_mm'),
                evidence_type=(job['session'].latest.get('quality') or {}).get('evidence_type'),
                boundary_method=(job['session'].latest.get('quality') or {}).get('boundary_method'),
                vision_path=(job['session'].latest.get('quality') or {}).get('vision_path'),
                reprojection_rms_px=(job['session'].latest.get('quality') or {}).get('reprojection_rms_px'),
                status=observation.get('status'),
                target_association=(observation.get('target_association') or {}).get('status'),
                reason=observation.get('reason'),search=observation.get('search'),
                localization_timing=getattr(job['session'], 'timing', None),
                request_id=job['request_id'],
                elapsed_ms=age_ms(job['session'].latest_ready_ms,
                    job['session'].latest.get('capture_timestamp_ms', job['session'].latest_ready_ms))))
            self._save_job()
            self.job = None
        else:
            if exhausted:
                return True
            return self._light_fine_observation(job)

    def _handoff_moving_precise(self):
        """Use the completed original distance before taking another image."""
        done = self.complete
        if done is None or done['purpose'] != 'moving':
            return
        timing = dict(frame_id=done['observation'].get('frame_id'),
            capture_timestamp_ms=done['observation'].get('capture_timestamp_ms'),
            result_ready_ms=done['result_ready_ms'], target_version=done['target_version'],
            capture_motor_state=dict((self.drive._fine_request or {}).get('motor') or {}))
        try:
            timing['status_sent_ms'] = self.clock()
            self._command('STATUS')
            timing['status_received_ms'] = self.clock()
            timing['handoff_motor_state'] = dict(self.state)
            decision = self.drive.consume_moving_precise(
                done, self.state, self.clock(), self.memory.version)
            if decision is None:
                self.drive.cancel_fine()
                self.drive.restart_observation()
                decision = dict(phase='settling',status='fine_handoff_unavailable',
                    command='STOP' if self.state.get('run') else None,precise_consumed=False)
            if (decision.get('precise_consumed') and not decision.get('moving_fine_stopped') and
                    self.drive.anchor is not None):
                stamp = done['observation']['capture_timestamp_ms']
                current_stamp = (self.coarse or {}).get('capture_timestamp_ms',stamp)
                # Memory's image reference ends at its last observed frame;
                # Drive independently propagates the distance to STATUS-now.
                bound = self.memory.bind_precise(done['observation'],done['paired_coarse'],
                    done['target_version'],self.drive.odometry.since(stamp,current_stamp))
                if not bound:
                    self.drive.restart_observation()
                    decision.update(phase='settling',status='fine_binding_rejected',
                        command='STOP' if self.state.get('run') else None)
                self.target = self.memory.snapshot()
                timing['memory_bound'] = bound
            self.decision = decision
            command = decision.get('command')
            timing.update(status=decision.get('status'),command=command,
                precise_consumed=decision.get('precise_consumed'),
                moving_fine_stopped=bool(decision.get('moving_fine_stopped')),
                plan=decision.get('plan'))
            if command:
                timing['command_sent_ms'] = self.clock()
                self._command(command)
                timing['command_reply_ms'] = self.clock()
            self.complete = None
            self._force_observe = True
            if 'first_moving_handoff' not in self.metrics:
                self.metrics['first_moving_handoff'] = timing
            self.metrics['last_moving_handoff'] = timing
            self._record('tracking_moving_handoff',timing)
        except Exception as exc:
            self._fault('fine_handoff',exc)

    def _match_fine(self, coarse, observation):
        return associate_fine_candidate(observation, coarse)

    def _continue_visible_tracking(self, reason, pending_follow=False):
        """Drop stale geometry while an owned approach follows a current cue."""
        if self.drive.anchor is not None and not (self.target or {}).get('confirmed_moved'):
            return False
        if (self.arm is not None or self.planning is not None or
                not self.state.get('run') or not (self.drive._active_action == 'follow' or
                    pending_follow and self.drive._active_action is None) or
                self.drive._motion_hold is not None):
            return False
        target = self.memory.retarget_current(self.coarse, reason)
        if target is None or not self.drive.retarget_following(self.memory.version,
                                                               pending_follow=pending_follow):
            return False
        self.target = target
        self.complete = self.last_parking = None
        self._force_observe = True
        self._release_evidence(self.memory.version)
        return True

    def _vision_paused_for_grip(self, state):
        return bool(state and state.get('status') in ('running','succeeded') and
                    state.get('phase') in ('close','lift','complete'))

    def _arm_target_context(self, before):
        """Snapshot existing revocation inputs, without acquiring new feedback."""
        def fields(source, names):
            source = source or {}
            return {key:source.get(key) for key in names}
        memory = self.memory.snapshot()
        coarse = self.coarse or {}
        motor_keys = ('encoder_a','encoder_b','run','ms','_k230_sent_ms','_k230_received_ms')
        return dict(reason=memory.get('reason'),
            old_target_version=before.get('target_version'),new_target_version=memory.get('version'),
            target_valid=memory.get('target_valid'),phase=before.get('phase'),
            movement_state=memory.get('movement_state'),confirmed_moved=memory.get('confirmed_moved'),
            last_sample=before.get('last_sample'),
            grip_confirmation=fields(before.get('grip_confirmation'),
                ('axis','goal','position','delta_counts','threshold_counts','grasp_confirmed','sample_time_ms')),
            vision_paused_for_grip=self._vision_paused_for_grip(before),
            coarse=dict(frame_id=coarse.get('frame_id'),
                capture_timestamp_ms=coarse.get('capture_timestamp_ms'),
                visual_evidence=fields(coarse.get('visual_evidence'),
                    ('timestamp_ms','visible','associated','ambiguous','candidate_count','reason',
                     'bbox_px','center_pixel','pixels','distance_valid','navigation_confirmed',
                     'cube_shape_compatible','edge_directions'))),
            chassis=dict(reference=fields(self._arm_motor_reference,motor_keys),
                current=fields(self.state,motor_keys),
                last_invalidation=self.metrics.get('last_chassis_invalidation')))

    def _step_arm(self):
        if self.arm is None or self._fresh_before_arm:
            return
        before = self.arm.snapshot()
        vision_paused = self._vision_paused_for_grip(before)
        if before['target_version'] == self.memory.version and before.get('target_valid', True):
            if before.get('pending_stage') == 'hover':
                if (not self.target.get('associated') or not self.target.get('visible') or
                        self.target.get('movement_state') == 'suspected'):
                    # Unknown is a pause, not evidence that the plan moved.
                    # A later confirmed version change still cancels it below.
                    return
            if before.get('pending_stage') == 'hover' and self.target.get('needs_precise'):
                # No servo goal has been sent by this engine. Drop the stale
                # plan without a physical recovery action, then obtain a new
                # static result; unknown vision alone must not open the jaw.
                self.arm.close()
                self.arm = None
                self._arm_motor_reference = None
                self.drive.restart_observation()
                self._force_observe = True
                return
            if (not vision_paused and self.target.get('movement_state') == 'suspected' and
                    (before.get('pending_stage') is not None or before['phase'] == 'descend_lead')):
                return
        dispatching_first = (before.get('pending_stage') == 'hover' and
            before['target_version'] == self.memory.version and before.get('target_valid', True))
        allow_success = vision_paused or self.target.get('movement_state') != 'suspected'
        if before['target_version'] != self.memory.version or not before.get('target_valid', True):
            state = self.arm.step(target_version=self.memory.version, allow_success=allow_success,
                target_context=self._arm_target_context(before) if before.get('status')=='running' else None)
        elif before.get('next_poll_in_ms', 0) <= 0:
            state = self.arm.step(target_version=self.memory.version, allow_success=allow_success)
        else:
            state = before
        dispatch = state.get('last_goal_dispatch') or {}
        if (dispatching_first and dispatch.get('name') == 'hover' and
                dispatch.get('sent_at_ms') is not None):
            self.metrics['arm_attempts'] += 1
            static_frame = (self.last_parking or {}).get('verification_observation', {})
            captured = static_frame.get('capture_timestamp_ms')
            self._record('tracking_first_hover', dict(target_version=self.memory.version,
                static_frame_id=static_frame.get('frame_id'),
                dispatch_seq=dispatch.get('seq'),goal_sent_at_ms=dispatch['sent_at_ms'],
                photo_to_hover_ms=(age_ms(dispatch['sent_at_ms'],captured)
                                   if captured is not None else None)))
        if state['status'] in ('recovering', 'reobserve_ready') and not self._recovery_seen:
            self._recovery_seen = True
            self.metrics['recoveries'] += 1
            self.memory.invalidate(state.get('recovery_reason') or 'arm_recovery')
            self.last_parking = None
            self._release_evidence(self.memory.version)
            self._cancel_job('arm_recovery')
            self.drive.restart_observation()
        if state['status'] == 'fault':
            self._fault('arm_execution', state.get('error'))
        elif state['status'] == 'succeeded':
            self.status = 'succeeded'
        elif state.get('can_reobserve'):
            self.arm.close()
            self.arm = None
            self._arm_motor_reference = None
            self._recovery_seen = False
            self.drive.restart_observation()
            self._force_observe = True

    def _advance_background(self):
        """Spend a short time slice, not one sleep for every cheap yield.

        Hundreds of algebraic progress events should not each cost5ms of idle
        time. Stop at the next observation deadline or the soft work budget.
        """
        if self._forward_loss_confirmed() or self._pending_fine_stop():
            # JPEG/native work has just yielded with no remaining travel.
            # Return to the original command slot before another solve/light.
            return
        started = self.clock()
        budget = self.config.get('tracking_task', {}).get('fine_budget_ms', 20)
        progressed = False
        while self.fault is None and self.arm is None:
            if progressed and (age_ms(self.clock(), started) >= budget or
                    (self.job is None and self._last_capture is not None and
                     age_ms(self.clock(), self._last_capture) >= self._observation_period())):
                return
            # A camera/UART cycle may itself exceed its target period. Always
            # grant one existing slice, or every cycle can starve fine vision.
            progressed = True
            if self.planning is not None:
                if self.target.get('movement_state') == 'suspected':
                    return
                self._advance_plan()
            elif self.job is not None:
                if self._advance_job():
                    return
                if self.complete is not None:
                    return
            else:
                return

    def _step(self):
        """Advance one cooperative slice; recoverable scenes never end the task."""
        if self.status == 'succeeded':
            return self.snapshot()
        if self.fault is not None:
            return self.snapshot()
        if self._stop_lost_follow():
            return self.snapshot()
        if (self.complete is not None and self.complete['purpose'] == 'moving' and
                (self.complete['observation'].get('status') == 'localized' or
                 self.complete['observation'].get('range_candidate'))):
            self._handoff_moving_precise()
            return self.snapshot()
        started = self.clock()
        vision_paused = self._vision_paused_for_grip(
            self.arm.snapshot() if self.arm is not None else None)
        if (self.state.get('run') and
                ((self.drive._fine_request or {}).get('stopped_for_verification') or
                 self.drive._motion_hold) and
                ((self.job is not None and self.job['purpose']=='moving') or
                 (self.complete is not None and self.complete['purpose']=='moving'))):
            # Consume a stop discovered at the last JPEG/native yield before
            # any new solve, optional observation or final fresh camera check.
            try:
                self._command('STOP')
                self._record('tracking_fine_motion_stop',dict(
                    reason=(self.decision or {}).get('status'),
                    frame_id=((self.job or self.complete).get('paired_coarse') or {}).get('frame_id'),
                    plan=(self.decision or {}).get('plan'),motor_state=dict(self.state)))
            except Exception as exc:
                self._fault('fine_motor_feedback',exc)
            return self.snapshot()
        observed = not vision_paused and self.job is None and (self._last_capture is None or self._fresh_before_arm or self._force_observe or
                    (self.complete is not None and
                     not (self.decision or {}).get('precise_deferred')) or
                    age_ms(started, self._last_capture) >= self._observation_period())
        image = frame = None
        if observed:
            # These two handoffs retain a current chassis sample as well as a
            # current coarse frame; ordinary stationary observations do not.
            image, frame = self._observe(force_status=
                self._fresh_before_arm or self.complete is not None)
            self._force_observe = False
            if self.fault is None and self._stop_lost_follow():
                return self.snapshot()
            if (self.fault is None and self._owned_forward() and
                    0<self._missing<self.loss_confirmation_frames):
                # Keep only the already authorized finite MCU segment during
                # a one/two-frame gap. Memory's real edge-exit/version remains
                # intact, without making it an immediate control STOP/search.
                self.decision=dict(phase=self.drive.phase,status='transient_target_loss',
                    command='HB',target_version=self.memory.version,allow_arm=False)
                self._command('HB')
                return self.snapshot()
            if self.fault is None:
                event = dict(self.target)
                # An unknown center loss is first observed, not called an exit.
                # Once stopped, ordinary confirmation frames may start looking.
                if (self.arm is None and self.planning is None and not self.state['run'] and self.job is None and
                        (not event['anchor_valid'] or self.drive.phase in
                         ('settling','observing','observe','visual_tracking','fine_static')) and self._missing >=
                        self.loss_confirmation_frames):
                    # Loss is decided after the original stopped confirmation
                    # count. An old completed query cannot hold identity wait
                    # forever when there is no matching current target region.
                    if self.complete is not None and self.complete['purpose']=='static':
                        self.complete=None
                        self.drive.cancel_fine()
                    event['search'] = True
                eligible = self.complete if (self.target.get('target_valid') or
                                              self.target.get('precise_candidate')) else None
                if eligible is not None:
                    source = eligible['observation']
                    increments = self.drive.odometry.since(
                        source.get('capture_timestamp_ms',self.clock()),
                        self.coarse['capture_timestamp_ms'])
                    # Near-cycle coarse displacement does not classify target
                    # movement, but a completed stopped image must still match
                    # the CURRENT view before binding or handing it to the arm.
                    # This rejects only that image, without changing the epoch
                    # or interrupting an already issued correction ARC.
                    consistency = self.memory.precise_consistency(source,
                        eligible['paired_coarse'],increments,require_current=(
                            eligible['purpose']=='static' and not self.state.get('run')))
                    eligible['current_consistency'] = consistency
                    if consistency == 'changed':
                        fine_point = (source.get('cube_center_Base_mm') or
                            (source.get('range_candidate') or {}).get('raw_center_Base_mm'))
                        audit = dict(source=self._coarse_audit(eligible['paired_coarse']),
                            current=self._coarse_audit(self.coarse),
                            fine_status=source.get('status'),
                            fine_association=(source.get('target_association') or {}).get('status'),
                            fine_center_Base_mm=fine_point,
                            wheel_delta_mm=[sum(row[k] for row in increments) for k in (0,1)],
                            memory_residual_px=self.target.get('residual_px'),
                            memory_residual_distance_fraction=self.target.get('residual_distance_fraction'))
                        purpose = eligible['purpose']
                        continued = purpose == 'moving' and self._continue_visible_tracking(
                            'fine_current_mismatch')
                        self._record('tracking_fine_current_mismatch',dict(
                            frame_id=source.get('frame_id'),purpose=purpose,
                            continued_follow=continued,audit=audit))
                        # This is a stale capability, not a failed face solve.
                        # Do not turn it into an automatic view-changing move.
                        self.complete = self.last_parking = None
                        if continued:
                            eligible = None
                            event = dict(self.target)
                        else:
                            self.drive.restart_observation(discard_reference=True)
                            self.decision = {'phase':'settling','status':'fine_outdated'}
                            self._force_observe = True
                            if self.state.get('run'):
                                self._command('STOP')
                            return self.snapshot()
                outstanding_request=(self.drive._fine_request or {}).get('request_id')
                following_before_decision = (self.state.get('run') and
                    self.drive._active_action == 'follow' and
                    self.arm is None and self.planning is None)
                recovery_before_decision = (self.drive._bottom_reverse_budget,
                    self.drive._search_reverse_required,self.drive._search_reverse_done)
                self.decision = self.drive.update(self.coarse, self.state, self.clock(),
                    precise=eligible, target_version=self.memory.version,
                    fine_pending=self.job is not None, target_event=event,
                    arm_active=self.arm is not None or self.planning is not None)
                if self.drive._searching and self.drive.anchor is None:
                    self.memory.release_precise()
                    self.target=self.memory.snapshot()
                if self.decision.get('reset_tracker'):
                    self.reset_tracker()
                if self.complete is not None and not self.decision.get('precise_deferred'):
                    self._record('tracking_fine_consumed',dict(
                        purpose=self.complete['purpose'],
                        frame_id=self.complete['observation'].get('frame_id'),
                        offered_request_id=self.complete.get('request_id'),
                        outstanding_request_id=outstanding_request,
                        consumed=self.decision.get('precise_consumed'),
                        anchor_present=self.drive.anchor is not None,
                        command=self.decision.get('command'),
                        static_verification=self.decision.get('static_verification'),
                        correction_plan=self.decision.get('correction_plan'),
                        near_plan=self.decision.get('plan'),
                        correction_reference=self.decision.get('correction_reference'),
                        phase=self.decision.get('phase')))
                drive_event = (self.decision.get('phase'), self.decision.get('status'),
                    (self.decision.get('command') or '').split(',')[0])
                if drive_event != self._last_drive_event:
                    self._last_drive_event = drive_event
                    self._record('tracking_drive', dict(phase=drive_event[0],
                        status=drive_event[1], command=self.decision.get('command'),
                        target_version=self.memory.version,
                        encoder_a=self.state.get('encoder_a'), encoder_b=self.state.get('encoder_b')))
                if self.complete is not None and self.decision.get('precise_consumed'):
                    done = self.complete
                    if (not self.decision.get('return_to_coarse') and
                            not self.decision.get('moving_fine_stopped') and
                            done['observation'].get('target_association', {}).get('status') == 'matched'):
                        bound=self.memory.bind_precise(done['observation'], done['paired_coarse'],
                            done['target_version'], self.drive.odometry.since(
                                done['observation'].get('capture_timestamp_ms', self.clock()),
                                self.coarse['capture_timestamp_ms']))
                        if not bound:
                            self.last_parking=None
                            if done['purpose']=='static' and recovery_before_decision[0] is not None:
                                (self.drive._bottom_reverse_budget,self.drive._search_reverse_required,
                                 self.drive._search_reverse_done) = recovery_before_decision
                            if done['purpose']=='moving' and self._continue_visible_tracking(
                                    'fine_binding_rejected',pending_follow=bool(
                                        following_before_decision and
                                        self.decision.get('command')=='STOP')):
                                self.decision = self.drive.update(self.coarse,self.state,self.clock(),
                                    target_version=self.memory.version,target_event=dict(self.target))
                            else:
                                self.drive.restart_observation(discard_reference=True)
                                self.drive._active_action = None  # Reject the unsent motion decision too.
                                self.decision.update(allow_arm=False,parking=None,phase='settling',
                                    command='STOP' if self.state.get('run') else None)
                            self._force_observe=True
                            self._record('tracking_fine_binding_rejected',dict(
                                frame_id=done['observation'].get('frame_id')))
                if self.decision.get('return_to_coarse'):
                    self.memory.release_precise()
                    self.target = self.memory.snapshot()
                    self.last_parking = None
                if not self.decision.get('precise_deferred'):
                    self.complete = None
                if self.decision.get('command'):
                    try:
                        self._command(self.decision['command'])
                    except Exception as exc:
                        self._fault('motor_command', exc)
                if self.arm is None and self.planning is None and self.fault is None:
                    if self.decision.get('allow_arm'):
                        try:
                            observation = handoff_observation(self.decision['parking'])
                            self.last_parking = self.decision['parking']
                            self._parking_version = self.memory.version
                            self._record('tracking_plan_started', dict(target_version=self.memory.version,
                                frame_id=observation['frame_id']))
                            planning_started = self.clock()
                            candidate = self.begin_arm(observation, self.memory.version)
                            self._arm_motor_reference = dict(self.drive._parking_reference)
                            self.metrics['arm_plans'] += 1
                            if hasattr(candidate, 'snapshot'):
                                # Compatibility with an inert synchronous
                                # factory; also require a new frame after it.
                                self.arm = candidate
                                self._fresh_before_arm = True
                            else:
                                self.planning = {'iterator':iter(candidate),
                                    'target_version':self.memory.version,
                                    'frame_id':observation['frame_id'], 'started_at_ms':planning_started}
                        except ReobserveRequired as exc:
                            self.last_parking = None
                            self.emit('tracking_reobserve', {'reason': str(exc), 'stage': 'arm_plan'})
                            self.drive.restart_observation()
                        except Exception as exc:
                            self._fault('arm_plan', exc)
                    elif (self.decision.get('request_fine') and self.job is None and
                            (self.target.get('target_valid') or
                             self.decision['request_fine']=='static' and
                             self.target.get('precise_candidate'))):
                        self._start_job(self.decision['request_fine'], image, frame)
        elif self.fault is None and self.job is not None and self.state.get('run'):
            try:
                command = 'STOP'
                if self.job['purpose']=='moving':
                    pending = self.drive.pending_fine_motion(self.state,self.clock())
                    command = 'HB' if pending is None else pending['command']
                    if pending is not None:
                        self.decision = pending
                    if (command.startswith('SPEED,') and self._motion_sent_at is not None and
                            0 <= age_ms(self.clock(),self._motion_sent_at) < self.motion_refresh):
                        # Reuse the original lease-refresh slots. A changed
                        # speed replaces HB; exhausted travel stops immediately.
                        command = 'HB'
                self._command(command)
            except Exception as exc:
                self._fault('fine_motor_feedback',exc)
        elif self.fault is None and self._status_due():
            try:
                self._command('STATUS')
                self._check_chassis_reference()
            except Exception as exc:
                self._fault('motor_status', exc)
        if self.fault is None:
            self._step_arm()
            self._resolve_fine_observation()
            self._advance_background()
        self.metrics['max_step_ms'] = max(self.metrics['max_step_ms'], age_ms(self.clock(), started))
        return self.snapshot()

    def step(self):
        started = self.clock()
        try:
            return self._step()
        except Exception as exc:
            self._fault('tracking_io', exc)
            return self.snapshot()
        finally:
            self.metrics['max_step_ms'] = max(self.metrics['max_step_ms'], age_ms(self.clock(), started))

    def snapshot(self):
        state = self.arm.snapshot() if self.arm is not None else None
        return {'schema': 'aic.robot.tracking.v1', 'status': self.status,
            'target_version': self.memory.version, 'target': self.memory.snapshot(),
            'phase': 'fault_wait' if self.fault is not None else
                state['phase'] if state else ('planning' if self.planning is not None else
                      (self.decision or {}).get('phase', 'observe')),
            'motor_state':dict(self.state),
            'planning_pending':self.planning is not None, 'fine_pending':self.job is not None,
            'arm_started': self.metrics['arm_attempts'] > 0, 'arm_state': state,
            'parking': self.last_parking or (self.decision or {}).get('parking'),
            'vision_paused_for_grip':self._vision_paused_for_grip(state),
            'grasp_confirmed': (state or {}).get('grasp_confirmed'),
            'grip_confirmation': (state or {}).get('grip_confirmation'),
            'physical_grasp_confirmed': False, 'fault_wait': self.fault,
            'timeline': list(self.timeline),
            'motion_wait_reason': (self.decision or {}).get('motion_wait_reason'),
            'arc_timeouts': self.drive.arc_timeouts, 'last_arc_end': self.drive.last_arc_end,
            'corrections': self.drive.corrections, 'metrics': dict(self.metrics)}

    def close(self):
        try:
            self._cancel_job('task_closed')
        finally:
            try:
                self._cancel_plan('task_closed')
            finally:
                try:
                    self._command('STOP')
                finally:
                    if self.arm is not None:
                        self.arm.close()


def run_tracking(*args, sleep_ms=None, **kwargs):
    task = TrackingTask(*args, **kwargs)
    try:
        while task.status != 'succeeded':
            task.step()
            delay = task.idle_delay_ms()
            if sleep_ms and delay:
                sleep_ms(delay)
        return task.snapshot()
    finally:
        task.close()
