WHU-SAS/aic-robot/device/k230/car/align_voice.py

"""One wake -> selected coarse approach or continuous near parking task."""
import gc
import json
import os
import time


def archive_fine_frames(config, frames, status, error=None):
    """Called after camera/UART close; original JPEGs never enter JSON logs."""
    if not frames:
        return None
    try:
        try:
            from evidence import EvidenceRun
        except ImportError:
            from device.k230.vision.evidence import EvidenceRun
        run = EvidenceRun('/sdcard/aic/vision/evidence', 'car_near', config,
                          version=config.get('runtime_version'))
        for item in frames:
            run.save_jpeg(item['label'], item['jpeg'], item['frame'], item['observation'])
        run.finish(status, error)
        return {'directory':run.directory, 'frame_count':len(frames)}
    except Exception as exc:
        print('CAR_NEAR archive_error ' + str(exc))
        return {'archive_error':str(exc)}
    finally:
        frames.clear()


def observe(config, projection, camera):
    from vision_runtime import track_coarse
    from blue_tracker import BlueTracker
    tracker = BlueTracker(config['tracking'], projection)
    for unused in range(config['alignment']['observation_frames']):
        os.exitpoint()
        image, frame = camera.capture()
        observation = track_coarse(image, frame, tracker.detect_frame)
        if observation['status'] == 'tracking':
            break
        time.sleep_ms(config['alignment']['frame_interval_ms'])
    return observation
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
