WHU-SAS/aic-robot/(commit log)

2026-09-30 Initial mechanical arm reference
    [genkiarm.urdf]
2026-09-30 Initial car motor and encoder demo
    [MSPM0_SDK_syscfg_menu_import.cfg]
2026-09-30 Document car hardware and track all hardware info
2026-09-30 Place mechanical arm references under arm
    [genkiarm.urdf]
2026-10-04 Document FEETECH servo debug and resource links
2026-10-13 feat: add K230 car-arm cube pick module
    [AAA.stl, BBB.stl, CCC.stl, CCC2.stl, DDD.stl, EEE.stl, FFF.stl, genkiarm.urdf]
2026-10-13 fix: exclude local dependency links from car-arm
2026-10-19 feat: add hardware bring-up records and UART test programs
2026-10-19 refactor: organize device host tools configs and shared resources
    [AAA.stl, BBB.stl, CCC.stl, CCC2.stl, DDD.stl, EEE.stl, FFF.stl, genkiarm.urdf]
2026-10-19 fix: preserve Python entry executable modes during migration
    [offline_check.py]
2026-10-19 fix: audit migrated paths and trim redundant documentation
    [user_selected_pid_demo_baseline.json]
2026-10-19 docs: consolidate guides and make current project status clear
2026-10-20 test: prepare Linux K230 MSPM0 UART link validation
2026-10-20 docs: record K230 MSPM0 UART pass and startup packet issue
2026-10-20 docs: record Linux breakpoint and UART validation
2026-10-20 docs: record Linux motor and encoder bench validation
2026-10-20 fix: resynchronize UART requests after startup noise
    [build.py, main.c, uart_request_parser.h]
2026-10-20 feat: control motor bench from K230 over UART
2026-10-20 test: verify B21 stops remote motor operation
2026-10-20 docs: record verified left right wheel mapping
2026-10-20 feat: add nominal chassis conversion and short forward test
    [k230_motor_uart.py, test_motor_interop.py]
2026-10-20 feat: send arm ready pose through K230 and adopt live PID
    [user_selected_pid_demo_baseline.json]
2026-10-20 Record documented chassis track width of 119.2 mm
2026-10-22 Add formal fixed-tip cube-top raw calibration capture
    [capture_fixed_tip_top.py, collect_fixed_tip_top.py, test_fixed_tip_top.py]
2026-10-22 Add PC full-pick validation with formal tip-top calibration
2026-10-22 Align PC pick descent with open fingertip midpoint
2026-10-22 Apply user-selected 30mm cube offset toward fixed jaw
    [pick_validation_pc.py, test_pick_validation_pc.py]
2026-10-22 Increase user-selected fixed-jaw offset to 50mm
    [test_pick_validation_pc.py]
2026-10-22 Set user-selected fixed-jaw offset to 45mm
    [test_pick_validation_pc.py]
2026-10-22 Record user-accepted 45mm PC pick baseline
2026-10-22 Fix standalone wake startup and report active listening
    [app.py, k230_status.py, test_k230_status.py, test_standalone_pick.py]
2026-10-22 Fix MicroPython arm event logging before pick dispatch
    [app.py, test_standalone_pick.py]
2026-10-22 Dispatch voice ready pose directly without servo checks
2026-10-22 Preserve torque state when dispatching ready pose
2026-10-22 Reduce cumulative fixed-jaw pick offset to 40 mm
    [test_pick_validation_pc.py, test_standalone_pick.py]
2026-10-22 Set approved cumulative fixed-jaw offset to 42 mm
    [test_pick_validation_pc.py, test_standalone_pick.py]
2026-10-22 Restore cumulative fixed-jaw offset to 45 mm
    [test_pick_validation_pc.py, test_standalone_pick.py]
2026-10-22 fix(vision): separate connected table reflections using measured face edges
    [test_blue_side_edges.py, vision_reflection_cases.py]
2026-10-22 fix(vision): reject combined cube faces before pose acceptance
    [vision_standalone_cases.py]
2026-10-22 fix(vision): prefer verified adjacent side over bright top contour
    [vision_standalone_cases.py]
2026-10-22 fix(vision): separate adjacent side faces and refine measured poses
    [vision_reflection_cases.py, vision_standalone_cases.py]
2026-10-22 fix(vision): associate overlapping shared edges despite trimmed top corners
    [vision_standalone_cases.py]
2026-10-22 fix(vision): verify top-face boundaries against original image edges
    [test_blue_side_edges.py, vision_reflection_cases.py]
2026-10-23 Add fixed three-pose PID comparison runner
    [pid_three_actions.json]
2026-10-23 Adopt user-selected axis 2 and 3 PID baseline
    [user_selected_pid_demo_baseline.json]
2026-10-23 Record one non-gating servo snapshot before grip closure
2026-10-23 Resolve tabletop cube pose ambiguity using calibrated plane geometry
    [app.py, vision_side_policy_cases.py]
2026-10-23 Set user-requested axis 4 P to 20 for comparison
    [user_selected_pid_demo_baseline.json]
2026-10-23 Plan independent stage pitches while keeping wrist roll fixed
    [k230_status.py]
2026-10-23 Exclude open gripper error from descent arrival gate
    [pick_stage.py, test_standalone_pick.py]
2026-10-23 Validate open finger volumes before cube descent
2026-10-23 Include arrival tolerances in finger collision planning
2026-10-23 Add read-only fixed-point tool reference audit
    [capture_fixed_tip_top.py, collect_fixed_tip_top.py]
2026-10-24 Share coarse and precise vision contracts and single-owner camera
2026-10-24 Add bounded independent-wheel motor pulses and v1-compatible client
2026-10-24 Add coarse tracking and camera-centered stop-observe approach planning
2026-10-24 Refine far-cube color filtering and annotate native K230 replay results
2026-10-24 Preserve live tracking frames on SD and export timed demonstration videos
2026-10-24 Anchor frame-matched demonstration data labels to tracked cube boxes
2026-10-24 Condense arm and shared vision guides to current behavior
2026-10-30 Add physically aligned arm model validation profile
    [genkiarm_corrected.urdf]
2026-10-30 Preserve vision evidence and add local hard-case replay
2026-10-30 Add standalone continuous car approach and near parking baseline
    Connect continuous coarse steering, one moving physical-side distance solve,
    encoder compensation and static parking-window verification. Preserve the
    user-accepted 70/60/40 mm/s profile and one-correction limit, without automatic
    arm handoff. Include the shared vision modules and both deployment closures.
    Add MCU distance, turn and continuous wheel-speed control with protocol tests;
    retain the existing stop behavior and the separately approved FOLLOW time limit.
    Keep demonstration capture on hardware H.264 with frame-matched PC annotations.
    Update current usage, limitations and the direct Git delivery workflow.
    Validation: 4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
    [align_voice.py, bridge.c, continuous_approach.py, continuous_math.py, follow_control.h]
2026-10-30 Integrate standalone car approach and arm pick
    Reuse the accepted final static observation for arm planning after continuous approach and parking. Preserve the accepted motion parameters and add a strict static contour retry for rounded cube edges, with combined deployment and regression coverage.
2026-10-31 Reuse current arm stages in PC model validation
2026-10-31 Shift parking destination toward the arm by a quarter depth
    Use the near-quarter point of the existing inset window for approach and the single correction. Preserve full-window acceptance, speed profiles and same-frame arm handoff.
    [near_control.py, test_car_near_control.py, test_car_near_runtime.py]
2026-10-31 Set 25-degree gripper opening and run trial vision on K230
2026-10-31 Promote corrected arm geometry and paired robot calibration
    [align_voice.py, app.py, continuous_approach.py, continuous_math.py, ground_projection.py, near_control.py]
2026-10-31 fix(vision): recover rounded and narrow sides within scan budget
    [test_physical_side_seed_recovery.py]
2026-10-31 feat(arm): apply authorized 3mm fixed-jaw centering offset
    [test_arm_model_alignment.py, test_pick_pc_direct.py, test_pick_validation_pc.py, test_robot_bundle.py, test_standalone_pick.py, test_wrist_pc.py, test_wrist_rotation.py]
2026-10-31 fix(arm): prefer the nearer cube face pair before upright tilt
    [test_wrist_rotation.py]
2026-10-31 chore(arm): increase fixed-jaw centering offset to 5mm
    [test_arm_model_alignment.py, test_pick_pc_direct.py, test_pick_validation_pc.py, test_robot_bundle.py, test_standalone_pick.py, test_wrist_pc.py]
2026-10-31 fix(arm): exit ready command immediately after dispatch
    [ready_pose.py, test_k230_ready_transport.py]
2026-10-31 Promote accepted arm stage to complete robot default
2026-10-31 Enable inactive arm torque before ready dispatch
2026-10-31 Handle near starts and keep one-shot corrections within the parking window
    [near_control.py, near_runtime.py, test_car_forward_axis.py, test_car_near_control.py, test_car_near_runtime.py, test_physical_side_seed_recovery.py]
2026-10-31 Record precise parking rejection reasons and static encoder samples
2026-10-31 Allow negligible encoder drift during static parking localization
    [near_runtime.py, test_car_near_runtime.py]
2026-10-31 Remove empirical arm finger-side offset across current profiles
2026-10-31 Recover coherent side edges from existing static image samples
2026-11-02 Add dual ready poses and immediate voice-triggered arm response
2026-11-02 Confirm gripper contact from stable servo6 goal delta
2026-11-02 Correct parking toward fixed goal with signed wheel arcs
    [bridge.c, main.c, motor_protocol.h, near_control.py, near_runtime.py, remote_control.h, straight_control.h, test_car_forward_axis.py]
2026-11-02 Document arm recovery requirements for persistent tracking
2026-11-02 Record pending arm recovery and lift confirmation proposal
2026-11-02 Record confirmed arm lift arrival contract
2026-11-02 Add cooperative arm execution for persistent tracking
2026-11-02 Separate UART read time from arm observation gaps
2026-11-02 Reduce arm startup latency with ready-pose planning and bounded static recovery
2026-11-02 Fix tracking interruptions and repeated static handoff work
    [target_memory.py, test_car_target_memory.py, test_car_tracking_drive.py, test_physical_side_seed_recovery.py, test_robot_tracking.py, tracking.py, tracking_drive.py]
2026-11-02 Improve fixed-target tracking startup and continuous approach
    [app.py, target_memory.py, test_car_target_memory.py, test_car_tracking_drive.py, test_robot_app.py, test_robot_tracking.py, test_robot_tracking_bundle.py]
2026-11-02 Recover timed-out arcs and avoid low-PWM startup latch
    [straight_control.h, test_car_tracking_drive.py, test_robot_tracking.py, test_straight.c, tracking.py, tracking_drive.py]
2026-11-02 fix(tracking): preserve search progress and confirm one candidate
    [blue_tracker.py, target_memory.py, test_car_tracking_drive.py, test_car_tracking_reacquisition.py, test_car_visual_evidence.py, test_robot_tracking.py, tracking.py, tracking_drive.py]
2026-11-02 fix(vision): associate fine results with the selected coarse target
    [blue_tracker.py, test_candidate_association.py, test_car_near_vision.py, test_car_tracking_reacquisition.py]
2026-11-02 fix(tracking): recover near targets and search continuously
    [blue_tracker.py, follow_control.h, motor_protocol.h, remote_control.h, target_memory.py, test_car_target_memory.py, test_car_tracking_drive.py]
2026-11-03 fix(tracking): prioritize fine vision and stabilize target recovery
    [near_runtime.py, target_memory.py, test_car_calibration_pairing.py, test_car_forward_axis.py, test_car_near_control.py, test_car_near_evidence.py, test_car_near_runtime.py, test_car_target_memory.py]
2026-11-03 perf(tracking): acquire candidates in one frame and compact runtime config
2026-11-03 fix(tracking): keep following visible target position updates
    [target_memory.py, test_car_target_memory.py, test_car_tracking_drive.py, test_car_tracking_reacquisition.py, test_fine_observation_pause.py, test_robot_tracking.py, test_visible_retarget_task.py, tracking.py]
2026-11-03 fix(tracking): continuously restore bottom target view before localization
    [test_bottom_recovery_fine_gap.py, test_bottom_search_reverse.py, test_car_tracking_drive.py, test_global_bottom_recovery_task.py, tracking.py, tracking_drive.py]
2026-11-03 fix(tracking): bound travel while fine localization is pending
    [test_fine_observation_budget.py, test_k230_script_stop.py, test_pending_fine_motion.py, test_robot_tracking.py, tracking.py, tracking_drive.py]
2026-11-03 fix(tracking): check near travel before JPEG and reject blue print targets
    [blue_tracker.py, ground_projection.py, target_memory.py, test_car_cube_shape.py, test_car_tracking_drive.py, test_car_tracking_reacquisition.py, test_car_visual_evidence.py, test_fine_observation_pause.py]
2026-11-03 fix(car): stop finite follow travel on MCU during vision computation
    [bridge.c, follow_cap_cases.h, follow_control.h, main.c, motor_protocol.h, near_control.py, remote_control.h, test_bounded_follow_native.py]
2026-11-03 Pause tracking vision during gripper closure and lift
2026-11-03 Record verified gripper vision pause deployment
2026-11-04 Add prompted lit near-view collection without actuator commands
2026-11-04 fix(car): finish measured corrections before static revalidation
    [target_memory.py, test_car_tracking_drive.py, test_correction_context_tracking.py, test_correction_motion_memory.py, test_fine_observation_budget.py, test_global_bottom_recovery_task.py, test_robot_tracking.py, test_static_fine_current_image.py]
2026-11-04 fix(car): reject blue noise and stop after confirmed target loss
    [test_bottom_recovery_fine_gap.py, test_bottom_search_reverse.py, test_car_tracking_drive.py, test_car_tracking_reacquisition.py, test_correction_context_tracking.py, test_global_bottom_recovery_task.py, test_robot_tracking.py, test_target_loss_search.py]
2026-11-08 docs: showcase three robot demos with hosted video attachments
2026-11-09 docs: expand showcase with calibration and geometric vision images
2026-11-09 docs: finalize project showcase without calibration images
2026-11-09 docs: document human-led AI collaboration and engineering corrections
